notaroomba/keybytes/assets/readme/keyboard.png

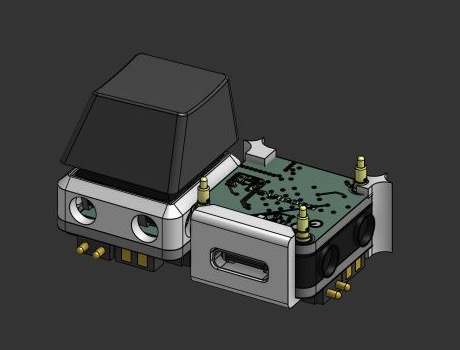
assets/readme/keyboard.png
