notaroomba/keybytes/assets/render.png

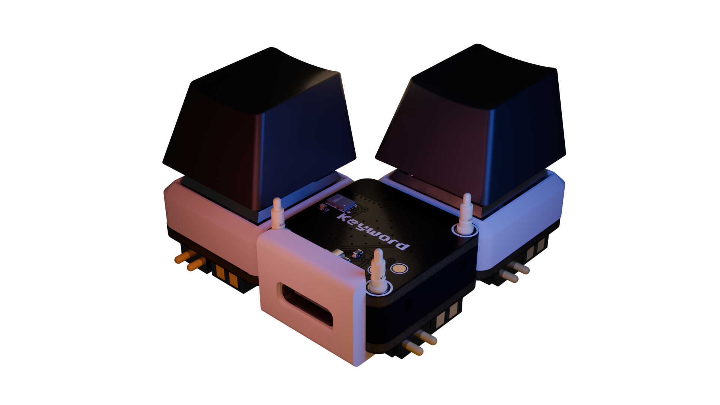
assets/render.png
