notaroomba/keybytes/hardware/panels/8x3-panel/8x3-panel-bottom.png

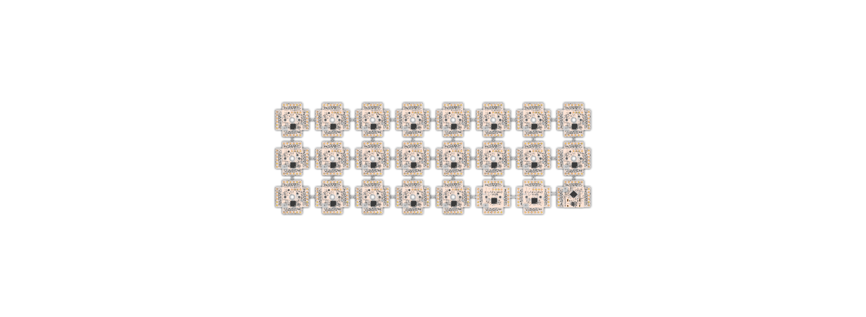
hardware/panels/8x3-panel/8x3-panel-bottom.png
