notaroomba/keybytes/hardware/panels/spacer-panel/spacer-panel-bottom.png

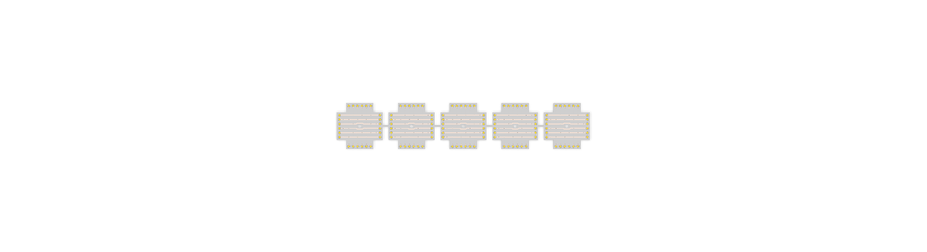
hardware/panels/spacer-panel/spacer-panel-bottom.png
