notaroomba/keybytes/hardware/spacer/spacer-0.5u-bottom.png

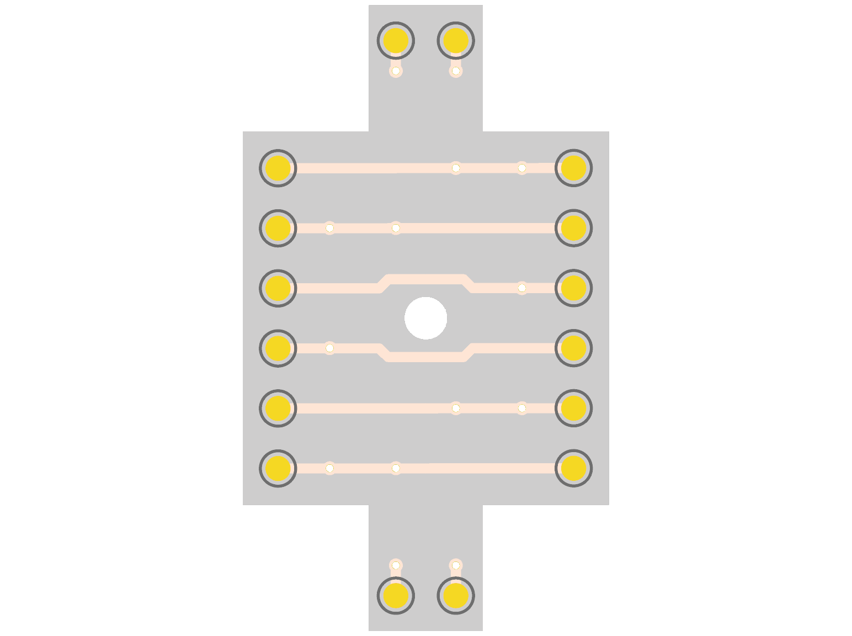
hardware/spacer/spacer-0.5u-bottom.png
