notaroomba/keybytes/hardware/spacer/spacer-0.75u-bottom.png

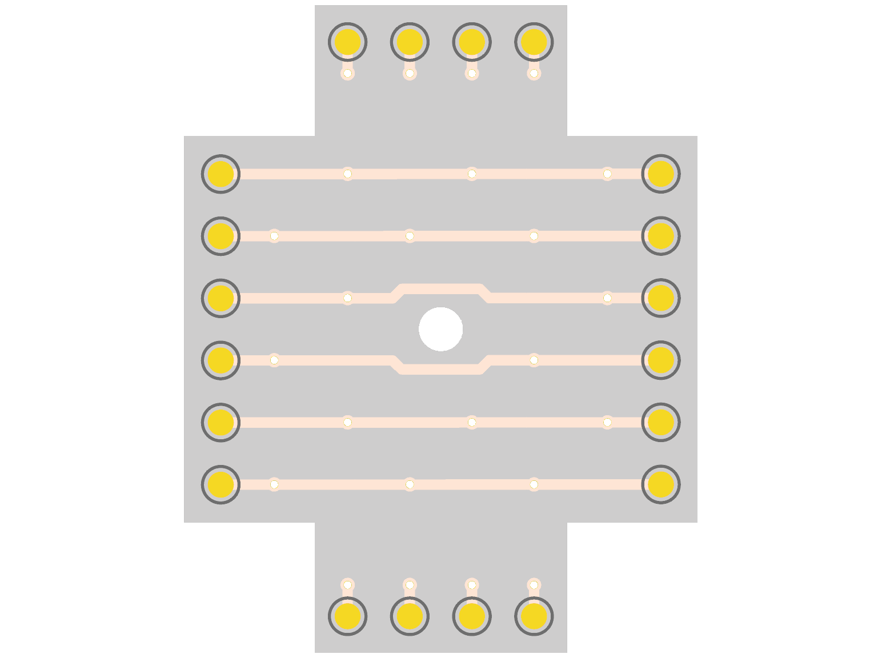
hardware/spacer/spacer-0.75u-bottom.png
