notaroomba/keybytes/hardware/spacer/spacer-0.75u-top.png

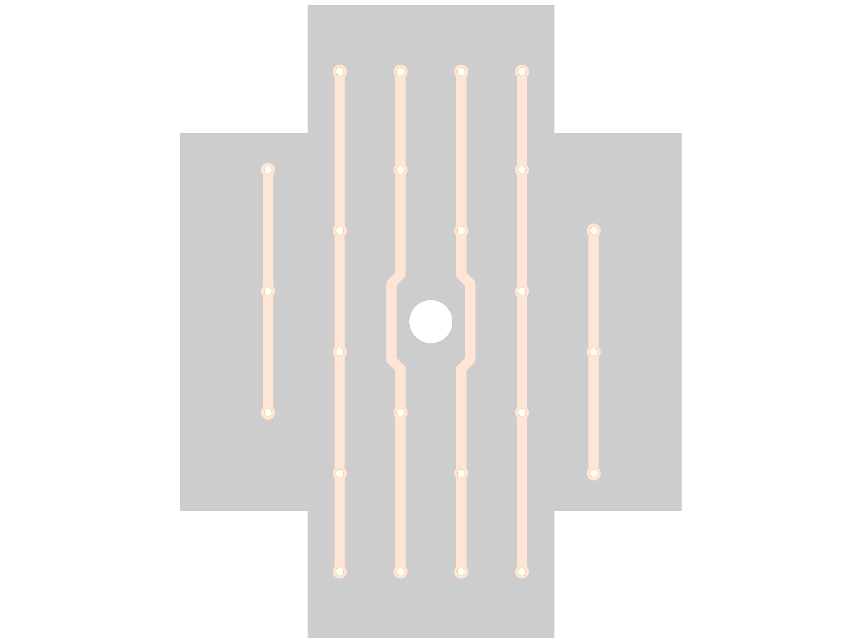
hardware/spacer/spacer-0.75u-top.png
