notaroomba/keybytes/hardware/spacer/spacer-1u-bottom.png

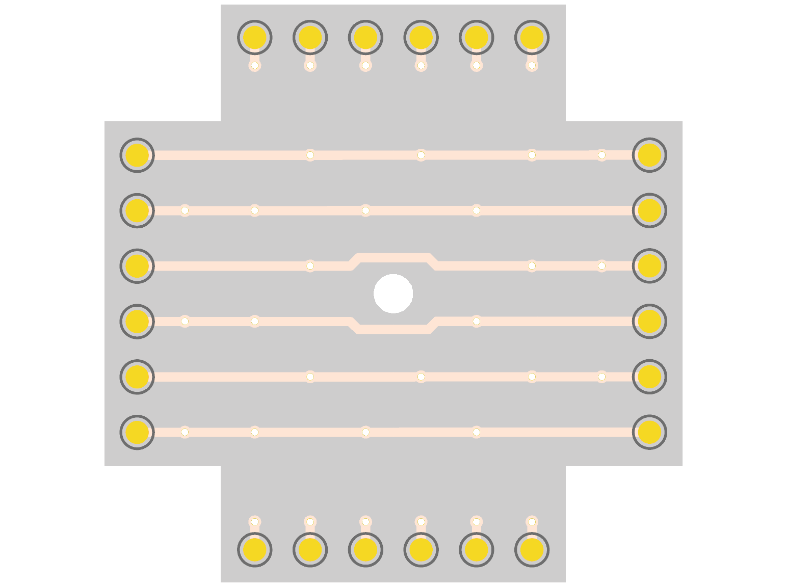
hardware/spacer/spacer-1u-bottom.png
