notaroomba/keybytes/hardware/spacer/spacer-1u-top.png

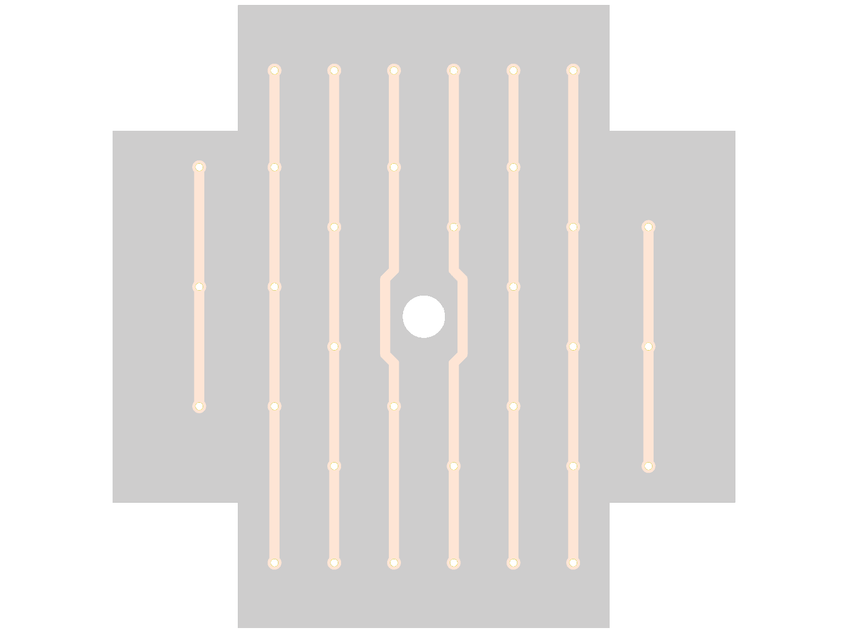
hardware/spacer/spacer-1u-top.png
