notaroomba/keybytes/image.png

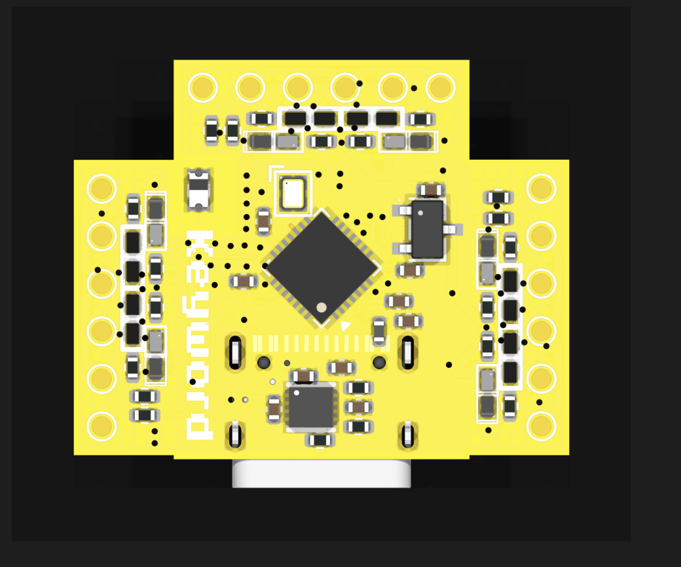
image.png
