notaroomba/keybytes/BOM.csv

Item | Price | Source
Magnets 2x0.5mm (1000pcs) | 8.83 | https://es.aliexpress.com/item/1005009461785489.html
Keybit PCB (5pcs | Black HASL) | 2.00 | https://jlcpcb.com
Keybit PCBA (5pcs | bottom side) | 69.67 | https://jlcpcb.com
Keyword PCB (5pcs | White ENIG) | 30.50 | https://jlcpcb.com
Keyword PCBA (2pcs | both sides) | 203.60 | https://jlcpcb.com
JLCPCB Shipping | 158.17 | https://jlcpcb.com
Total | 472.77
