notaroomba/keybytes/hardware/keybit/production/bom.csv

Designator | Footprint | Quantity | Value | LCSC Part #
ANT1 | ANT-SMD_L1.7-W0.9 | 1 | KH-1608-H08 | C2925416
C10, C11 | 0402 | 2 | 100nF | C1525
C3, C4, C5 | 0402 | 3 | 1uF | C52923
C8 | 0402 | 1 | 470nF | C47339
C9 | 0402 | 1 | 4.7uF | C23733
D2 | LED_WS2812B-2020_PLCC4_2.0x2.0mm | 1 | WS2812B-2020 | C52917434
L1 | 0402 | 1 | 10uH | C48946156
Q10, Q11, Q15, Q16, Q21, Q22, Q27, Q7 | DFN1006-3L_L1.0-W0.6-LS1.0-BR | 8 | CJBA3139K | C504099
Q12, Q13, Q14, Q17, Q18, Q19, Q20, Q23, Q24, Q25, Q26, Q4, Q5, Q6, Q8, Q9 | SOT-883-3_L1.0-W0.6-BR | 16 | PNM3FD20V1E | C2875806
R10, R14, R19, R20, R25, R26, R31, R9 | 0402 | 8 | 1M | C26083
R11, R12, R15, R16, R18, R21, R22, R24, R27, R28, R30, R8 | 0402 | 12 | 100K | C25741
R13, R17, R23, R29 | 0402 | 4 | 300K | C25774
U1 | WQFN-28-1EP_4x4mm_P0.4mm_EP2.7x2.7mm | 1 | CH592F | C39831287
U12, U15 | CONN-TH_3305-2-15-15-47-27-10-0 | 2 | 3305-0-15-15-47-27-10-0 | C17317022
U14 | SOT-23-3_L2.9-W1.6-P1.90-LS2.8-BR | 1 | XC6206P332MR | C5446
U2, U3, U4, U5, U6, U7, U8, U9 | X1-DFN1006-2_L1.0-W0.6-RD | 8 | RB520CS30L,315 | C461213
X2 | CRYSTAL-SMD_4P-L1.6-W1.2-BL | 1 | 7E032000I01 | C781732
