notaroomba/keybytes/production/panels/8x3-panel/bom.csv

Comment | Designator | Footprint | LCSC
100K | KB_R8,KB_R11,KB_R12,KB_R15,KB_R16,KB_R18,KB_R21,KB_R22,KB_R24,KB_R27,KB_R28,KB_R30,KW_R8,KW_R11,KW_R12,KW_R21,KW_R22,KW_R24,KW_R27,KW_R28,KW_R30,R8,R11,R12,R15,R16,R18,R21,R22,R24,R27,R28,R30 | Resistor_SMD:R_0402_1005Metric | C25741
PNM3FD20V1E | KB_Q4,KB_Q5,KB_Q6,KB_Q8,KB_Q9,KB_Q12,KB_Q13,KB_Q14,KB_Q17,KB_Q18,KB_Q19,KB_Q20,KB_Q23,KB_Q24,KB_Q25,KB_Q26,KW_Q4,KW_Q6,KW_Q8,KW_Q9,KW_Q17,KW_Q18,KW_Q19,KW_Q20,KW_Q23,KW_Q24,KW_Q25,KW_Q26,Q4,Q5,Q6,Q8,Q9,Q12,Q13,Q14,Q17,Q18,Q19,Q20,Q23,Q24,Q25,Q26 | lcsc:SOT-883-3_L1.0-W0.6-BR | C2875806
TMAG3001A2YBGR | U10 | lcsc:BGA-6_L1.3-W0.8-P0.40-TL_PTMAG3001A2YBGR | C31115089
CH592F | KB_U1,KW_U1,U1 | Package_DFN_QFN:WQFN-28-1EP_4x4mm_P0.4mm_EP2.7x2.7mm | C39831287
100nF | C10,C11,C12,KB_C10,KB_C11,KW_C10,KW_C11 | Capacitor_SMD:C_0402_1005Metric | C1525
1M | KB_R9,KB_R10,KB_R14,KB_R19,KB_R20,KB_R25,KB_R26,KB_R31,KW_R9,KW_R10,KW_R20,KW_R25,KW_R26,KW_R31,R9,R10,R14,R19,R20,R25,R26,R31 | Resistor_SMD:R_0402_1005Metric | C26083
RB520CS30L,315 | KB_U2,KB_U3,KB_U4,KB_U5,KB_U6,KB_U7,KB_U8,KB_U9,KW_U2,KW_U3,KW_U6,KW_U7,KW_U8,KW_U9,U2,U3,U4,U5,U6,U7,U8,U9 | lcsc:X1-DFN1006-2_L1.0-W0.6-RD | C461213
CJBA3139K | KB_Q7,KB_Q10,KB_Q11,KB_Q15,KB_Q16,KB_Q21,KB_Q22,KB_Q27,KW_Q7,KW_Q10,KW_Q16,KW_Q21,KW_Q22,KW_Q27,Q7,Q10,Q11,Q15,Q16,Q21,Q22,Q27 | lcsc:DFN1006-3L_L1.0-W0.6-LS1.0-BR | C504099
470nF | C8,KB_C8,KW_C8 | Capacitor_SMD:C_0402_1005Metric | C47339
1uF | C3,C4,C5,KB_C3,KB_C4,KB_C5,KW_C3,KW_C4,KW_C5,KW_C6,KW_C7 | Capacitor_SMD:C_0402_1005Metric | C52923
300K | KB_R13,KB_R17,KB_R23,KB_R29,KW_R13,KW_R23,KW_R29,R13,R17,R23,R29 | Resistor_SMD:R_0402_1005Metric | C25774
4.7uF | C9,KB_C9,KW_C9 | Capacitor_SMD:C_0402_1005Metric | C23733
WS2812B-2020 | D2,KB_D2,KW_D2 | LED_SMD:LED_WS2812B-2020_PLCC4_2.0x2.0mm | C52917434
KH-1608-H08 | ANT1,KB_ANT1,KW_ANT1 | lcsc:ANT-SMD_L1.7-W0.9 | C2925416
7E032000I01 | KB_X2,KW_X2,X2 | lcsc:CRYSTAL-SMD_4P-L1.6-W1.2-BL | C781732
XC6206P332MR | KB_U14,KW_U14,U14 | lcsc:SOT-23-3_L2.9-W1.6-P1.90-LS2.8-BR | C5446
10uH | KB_L1,KW_L1,L1 | Inductor_SMD:L_0402_1005Metric | C48946156
4.7K | R32,R33 | Resistor_SMD:R_0402_1005Metric | C25900
YZ87312060R-01 | KW_TP1,KW_TP2,KW_TP3,KW_TP4 | lcsc:POGO-SMD_YZ87312060R-01 | C5157406
5.1K | KW_R4,KW_R6 | Resistor_SMD:R_0402_1005Metric | C25905
50pF | KW_C13 | Capacitor_SMD:C_0402_1005Metric | C49210433
BQ25185DLHR | KW_U5 | lcsc:WSON-10_L2.2-W2.0-P0.40-BL-EP_TI_DLH0010A | C19725033
10K | KW_R3 | Resistor_SMD:R_0402_1005Metric | C25744
10uF | KW_C2 | Capacitor_SMD:C_0402_1005Metric | C6119763
15K | KW_R2 | Resistor_SMD:R_0402_1005Metric | C25756
USB_C_Receptacle_USB2.0_16P | KW_J2 | Connector_USB:USB_C_Receptacle_HCTL_HC-TYPE-C-16P-01A | C2894897
4.7uF\n35V | KW_C1 | Capacitor_SMD:C_0603_1608Metric | C307467
USBLC6-2P6 | KW_U4 | Package_TO_SOT_SMD:SOT-666 | C53059594
13K | KW_R1 | Resistor_SMD:R_0402_1005Metric | C49653083
3305-0-15-15-47-27-10-0 | KB_U12,KB_U15 | lcsc:CONN-TH_3305-2-15-15-47-27-10-0 | C17317022
