notaroomba/keybytes/assets/jlcpcb_order.png

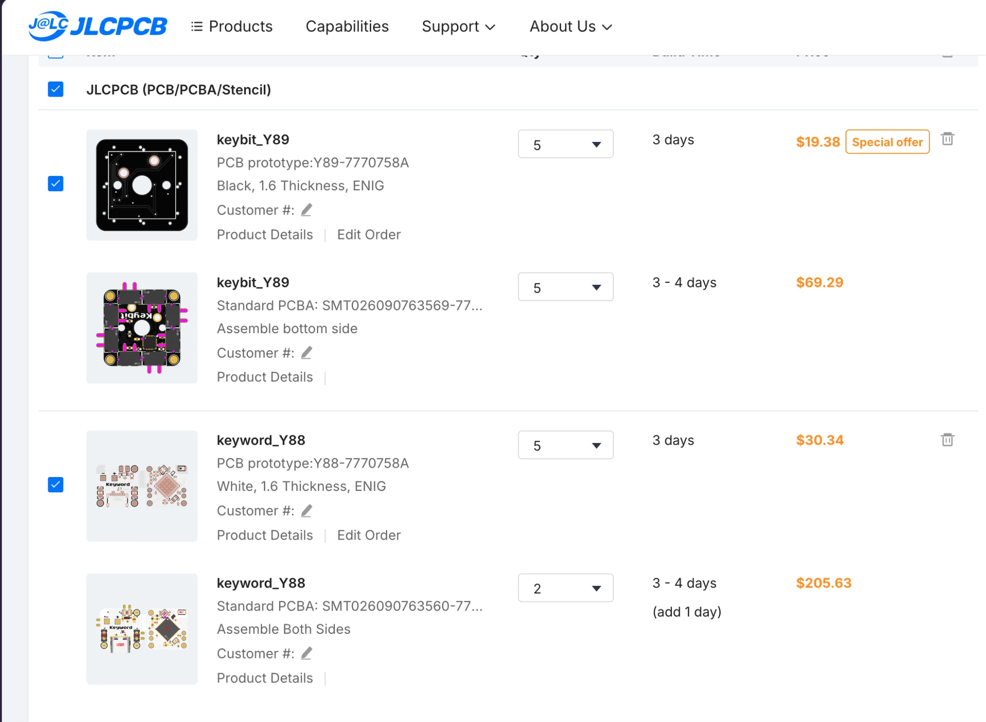
assets/jlcpcb_order.png
