notaroomba/keybytes/cad/keybit/Joystick_Body.step

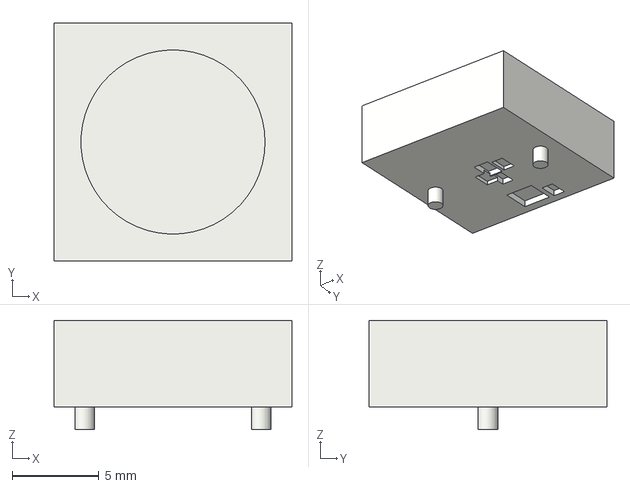
[picture p23: CAD file, 2026-11-13]
cad/keybit/Joystick_Body.step
13.7 x 13.7 x 6.30 mm
