notaroomba/keybytes/cad/keybit/pcb/Keybit_Flex_Folded.step

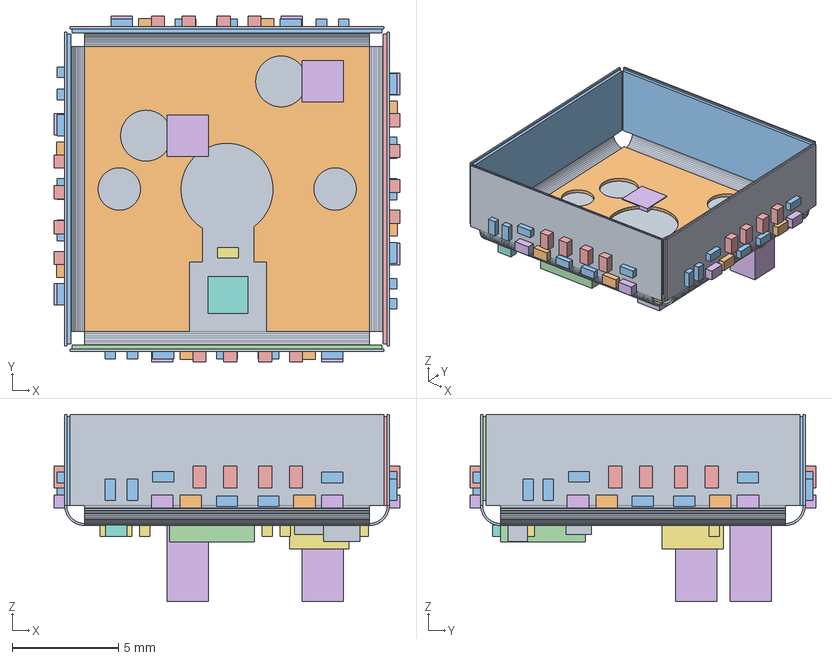
[picture p24: CAD file, 2026-11-13]
cad/keybit/pcb/Keybit_Flex_Folded.step
16.3 x 16.3 x 8.83 mm
Flex
Stiffener
CONN-TH_3305-2-15-15-47-27-10-0 x 2
C_0402_1005Metric x 7
LED_WS2812B_PLCC4_5_0x5_0mm_P3_2mm
CRYSTAL-SMD_4P-L1_6-W1_2-BL
DFN1006-3L_L1_0-W0_6-H0_4-LS1_0-BR x 8
R_0402_1005Metric x 24
QFN-28-1EP_4x4mm_P0_4mm_EP2_4x2_4mm
SOT-883-3_L1_0-W0_6-H0_5-BR x 16
DFN1006_L1_0-W0_6-H0_5 x 8
SOT-23-3L_L2_9-W1_6-H1_1-LS2_8-P0_95
L_0402_1005Metric
ANT-SMD_L1_7-W0_9
