notaroomba/keybytes/cad/Keybit_Case_Big.step

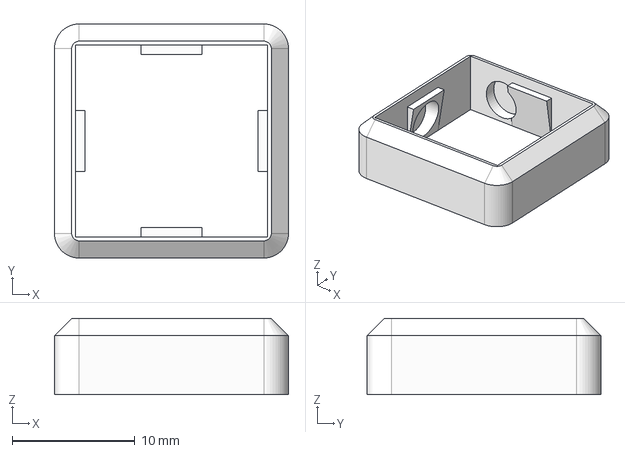
[picture p25: CAD file, 2026-10-25]
cad/Keybit_Case_Big.step
19.1 x 19.1 x 6.20 mm
