notaroomba/keybytes/cad/keyword/Keyword_Base.step

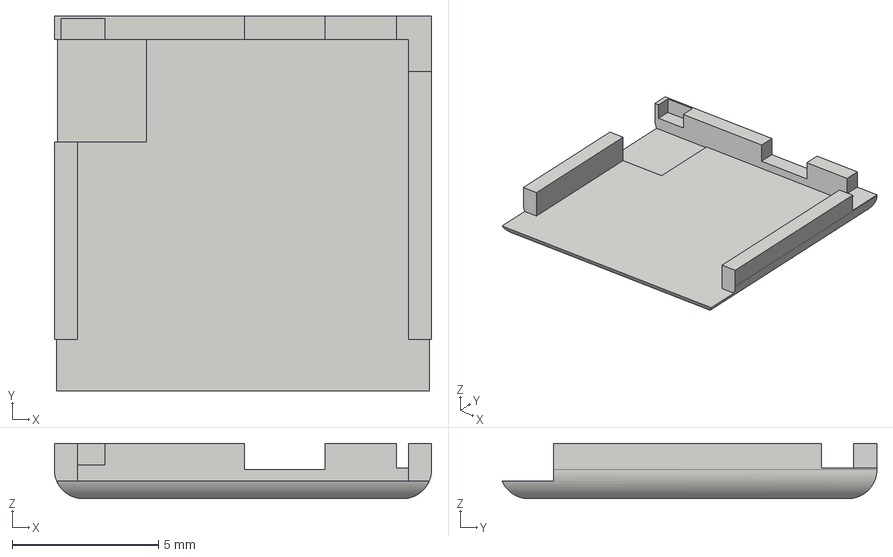
[picture p26: CAD file, 2026-11-13]
cad/keyword/Keyword_Base.step
12.9 x 12.8 x 1.90 mm
