notaroomba/keybytes/cad/keyword/pcb/Keyword_Flex_Folded.step

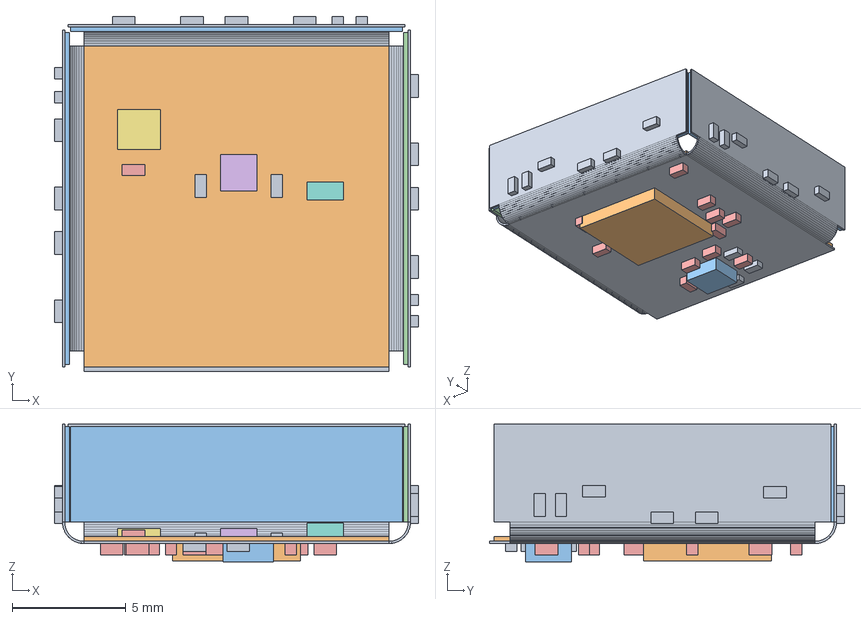
[picture p27: CAD file, 2026-11-13]
cad/keyword/pcb/Keyword_Flex_Folded.step
16.0 x 15.6 x 6.04 mm
Flex
Stiffener
C_0402_1005Metric x 11
SOT-666
LED_WS2812B_PLCC4_5_0x5_0mm_P3_2mm
C_0603_1608Metric
R_0402_1005Metric x 23
QFN-28-1EP_4x4mm_P0_4mm_EP2_4x2_4mm
L_0402_1005Metric
WSON-10_L2_2-W2_0-P0_40-BL-EP_TI_DLH0010
