notaroomba/keybytes/cad/tests/J7.1_keybit_protruding.step

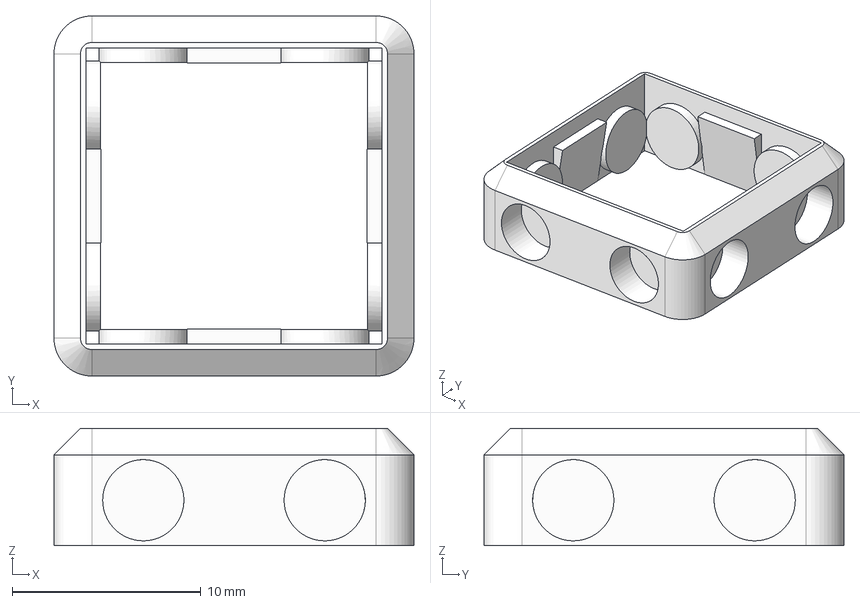
[picture p28: CAD file, 2026-10-25]
cad/tests/J7.1_keybit_protruding.step
19.1 x 19.1 x 6.20 mm
