notaroomba/keybytes/hardware/keybit/keybit.step

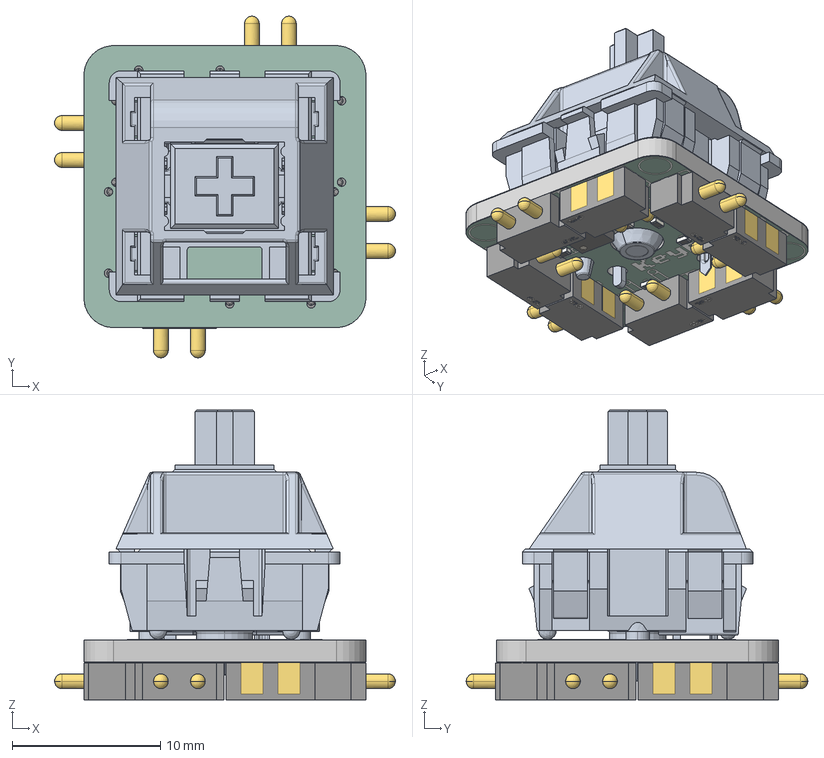
[picture p29: CAD file, 2026-04-08]
hardware/keybit/keybit.step
23.0 x 23.1 x 19.6 mm
MX_DOWN
MX_UP
UP_MX
MX_PIN
MX_SPRING
MX_CLICK
CONN-SMD_YZ13515055F-02025-02 x 8
QFN-16-1EP_3x3mm_P0.5mm_EP1.8x1.8mm
R_0402_1005Metric x 8
C_0402_1005Metric
keybit_copper
keybit_via
keybit_silkscreen x 2
keybit_soldermask x 2
keybit_PCB
