notaroomba/keybytes/production/CAD/Encoder_Body.step

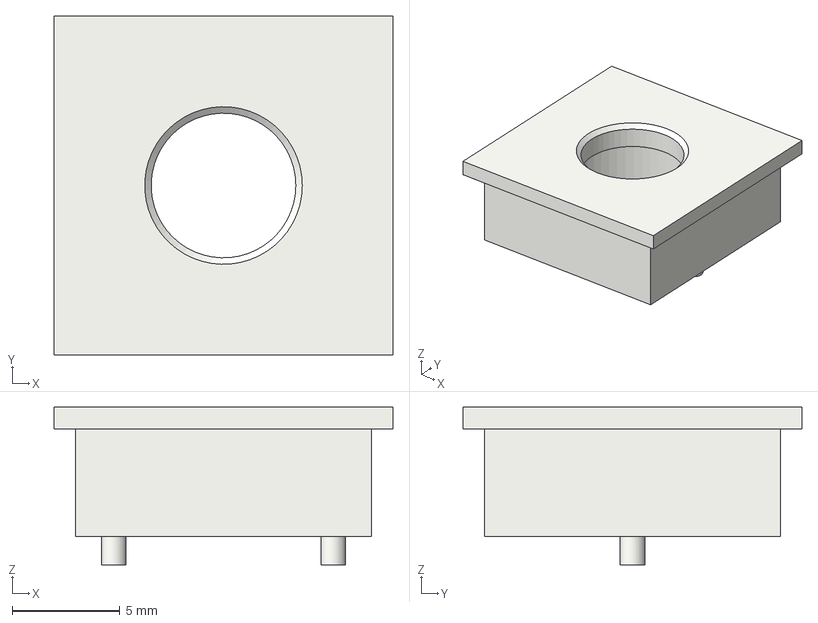
[picture p30: CAD file, 2026-11-13]
production/CAD/Encoder_Body.step
15.7 x 15.7 x 7.30 mm
