notaroomba/keybytes/cad/keybit/Joystick_Deck.step

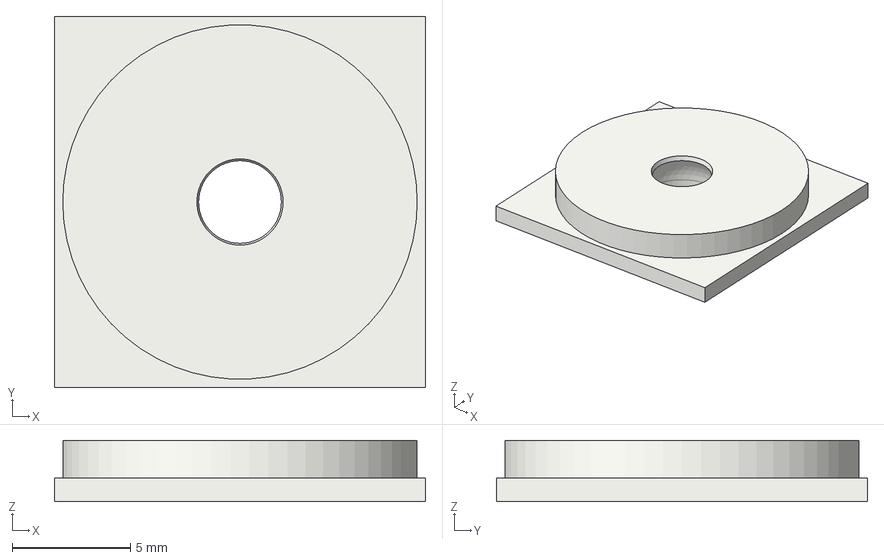
[picture p31: CAD file, 2026-11-13]
cad/keybit/Joystick_Deck.step
15.7 x 15.7 x 2.60 mm
