notaroomba/keybytes/cad/keyword/Keyword_Lid.step

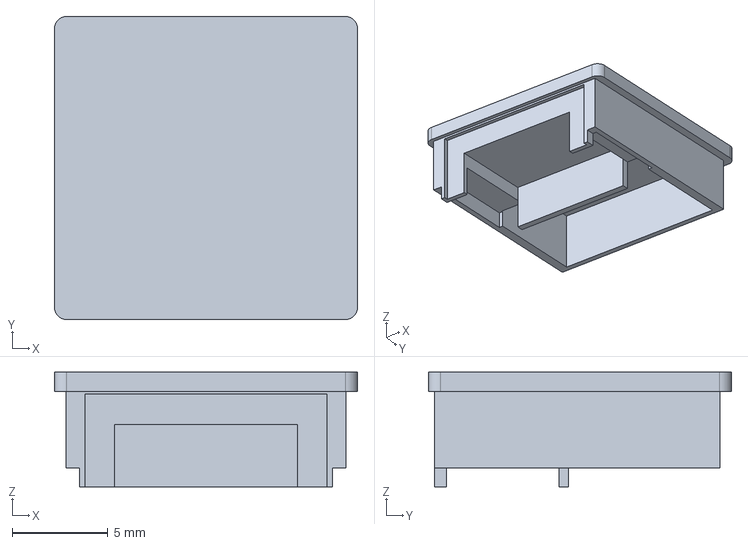
[picture p33: CAD file, 2026-11-13]
cad/keyword/Keyword_Lid.step
15.8 x 15.8 x 5.98 mm
