notaroomba/keybytes/cad/Keyword_Case_Big_Inner.step

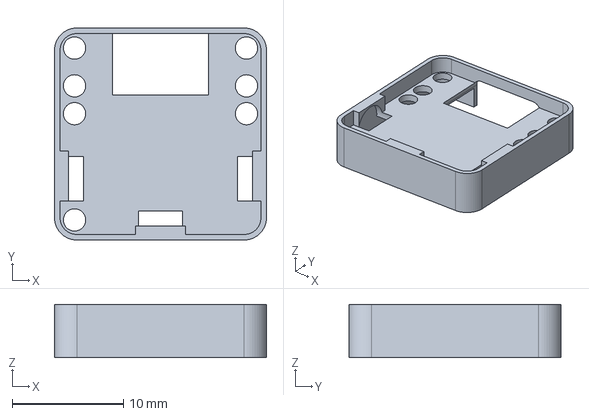
[picture p34: CAD file, 2026-10-25]
cad/Keyword_Case_Big_Inner.step
19.1 x 19.1 x 4.80 mm
