notaroomba/keybytes/cad/tests/J1_magnets_only.step

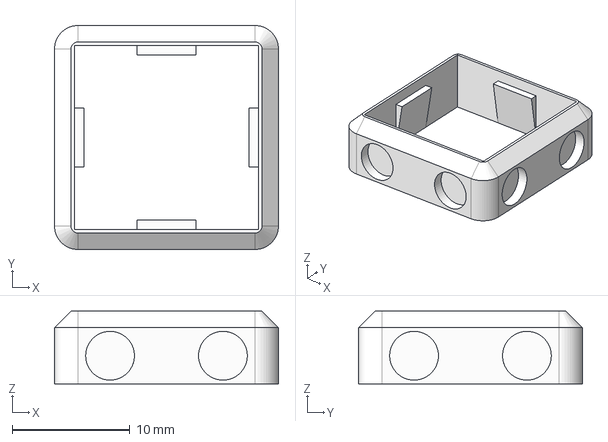
[picture p35: CAD file, 2026-10-25]
cad/tests/J1_magnets_only.step
19.1 x 19.1 x 6.20 mm
