notaroomba/keybytes/production/CAD/Keybit_Shell.step

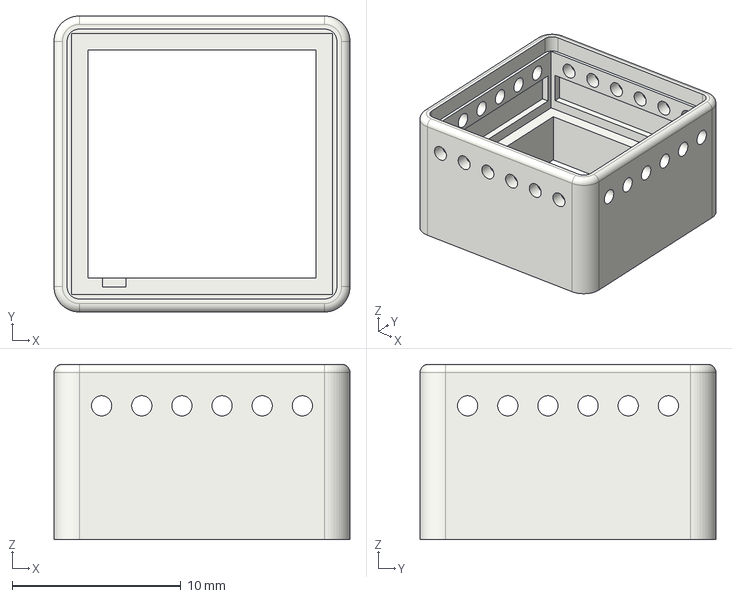
[picture p37: CAD file, 2026-11-13]
production/CAD/Keybit_Shell.step
17.6 x 17.6 x 10.4 mm
