notaroomba/keybytes/cad/keybit/Encoder_Collar.step

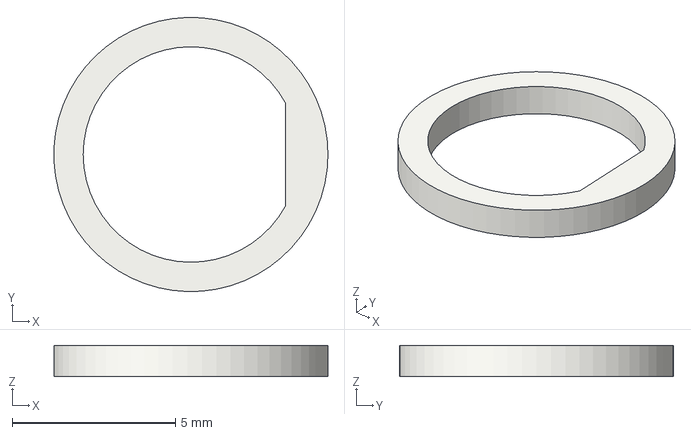
[picture p38: CAD file, 2026-11-13]
cad/keybit/Encoder_Collar.step
8.39 x 8.40 x 0.95 mm
