notaroomba/keybytes/cad/Keyword_Left.step

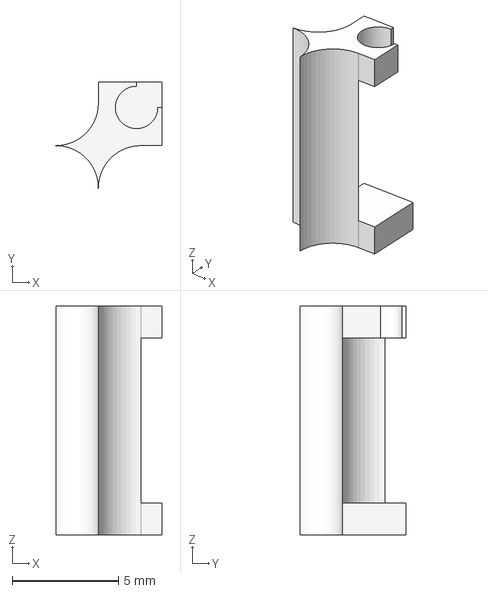
[picture p39: CAD file, 2026-10-21]
cad/Keyword_Left.step
5.00 x 5.00 x 10.8 mm
