notaroomba/keybytes/cad/tests/J5_slip_pegs.step

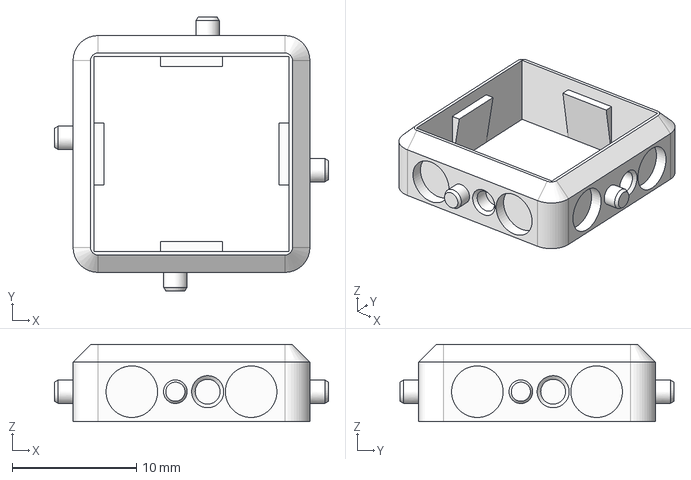
[picture p40: CAD file, 2026-10-25]
cad/tests/J5_slip_pegs.step
22.0 x 22.0 x 6.20 mm
