notaroomba/keybytes/hardware/keybit/keybit_nokey.step

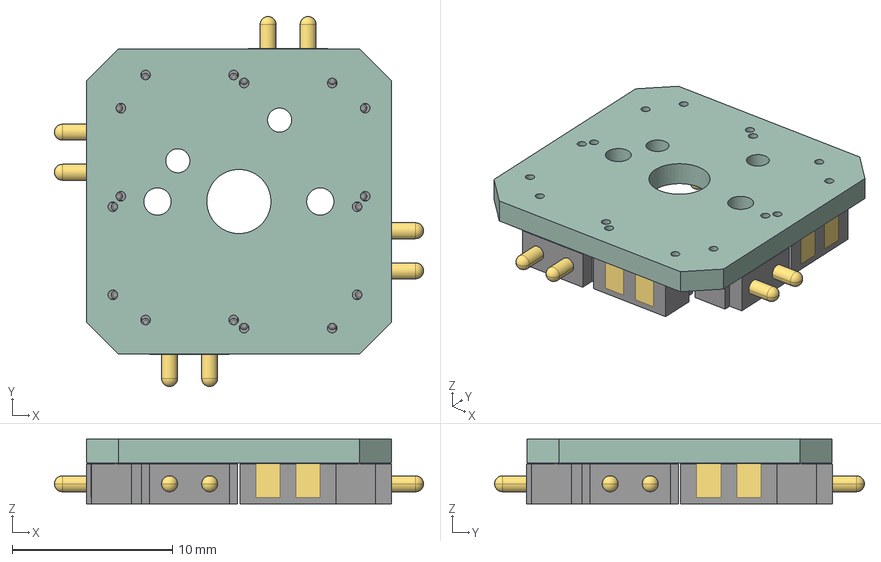
[picture p41: CAD file, 2026-04-06]
hardware/keybit/keybit_nokey.step
23.0 x 23.1 x 4.05 mm
CONN-SMD_YZ13515055F-02025-02 x 8
QFN-16-1EP_3x3mm_P0.5mm_EP1.8x1.8mm
R_0402_1005Metric x 8
C_0402_1005Metric
keybit_PCB
