notaroomba/keybytes/production/CAD/Keyword_Shell.step

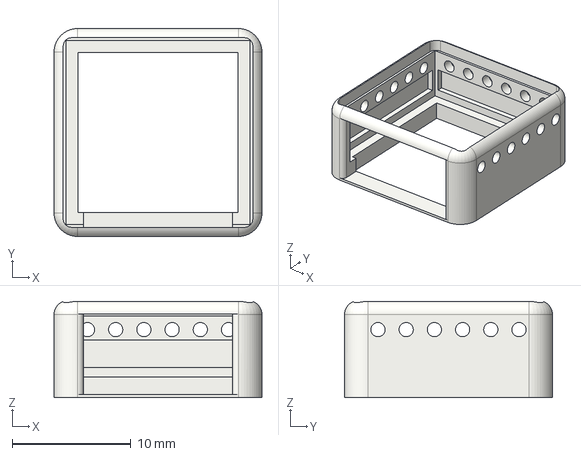
[picture p42: CAD file, 2026-11-13]
production/CAD/Keyword_Shell.step
17.6 x 17.6 x 8.12 mm
