notaroomba/keybytes/cad/keybit/Keybit_Base.step

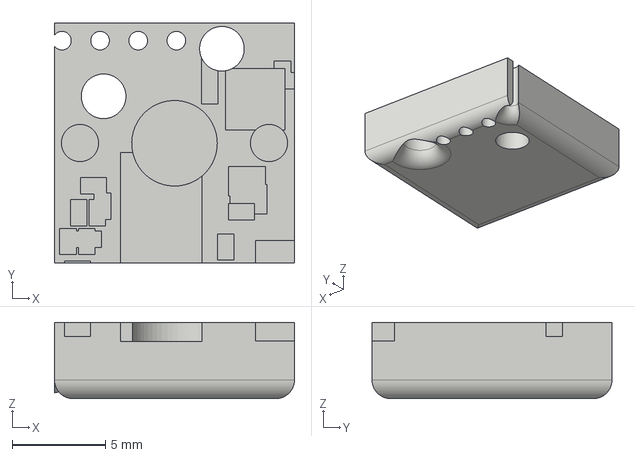
[picture p43: CAD file, 2026-11-13]
cad/keybit/Keybit_Base.step
12.9 x 12.9 x 4.10 mm
