notaroomba/keybytes/cad/Keyword_Case.step

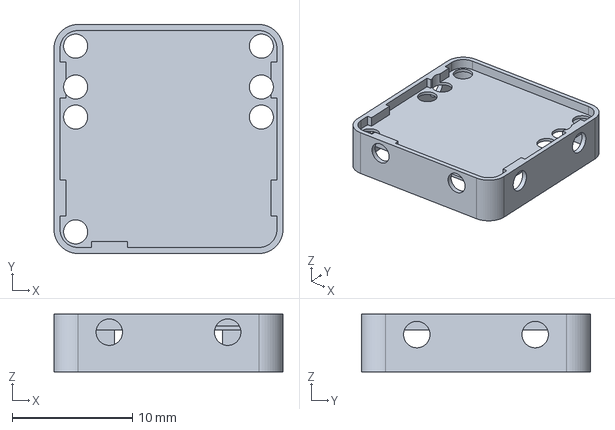
[picture p44: CAD file, 2026-10-20]
cad/Keyword_Case.step
19.1 x 19.1 x 4.80 mm
