notaroomba/keybytes/cad/keybit/Encoder_Knob_CNC.step

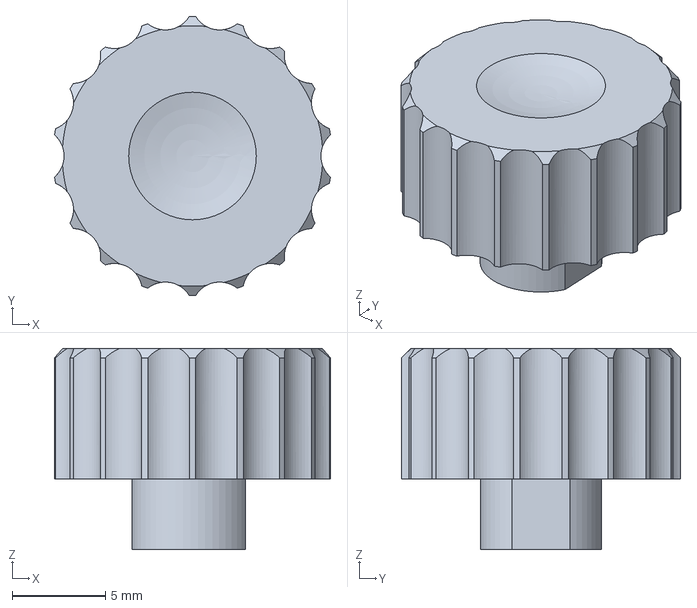
[picture p45: CAD file, 2026-11-13]
cad/keybit/Encoder_Knob_CNC.step
14.8 x 15.0 x 10.8 mm
