notaroomba/keybytes/cad/tests/JIG_keybit_J7_inner.step

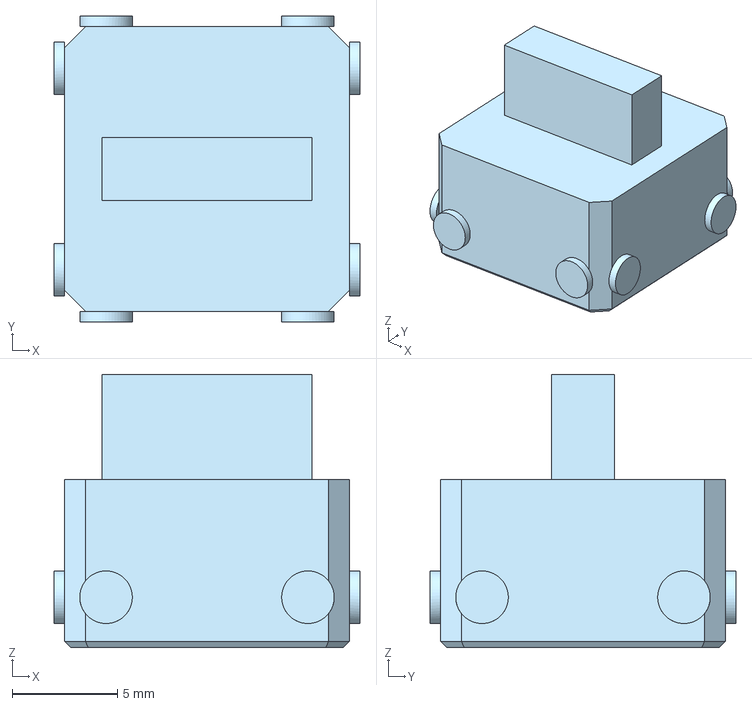
[picture p46: CAD file, 2026-10-25]
cad/tests/JIG_keybit_J7_inner.step
14.6 x 14.6 x 13.0 mm
