notaroomba/keybytes/production/CAD/Joystick_Stick.step

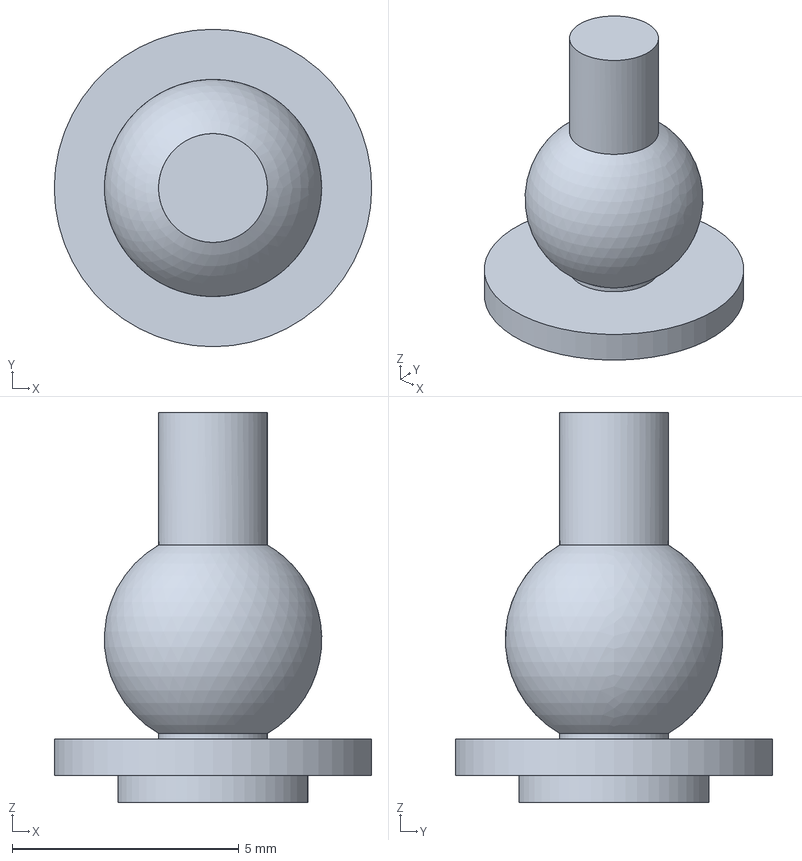
[picture p47: CAD file, 2026-11-13]
production/CAD/Joystick_Stick.step
7.00 x 7.00 x 8.60 mm
