notaroomba/keybytes/cad/tests/J7.1_keyword_protruding.step

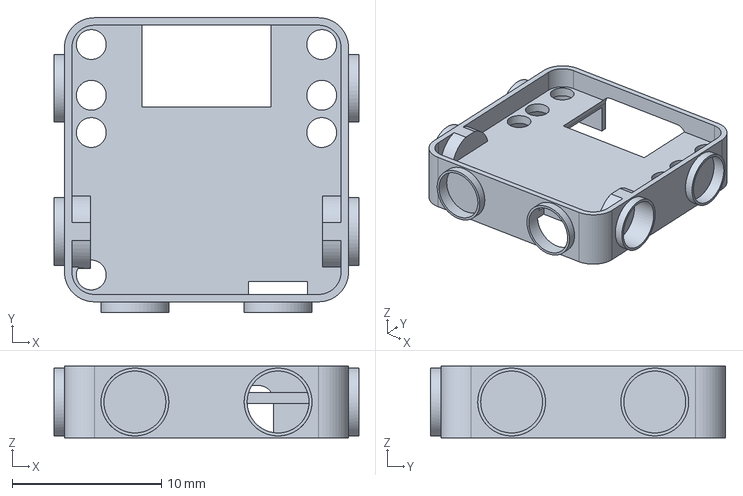
[picture p48: CAD file, 2026-10-25]
cad/tests/J7.1_keyword_protruding.step
20.4 x 19.8 x 4.80 mm
