notaroomba/keybytes/production/CAD/Joystick_Cap.step

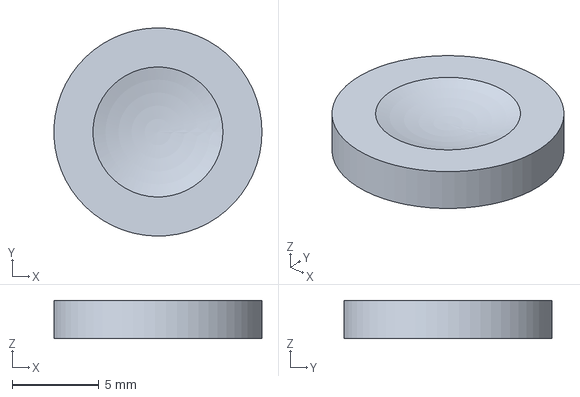
[picture p49: CAD file, 2026-11-13]
production/CAD/Joystick_Cap.step
12.0 x 12.0 x 2.20 mm
