notaroomba/keybytes/cad/tests/J4_sliding_dovetail.step

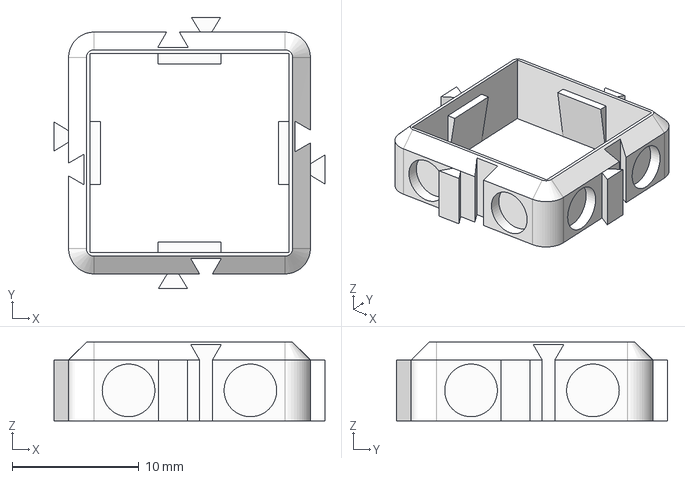
[picture p50: CAD file, 2026-10-25]
cad/tests/J4_sliding_dovetail.step
21.3 x 21.3 x 6.20 mm
