notaroomba/keybytes/production/CAD/Keyword_Case_Big_Inner.step

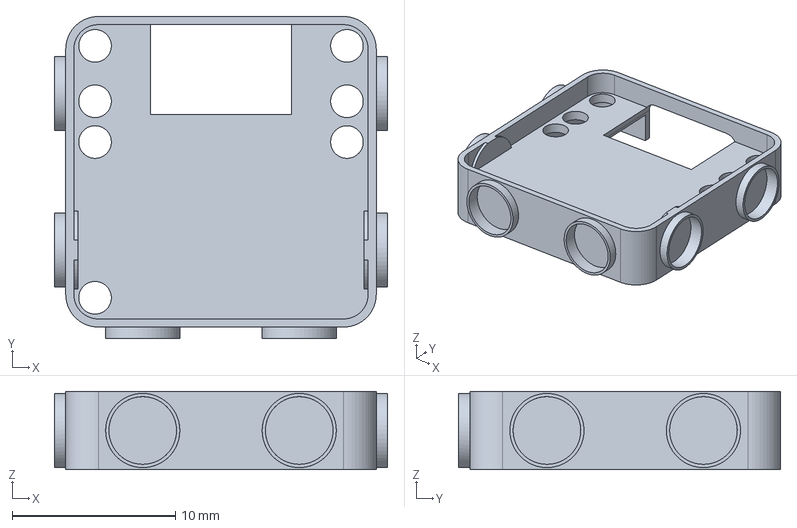
[picture p51: CAD file, 2026-10-25]
production/CAD/Keyword_Case_Big_Inner.step
20.4 x 19.8 x 4.80 mm
