notaroomba/keybytes/production/CAD/Keybit_Case_Big.step

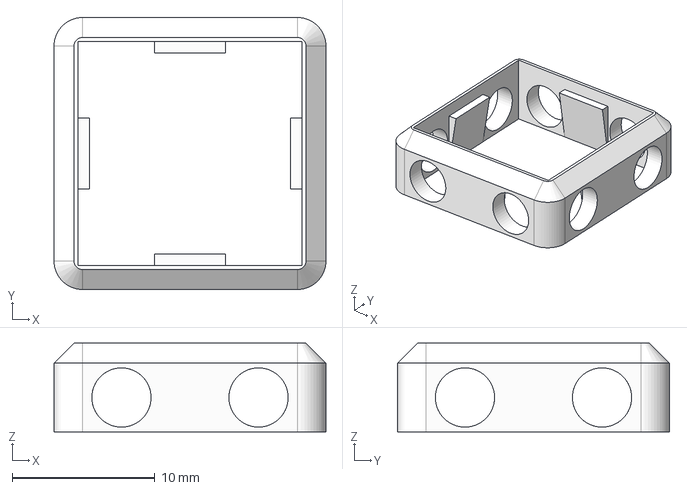
[picture p52: CAD file, 2026-10-25]
production/CAD/Keybit_Case_Big.step
19.1 x 19.1 x 6.20 mm
