notaroomba/keybytes/cad/tests/J2_bowtie_case.step

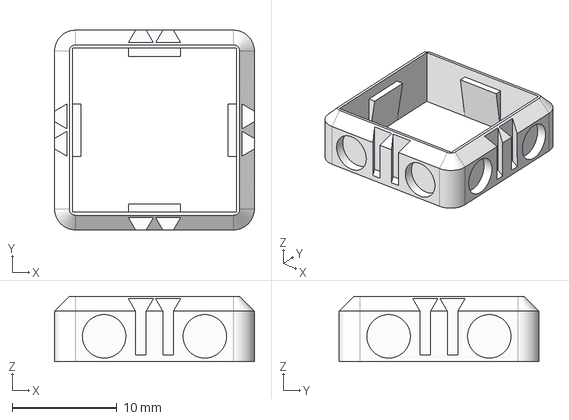
[picture p53: CAD file, 2026-10-25]
cad/tests/J2_bowtie_case.step
19.1 x 19.1 x 6.20 mm
