notaroomba/keybytes/cad/tests/J3_snap_hooks.step

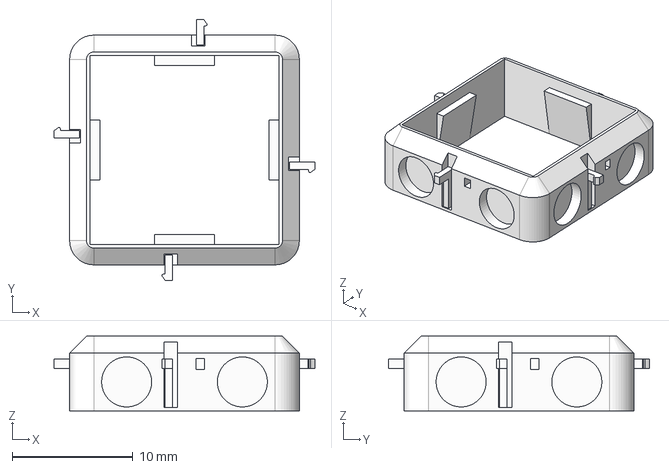
[picture p54: CAD file, 2026-10-25]
cad/tests/J3_snap_hooks.step
21.7 x 21.7 x 6.20 mm
