notaroomba/keybytes/production/CAD/Keycap.step

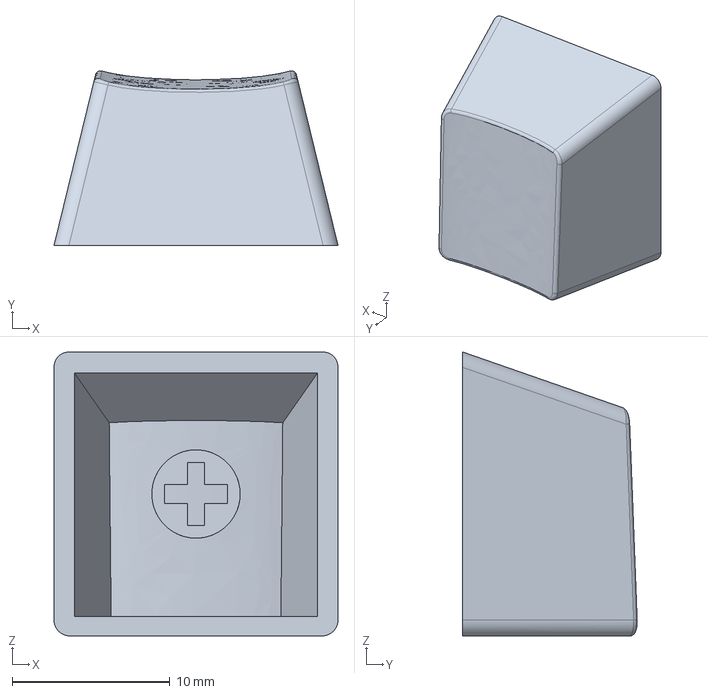
[picture p55: CAD file, 2026-10-02]
production/CAD/Keycap.step
18.0 x 11.1 x 18.0 mm
