notaroomba/keybytes/cad/tests/JIG_keybit_J7_outer_gauge.step

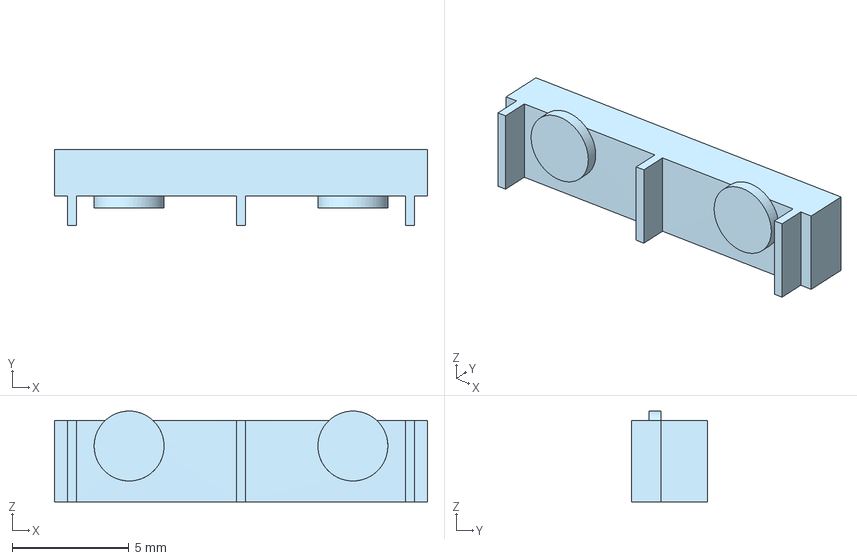
[picture p56: CAD file, 2026-10-25]
cad/tests/JIG_keybit_J7_outer_gauge.step
16.0 x 3.25 x 3.90 mm
