notaroomba/keybytes/cad/tests/MAGNET_pressfit_coupon.step

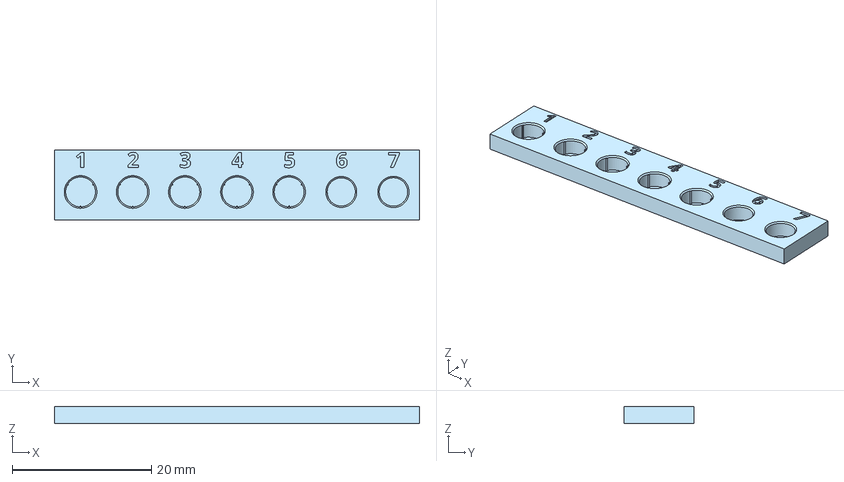
[picture p57: CAD file, 2026-10-25]
cad/tests/MAGNET_pressfit_coupon.step
52.5 x 10.0 x 2.45 mm
