notaroomba/keybytes/cad/tests/J2_bowtie_key.step

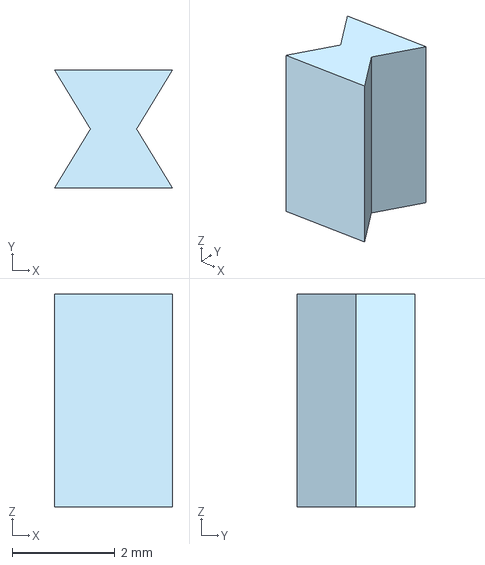
[picture p58: CAD file, 2026-10-25]
cad/tests/J2_bowtie_key.step
2.30 x 2.30 x 4.15 mm
