notaroomba/keybytes/(list of files, cad)

Other CAD files:
cad/tests/J6_crush_rib_pegs.step
production/CAD/Keybit_Hall_Base.step
cad/tests/J7.2_keybit_pressfit.step
production/CAD/Keybit_Hall_Shell.step
cad/tests/J7.1b_keyword_2x4x1.step
production/CAD/Keybit_Case.step
cad/tests/J7_keybit_protruding.step
blender/Keybytes.blend
blender/keybit_snap.blend
blender/keybit_v2.blend
cad/tests/J1_magnets_only.stl
cad/tests/J2_bowtie_case.stl
cad/tests/J2_bowtie_key.stl
cad/tests/J3_snap_hooks.stl
cad/tests/J4_sliding_dovetail.stl
cad/tests/J5_slip_pegs.stl
cad/tests/J6_crush_rib_pegs.stl
cad/tests/J7.1_keybit_protruding.stl
cad/tests/J7.1_keyword_protruding.stl
cad/tests/J7.1b_keyword_2x4x1.stl
cad/tests/J7.2_keybit_pressfit.stl
cad/tests/J7_keybit_protruding.stl
cad/tests/JIG_keybit_J7_inner.stl
cad/tests/JIG_keybit_J7_outer_gauge.stl
cad/tests/MAGNET_pressfit_coupon.stl
cad/tests/superseded/J7.1_keybit_protruding_standoffs.step
cad/tests/superseded/J7.1_keybit_protruding_standoffs.stl
cad/tests/superseded/J7.1_keyword_protruding_standoffs.step
cad/tests/superseded/J7.1_keyword_protruding_standoffs.stl
cad/tests/superseded/J7.1b_keyword_2x4x1_standoffs.step
cad/tests/superseded/J7.1b_keyword_2x4x1_standoffs.stl
cad/tests/superseded/J7_keyword_protruding.step
cad/tests/superseded/J7_keyword_protruding.stl
cad/tests/superseded/J7b_keyword_protruding_1mm.step
cad/tests/superseded/J7b_keyword_protruding_1mm.stl
cad/tests/superseded/J7c_keyword_protruding_2mm.step
cad/tests/superseded/J7c_keyword_protruding_2mm.stl
cad/tests/superseded/JIG_keybit_J7_inner_v1.step
cad/tests/superseded/JIG_keybit_J7_inner_v1.stl
cad/tests/superseded/JIG_keybit_J7_outer_gauge_v1.step
cad/tests/superseded/JIG_keybit_J7_outer_gauge_v1.stl
hardware/keybit/keybit_nokey.3mf
production/CAD/Keybit_Case_Big.stl
production/CAD/Keyword_Case_Big_Inner.stl
