notaroomba/keybytes/hardware/panels/2x3-test-panel/2x3-test-panel-bottom.png

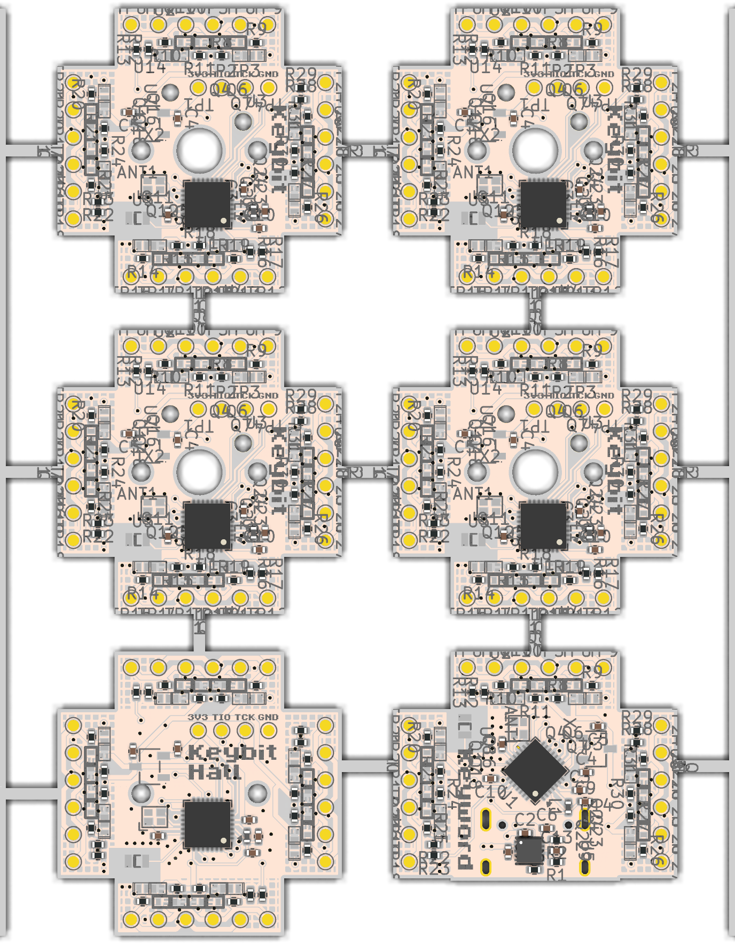
hardware/panels/2x3-test-panel/2x3-test-panel-bottom.png
