notaroomba/keybytes/hardware/panels/2x3-test-panel/2x3-test-panel-top.png

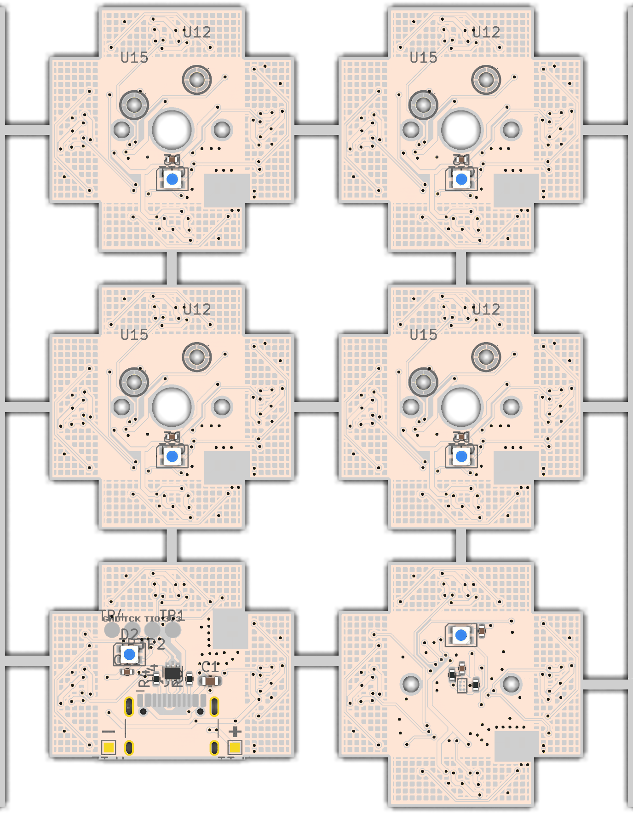
hardware/panels/2x3-test-panel/2x3-test-panel-top.png
