notaroomba/keybytes/JOURNAL.md

<!--
  This journal is auto generated by Stasis.
-->

# 11/12/2026 - finishing the keyword, cleanup and how much this all costs

ok so most of today was finishing routing the keyword. the usb lines were crossed bc the ch592 has d+ on pin 12 and d- on pin 13 but the usblc6 had them the other way around, so d+ had to loop all the way around the d- via on the back which was ugly. instead i just swapped the 2 channels of the usblc6 in the schematic (it doesnt care which one is which) and then on the connector side i ran the d+ tie under the usblc6 between its pad rows so no extra vias. i was worried it would mess up signal integrity but its only full speed usb (12 Mbit/s) and the whole loop is like under 10mm so it literally doesnt matter lol

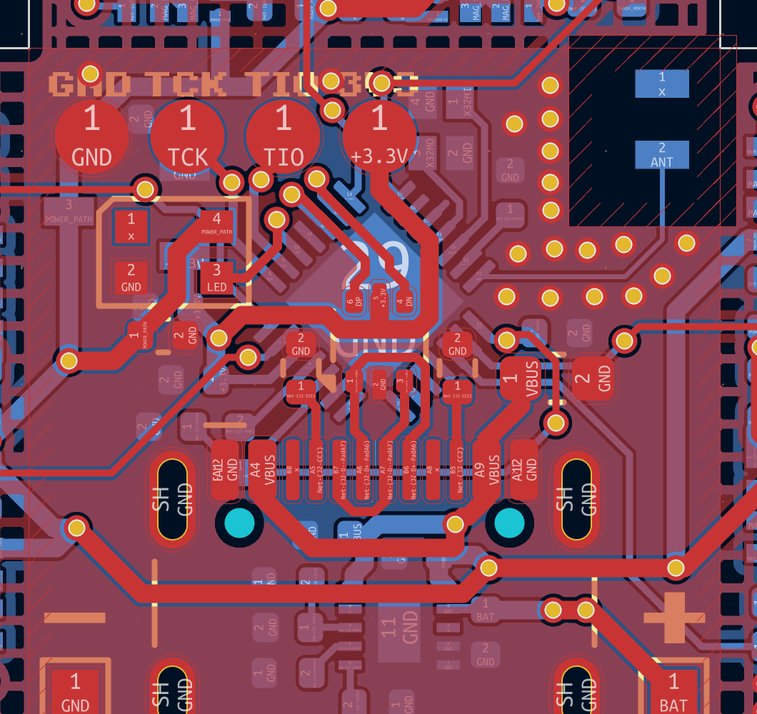
[picture p61: assets/journal/v2/keyword_usb_closeup.png]


i also put the 4 pogo pins on top of the keyword (gnd, tio, tck, 3v3) in the exact same spot as the pads on the bottom of every keybit, so i can flash a bare keybit just by pressing it on and then do everything else over ota. had to move the en_north and dp vias off of them, and the sense_north via is still under tp1 so im fixing that rn. other than that the schematic and board match 100%

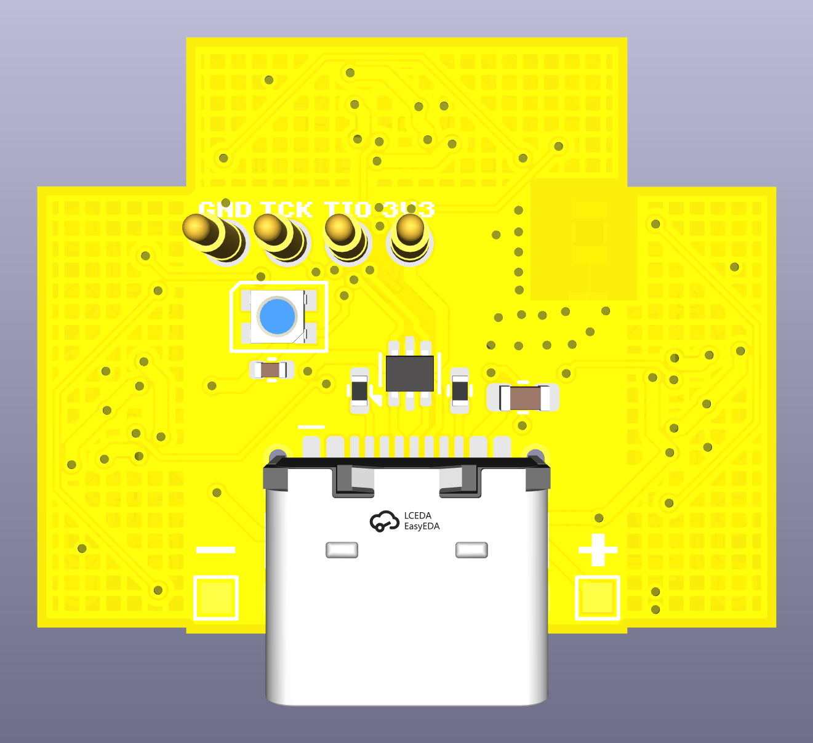
[picture p62: assets/journal/v2/keyword_v2_render_top.png]


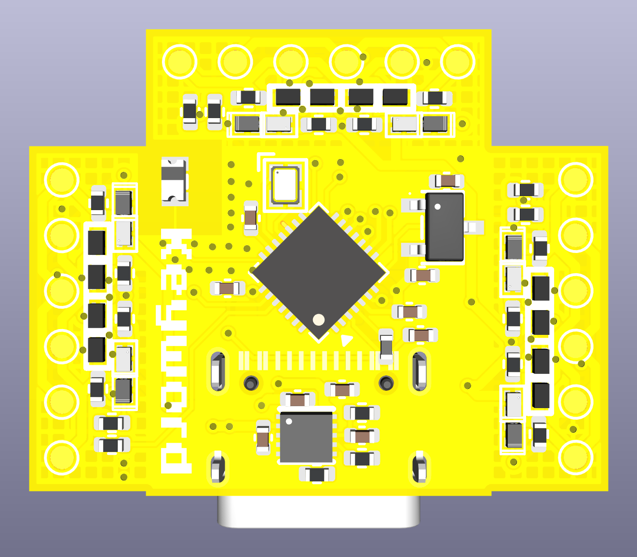
[picture p63: assets/journal/v2/keyword_v2_render_bottom.png]






then i cleaned up the repo. all the v1 stuff (old 4x3 magnet cases, v1 production files, the step to glb script) is in the [`v1`](https://github.com/notaroomba/keybytes/tree/v1) branch now so i deleted it from main and the v2 folders just took the normal names, so its [`cad/keybit`](cad/keybit) and [`cad/keyword`](cad/keyword) now and all the printable parts are in [`production/CAD`](production/CAD). the panels are in [`production/panels`](production/panels) with the bom, positions and gerbers like v1 had for each board.

i also rebuilt the panels from the current boards and only kept the 3 i actually need, the 8x3 panel (the real order), the 2x3 test panel and the spacer panel

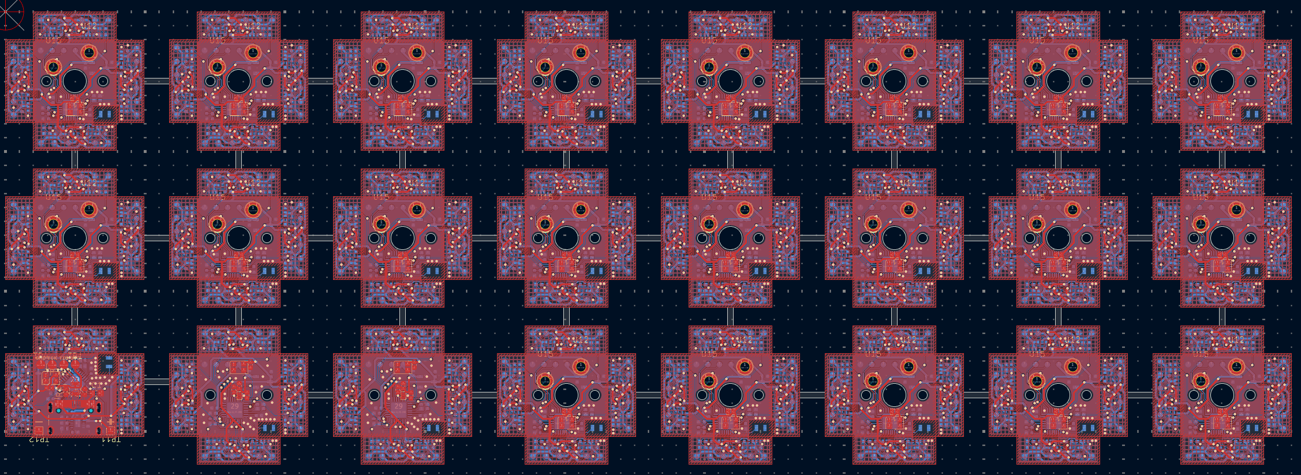
[picture p64: assets/journal/v2/panels/8x3-panel.png]


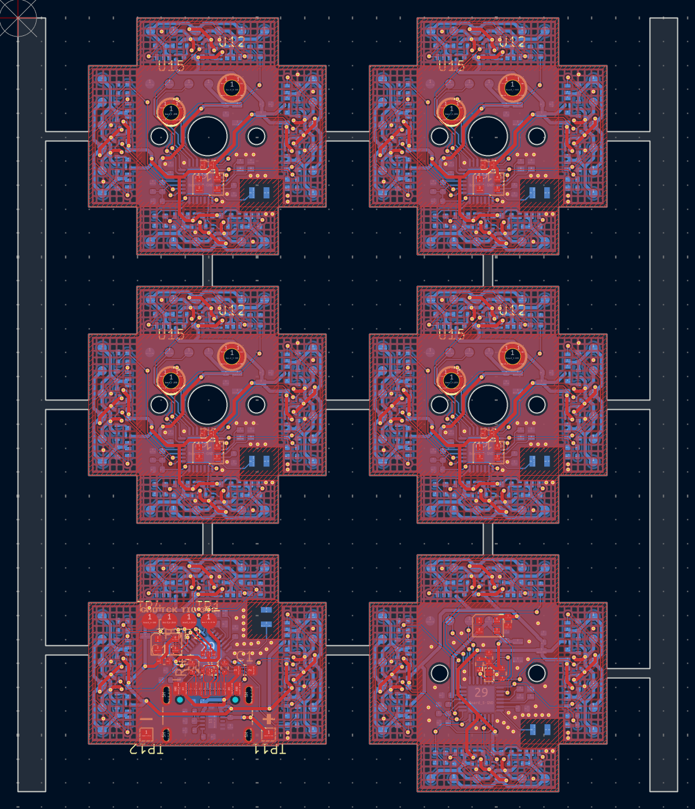
[picture p65: assets/journal/v2/panels/2x3-test-panel.png]


i also rounded all the edges on the cases (1.5mm on the corners and 0.5mm on the top) since they looked way too sharp, and made a new blender render of the keybit in its case with a keycap. i copied the lighting from ledify so its only lights and no hdri, which gives it way more contrast

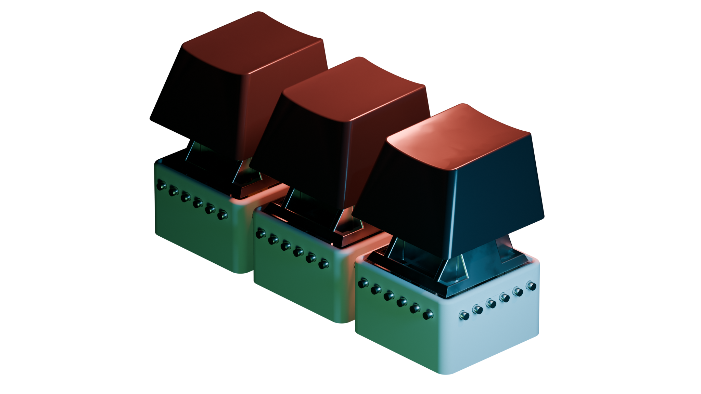
[picture p66: blender/keybit_v2_hero.png]


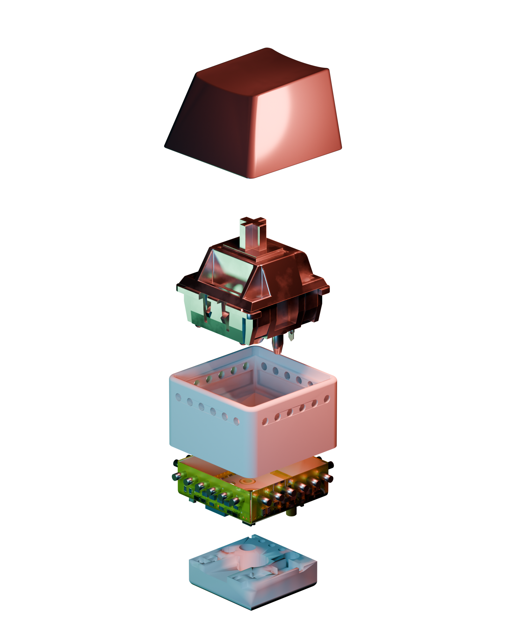
[picture p67: assets/journal/v2/keybit_v2_cutaway.png]


now for the money part. this is everything from v1 to now (jlc standard pcba, prices from my jlc account, no shipping unless it says so)

| | what | price | per key |
|---|---|---|---|
| v1 real order | 5 rigid keybits + 2 keywords | $69.67 + $203.60 + $158.17 shipping | ~$14 per keybit, ~$102 per keyword |
| v1 full keyboard estimate | 110 keybits + 2 keywords | ~$902 + shipping | ~$6 per keybit (the 8 pogo pins were $3.80 of that lol), ~$122 per keyword |
| v2 singles at pcbway | 200 flex keybits, parts + assembly | $1,652.91 (and that didnt even have the pcb) | ~$8.26 |
| v2 singles at jlc | 100 flex keybits | $645 | $6.45 |
| v2 panelized at jlc | 100 flex keybits as 5 panels of 4x5 | $441 | $4.41 |
| ^ with shipping + duties | ups ddp, ~35% duties | $648 | ~$6.48 |
| v2 full order | 5x 8x3 panel (105 plain, 10 hall, 5 keyword) + 25 spacers | $638.84 + $35.44 = $674.28 | |
| v2 test order | 5x 2x3 panel (20 plain, 5 hall, 5 keyword) | $447.44 | |

**v1 -> v2**

v1 was a rigid keybit with a ch32v003 and 8 pogo pins on the sides, and the keyword was 2 stacked boards with an stm32wb55. the pogo pins were the most expensive thing on every key and the stm32wb55 by itself was like $12-13 per keyword. v2 moves BOTH boards to the ch592f (~$1 and it has ble and usb so the keyword is just 1 board now) and the keybit is a cross shaped flex that folds up into the case, and the magnets ARE the contacts so no more pogos between keys. the price per key stayed about the same but now every key has its own ble mcu, hot swap sockets and an rgb led which v1 didnt have so its kinda a win.

i also tried swapping all 24 fets for cheaper ones (PNM3FD20V1E and CJBA3139K) which saves ~$1.45 a key, but the fet footprints went back to sot-883 since the dfn1006 ones werent needed. pcbway was wayyy more than jlc (assembly was $4.79 a board and the flex pcb wasnt even in the quote) so i stayed with jlc.

**v2 -> v2 panelized**

when i quoted 100 single flex keybits at jlc it was $645 and $248 of that was JUST the flex fixture fee bc jlc adds rails to every tiny board and charges a fixture for each one. so i panelized them as 4x5 and it went down to $441 for the exact same boards (32% less!!), the fixture went from $248 to $99.

jlc flex panels have a bunch of annoying rules tho: no v-cuts or mouse bites (only laser cut tabs), one side has to be exactly 79, 119 or 240mm with the rails, and the website only takes it if you dont add rails yourself so they can add their own 5mm ones. i put the tabs on the tips of the flaps and never on a fold so nothing cracks.

then i tried a bunch of mixed panels so the hall keybits and the keyword could all come in one order

| panel | 5 panels |
|---|---|
| 4x5 plain keybit | $441.14 |
| hall + keyword + spacers (5 designs) | $777 |
| 3 designs | $664 |
| hall + keyword only | $605 |
| mixed 8x3 with a spacer on every panel | $685.34 |
| **8x3 no spacers + separate spacer panel** | **$674.28** |
| 1x3 test | $413.45 |
| **2x3 test** | **$447.44** |

every extra design on a panel is +$51.50 on assembly and +$4.96 on the pcb, and the bare spacers count as a design too, so its cheaper to order them as their own bare flex panel. also like $312 of every quote is fixed (setup, stencil, fixture, feeders) which is why the 2x3 is only $34 more than the 1x3 for twice the boards.

here are all the other panels i made before i got to the final ones

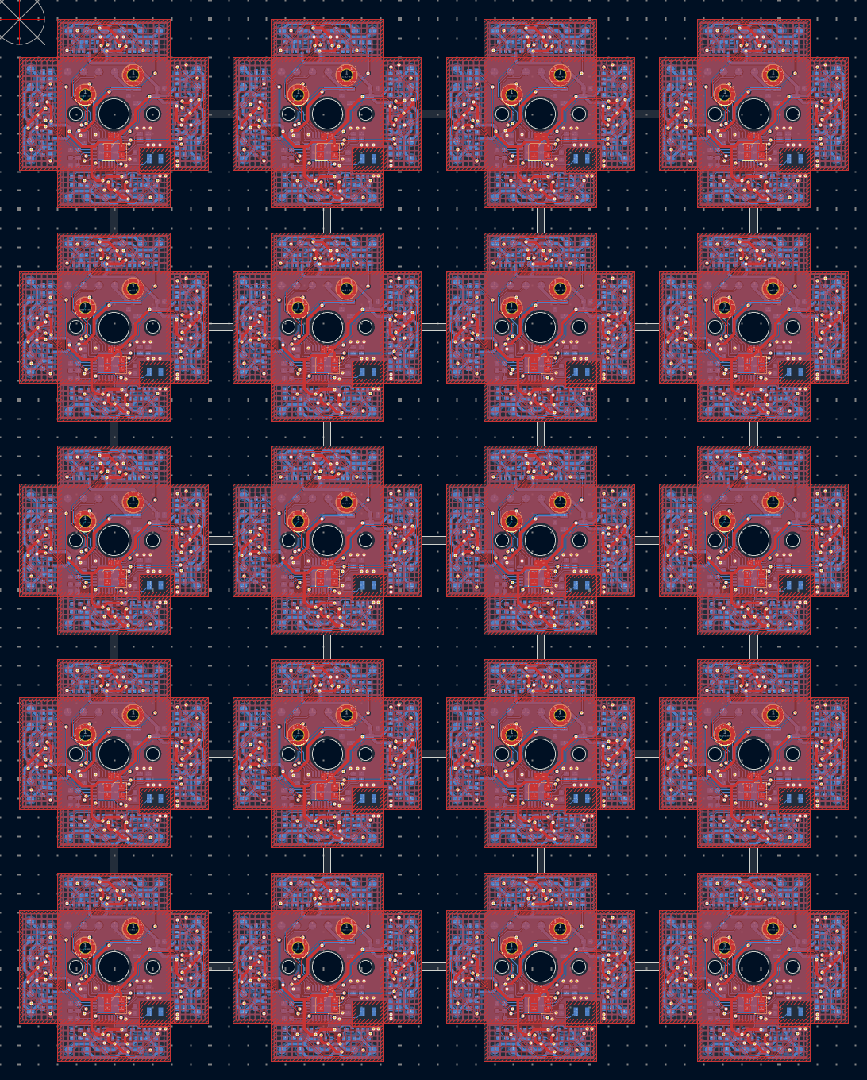
[picture p68: assets/journal/v2/panels/keybit-panel.png]


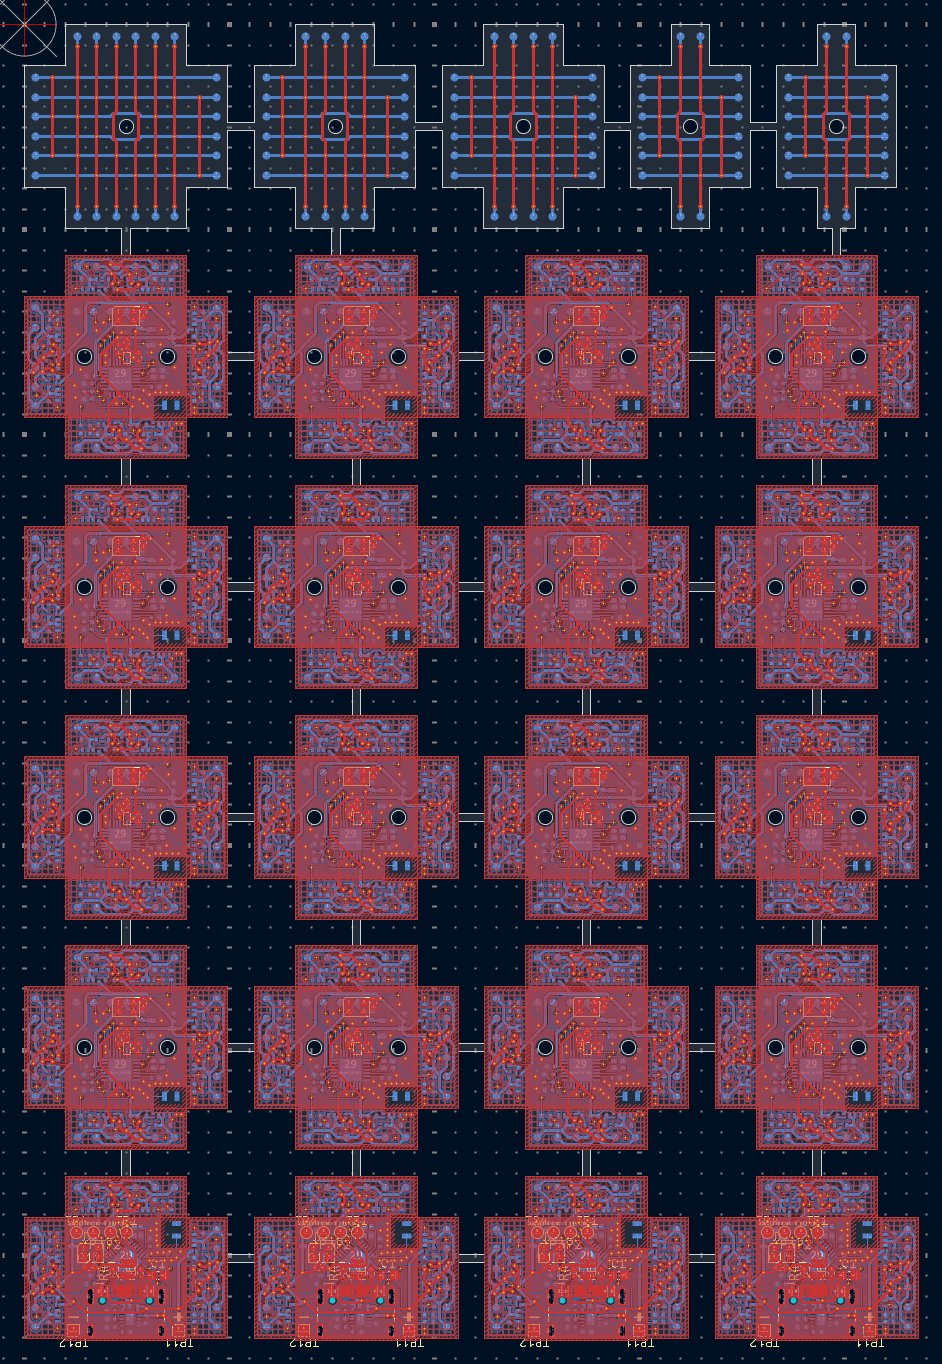
[picture p69: assets/journal/v2/panels/hall-keyword-panel.png]


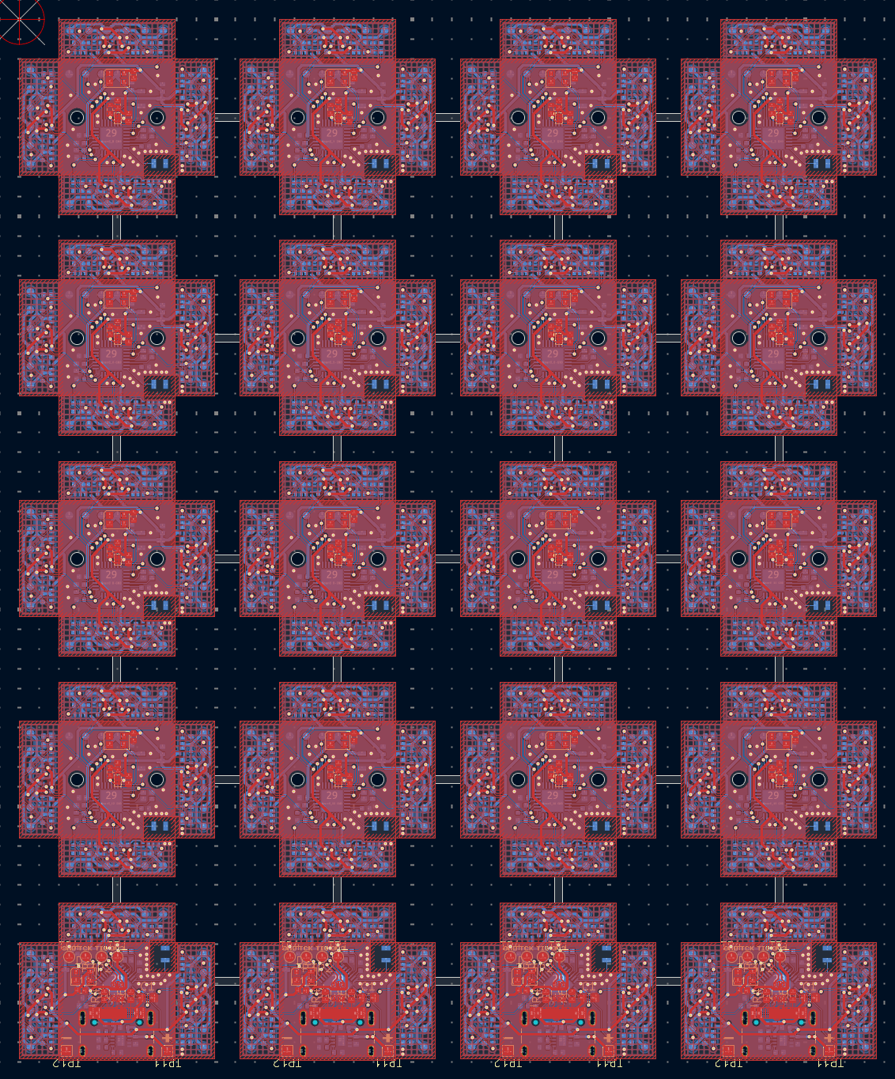
[picture p70: assets/journal/v2/panels/hall-keyword-nospacer-panel.png]


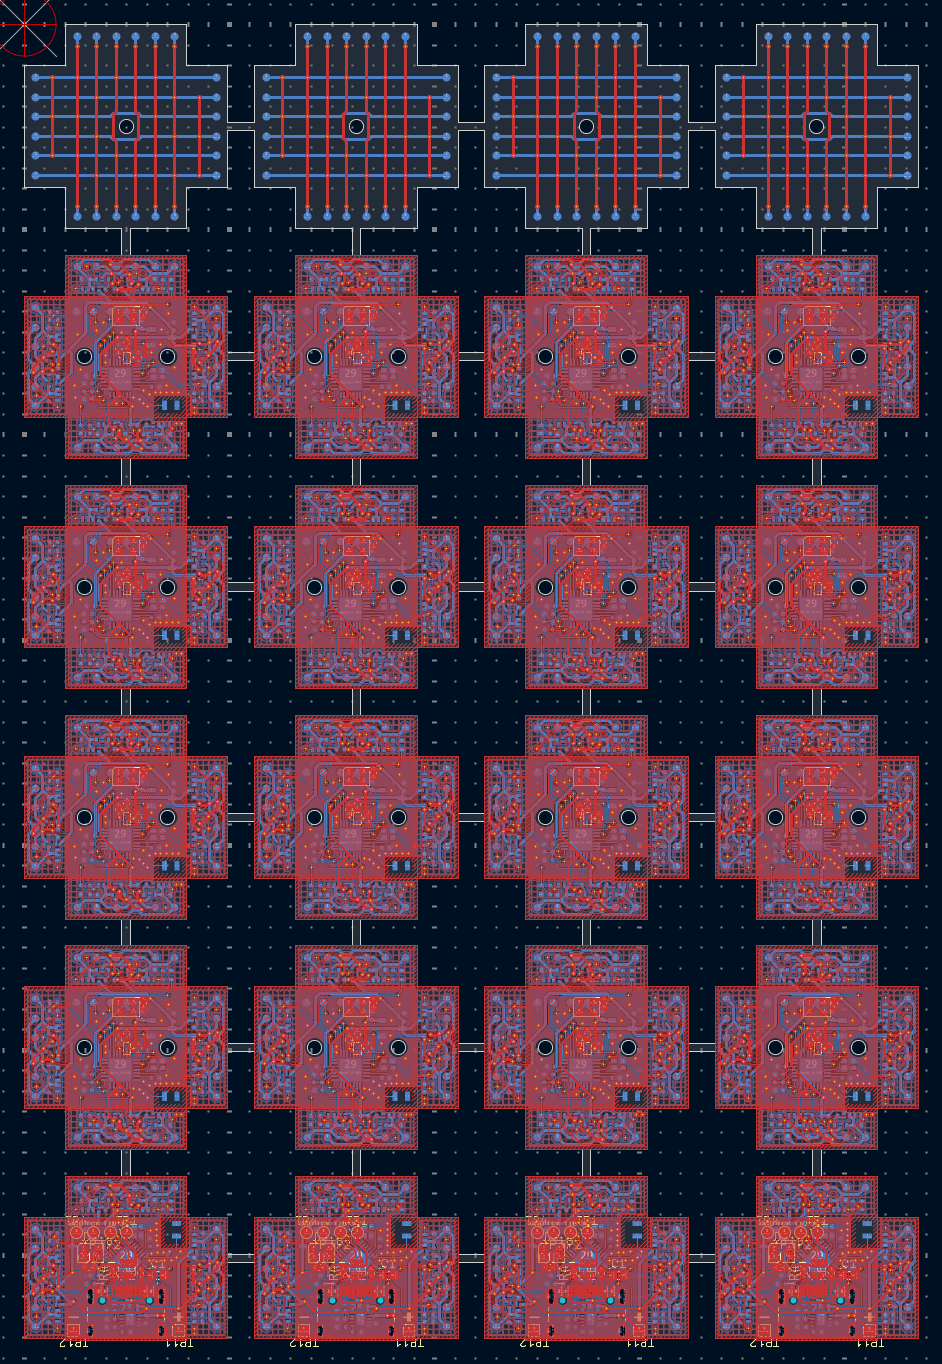
[picture p71: assets/journal/v2/panels/hall-keyword-1u-panel.png]


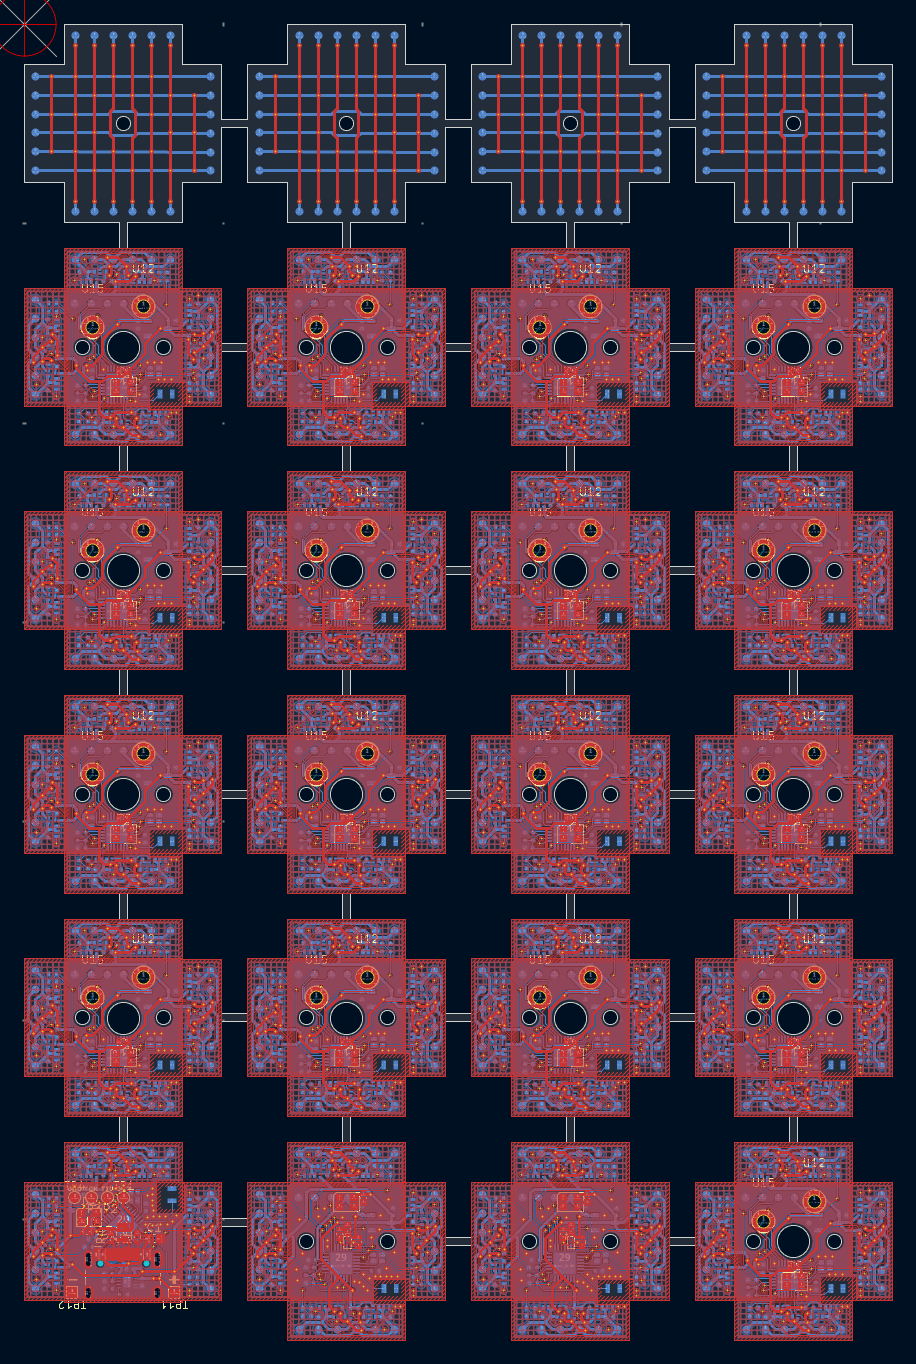
[picture p72: assets/journal/v2/panels/mixed-panel.png]


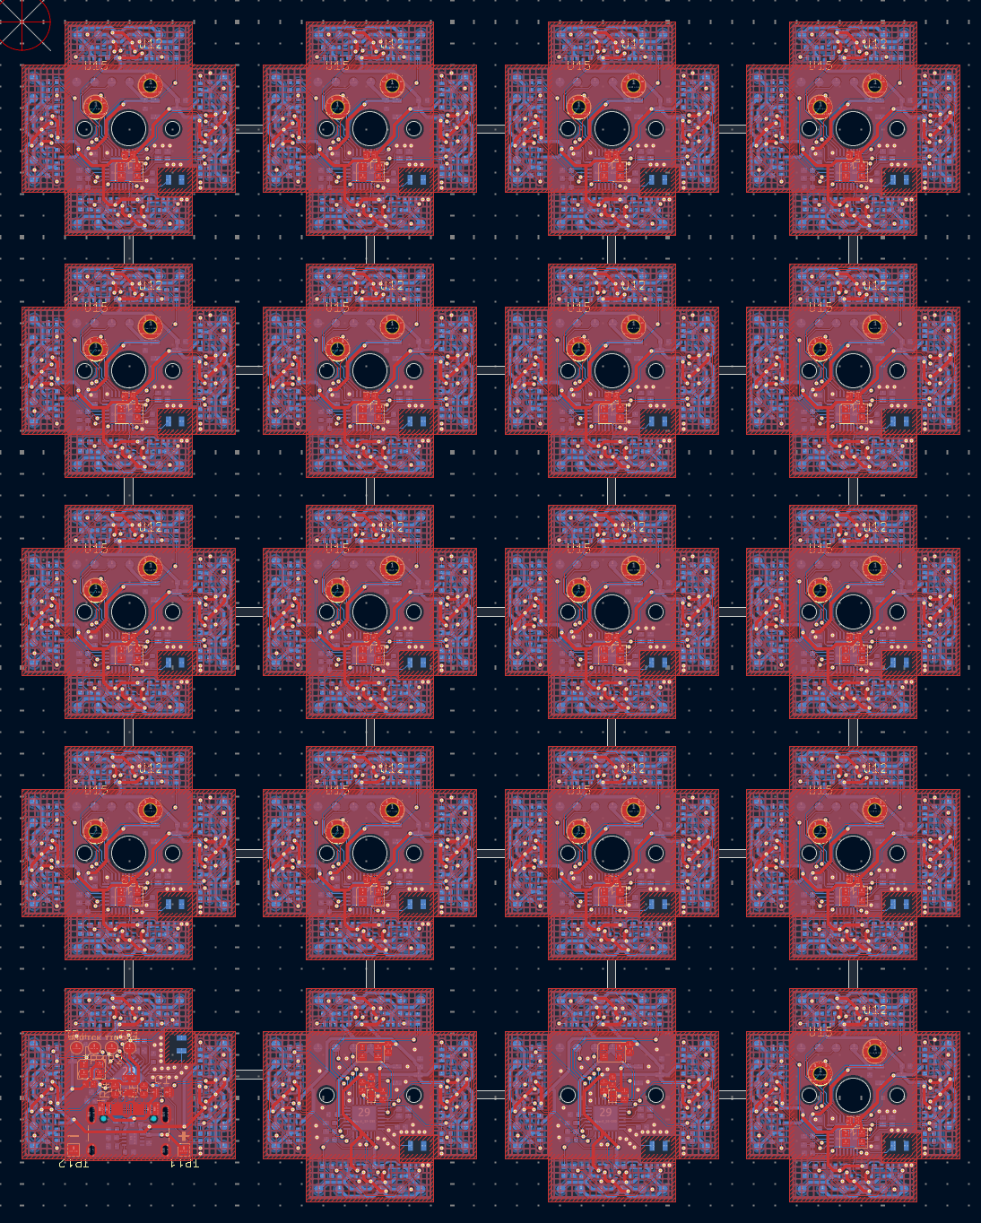
[picture p73: assets/journal/v2/panels/mixed-nospacer-panel.png]


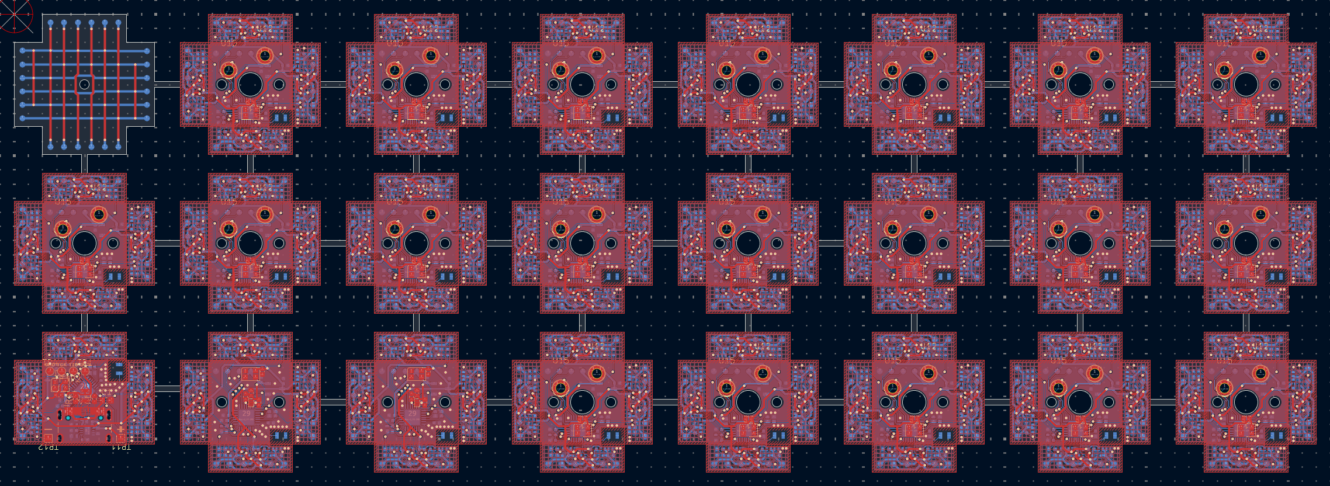
[picture p74: assets/journal/v2/panels/mixed-8x3-panel.png]


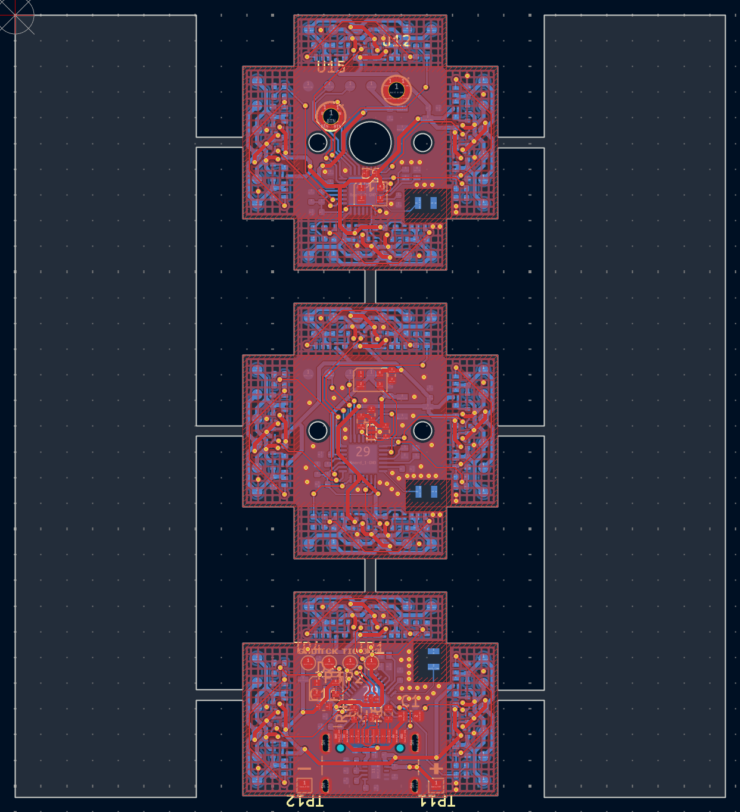
[picture p75: assets/journal/v2/panels/test-1x3-panel.png]


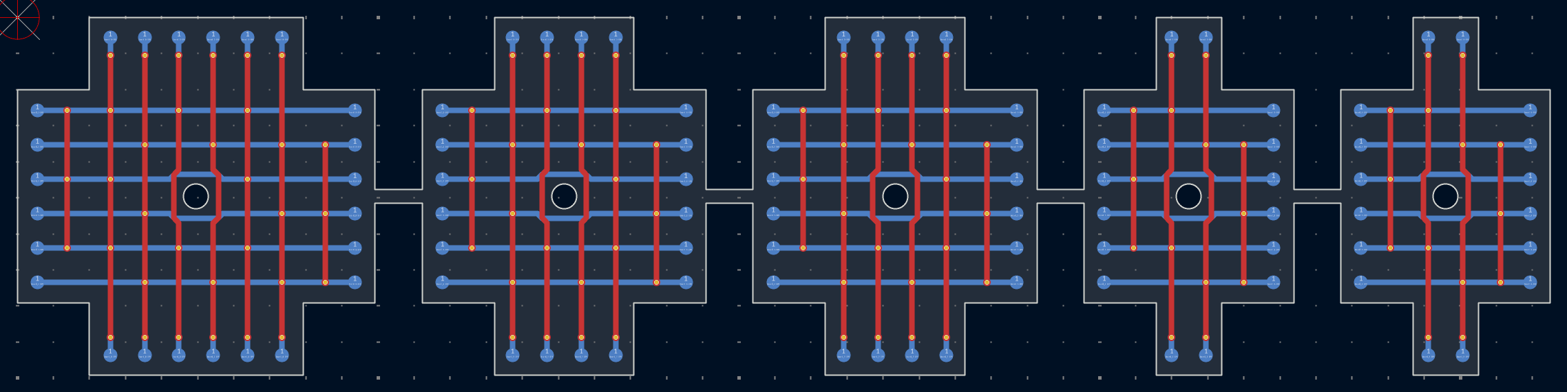
[picture p76: assets/journal/v2/panels/spacers-panel.png]


jlc doesnt stock the mill-max sockets or the bq25185 so im soldering those myself. jlc wanted $0.875 per socket so im just getting 220 from digikey at $0.443 ($97.46). with the sockets, magnets and a printed case a plain keybit is ~$6.25 at 100 (~$7.80 with shipping and duties) and ~$3.65 if i ever made 1000.

i also quoted a rigid fr4 keybit with plated slots on the edges for the magnets to see if going back to rigid would be cheaper. 100 was $338 vs $430 for flex and 1000 was $1,578 vs $1,719, so like 20% less at 100 and 8% at 1000. not worth redesigning everything for that so flex it is

for the side contacts im using 1x2mm n52 magnets (1mm wide, 2mm long) glued onto the magnet pads with silver epoxy. i simulated how hard each size pulls and a 1x2 pair is only ~62gf touching, which is fine for conducting but way too weak to actually hold the keys together. 1.5x2 is about double that and 2x2 is ~219gf, but the pads are 1mm on a 2.38mm grid (19.05mm key pitch) so only the 1mm ones fit rn.

i also had both flex boards checked for what would break first. wiring is fine on both but:

1. voltage drop down a chain, each key to key hop is ~2 ohms (mostly the 4 fets) so a 15 key row loses ~1.3V and turning the leds on makes it collapse
2. until a key turns on its side the power comes through a diode so it loses ~0.7V per key
3. the magnets are live with no current limit so something metal across them shorts everything
4. a bunch of parts are on or past the edge of the flap stiffeners and will crack when the flaps fold
5. all 8 inside corners of the cross are sharp and thats exactly where flex tears

so next rev needs rounded corners, parts pulled back onto the stiffeners and a current limit on the keyword

# 11/11/2026 - keyword v2, cases and spacers

i restarted the keyword from scratch as a copy of the hall keybit, so its the same cross shaped flex with the ch592f just with usb-c and a battery charger instead of the switch. i also cut off the south flap since there was nothing on it so the usb-c sits on a flat south edge now.

then i placed and routed the whole thing. the charger, ldo and battery pads went on the back next to the usb-c and i routed the flaps the same way as the hall keybit since they are in the exact same spots. i also added the 5.1k pulldowns on cc1 and cc2 (otherwise a usb-c charger wont even give it power) and put the led on the power path so it actually lights up on battery. i also had claude try routing a copy overnight but mine came out better so i deleted that one lol

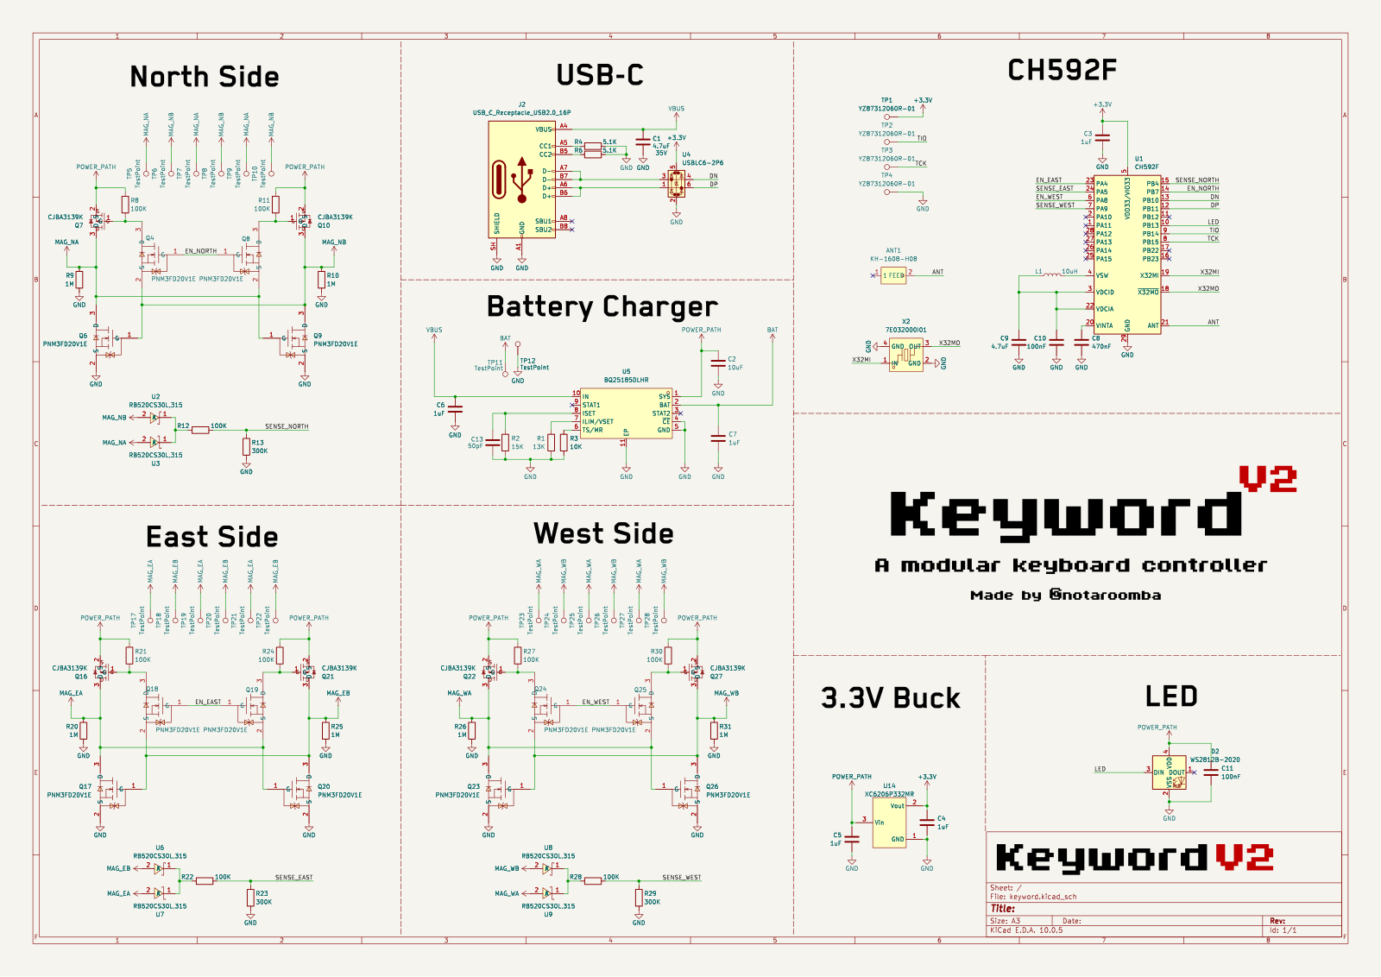
[picture p77: assets/journal/v2/keyword_v2_schematic.png]


for charging i went with the bq25185, its standalone (no i2c setup), can charge as low as 5mA so it works with a tiny cell, and gives 4.5V on sys when usb is plugged in. its set to 4.2V / 1.1A with ilim/vset = 13k, iset 15k with a 50pF cap, ts 10k and ce to gnd. the old bq25895 couldnt go below 64mA which would have cooked a small cell.

for usb esd i went with the usblc6 in sot-666 (1.6x1.6mm) instead of the big sot-23-6 one since theres no room.

the debug pads tp1-tp4 are going to be smd pogo pins (YZ87312060R-01, C5157406) on top of the keyword in the same spot as the pads on the bottom of the keybits so i can flash them by just pressing them on.

i also made spacer flexes (1u, 0.75u and 0.5u) that pass power through between 2 keybits so you can leave a gap in a row

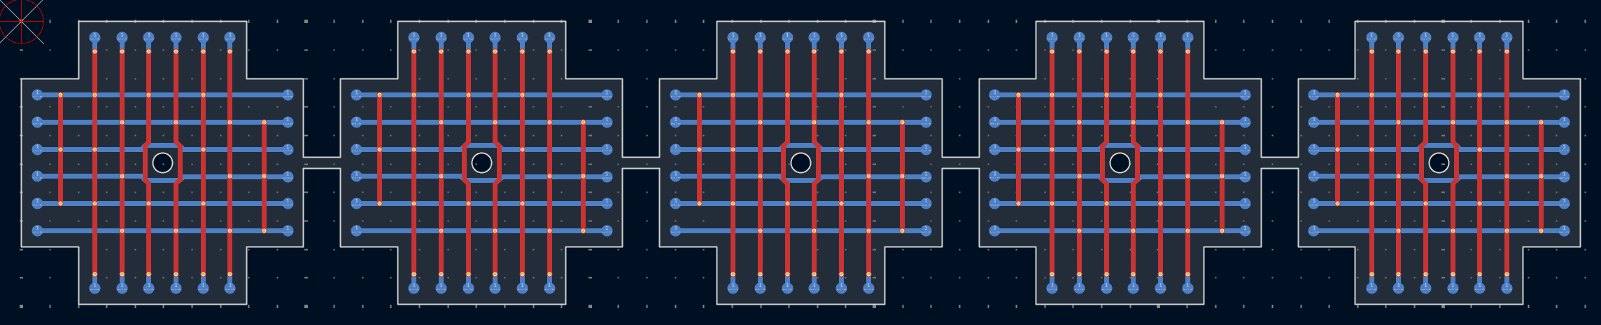
[picture p78: assets/journal/v2/panels/spacer-panel.png]


the new cases dont have the big 4x3 holder magnets anymore since they block staggering, just the small contact magnets in the walls. all the cases (plain keybit, hall, joystick and encoder) are 10.4mm tall now, all 17.55mm wide so theres a 1.5mm gap between keys

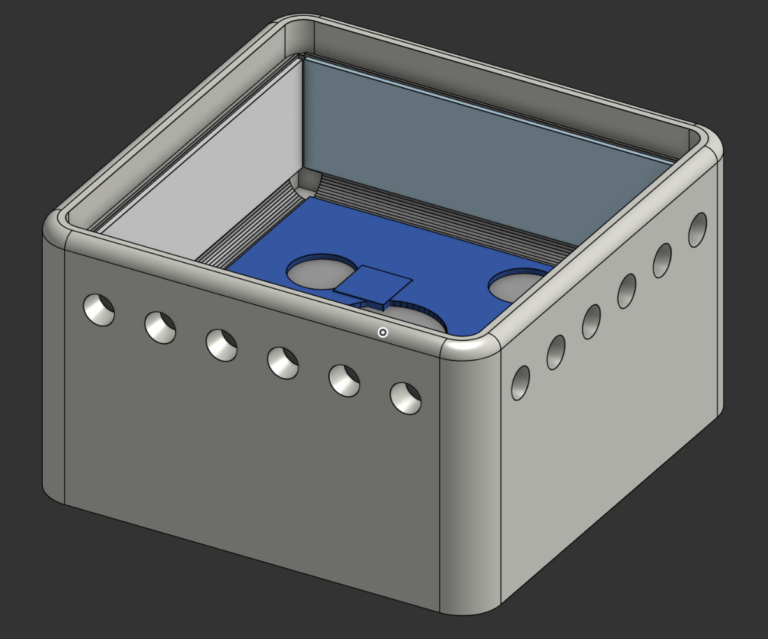
[picture p79: assets/journal/v2/keybit_v2_case_rounded.png]


and the joystick and encoder versions that use the same hall keybit (the encoder knob is cnc'd at jlccnc)

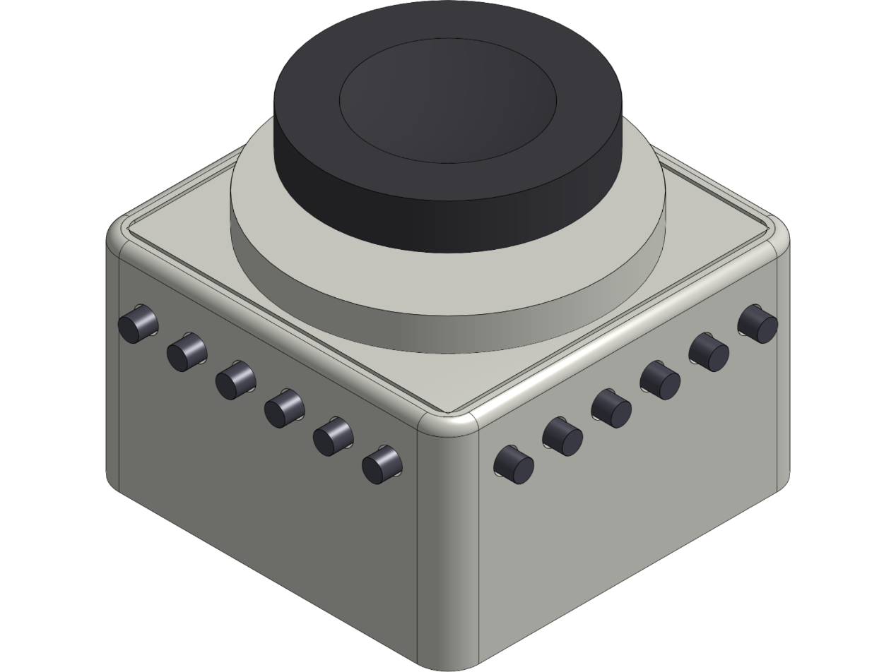
[picture p80: assets/journal/v2/joystick_case.png]


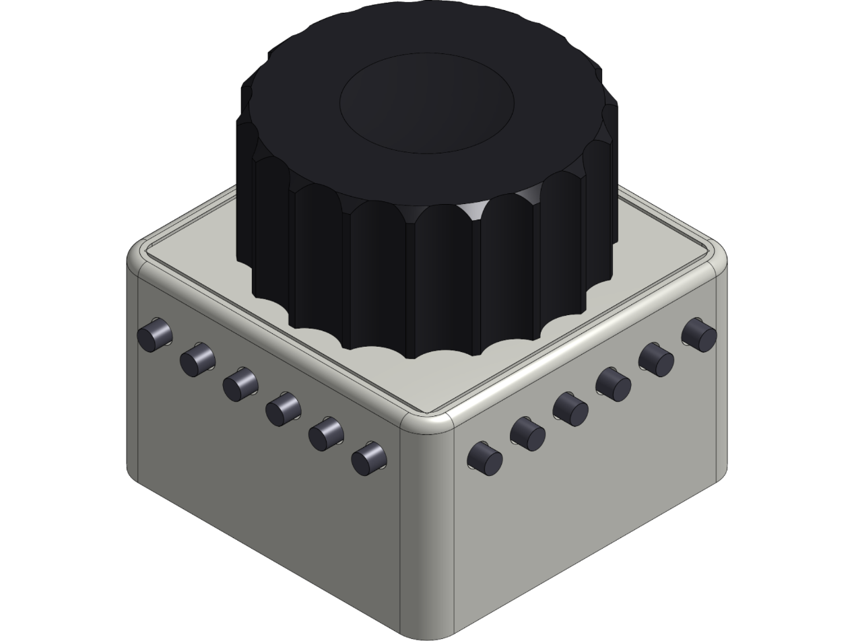
[picture p81: assets/journal/v2/encoder_case.png]


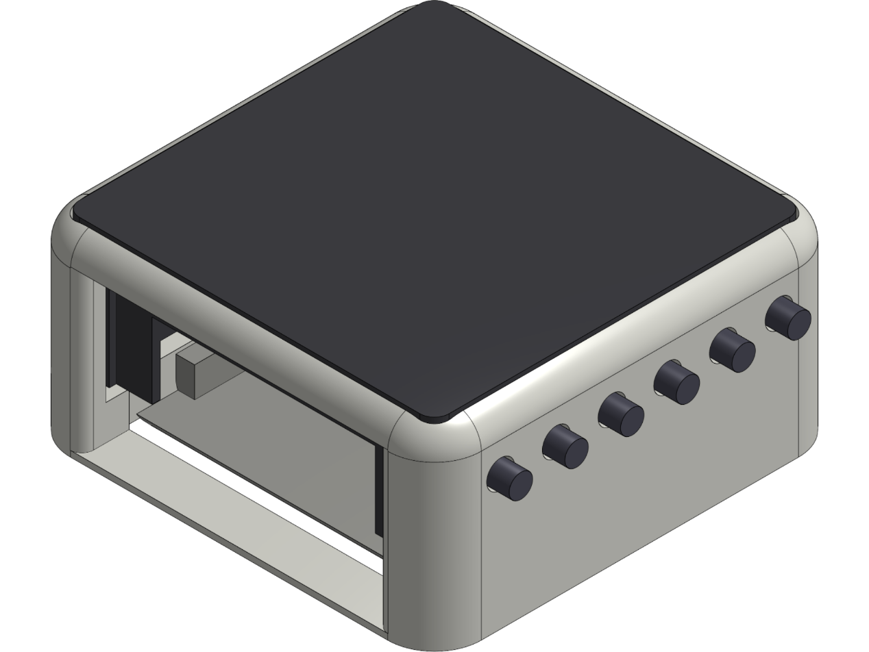
[picture p82: assets/journal/v2/keyword_v2_case.png]


i also messed around with modules that chain together with the hall sensor like a slider that goes across multiple keys, a scroll wheel and a toggle switch

# 11/09/2026 - tmag3001 and pcbway vs jlc

i dropped the rotary encoder keybit bc every small smd encoder still needs locating holes, and moved the hall keybit from the hal9303 to the tmag3001 (C31115089) which is a tiny 3 axis i2c hall sensor. since it reads all 3 axes one hall board can be a key, a knob or a joystick depending on the case which is sick. then i rerouted the middle of the hall keybit around it, its a 0.5mm wcsp so it sits right under the switch with its cap and the 4.7k i2c pull ups next to it.

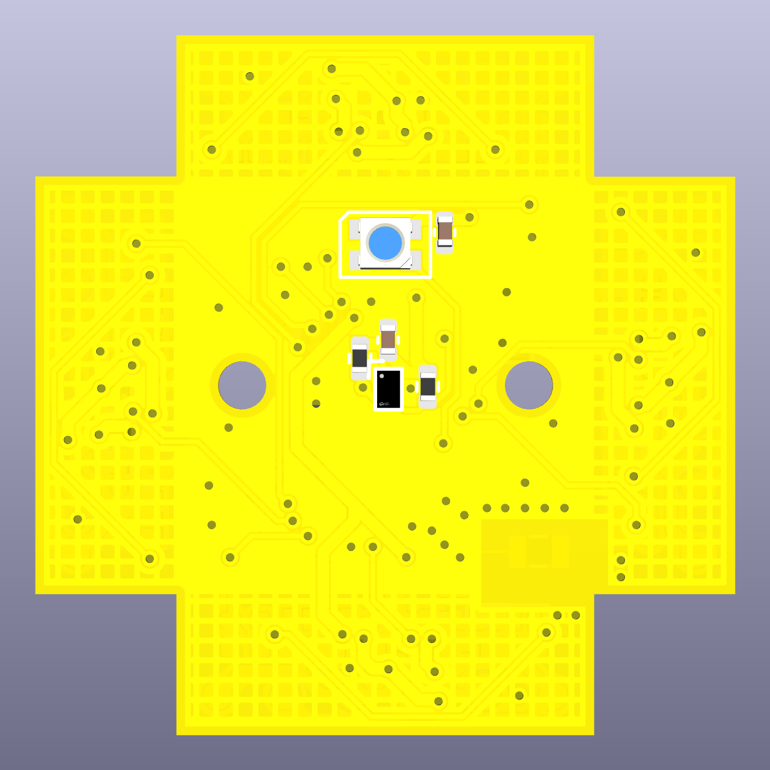
[picture p83: assets/journal/v2/keybit_hall_render_top.png]


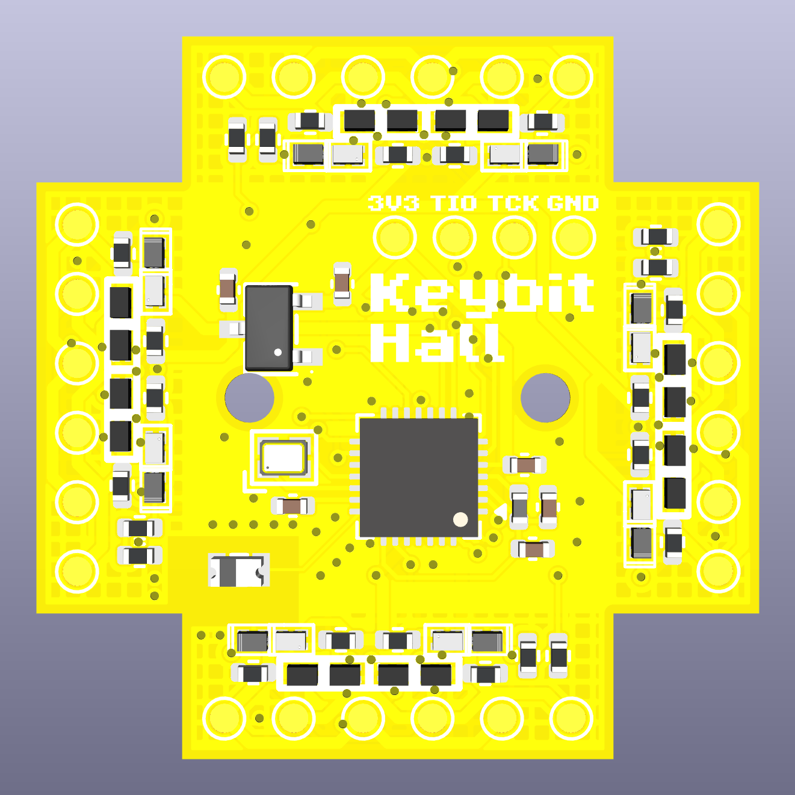
[picture p84: assets/journal/v2/keybit_hall_render_bottom.png]


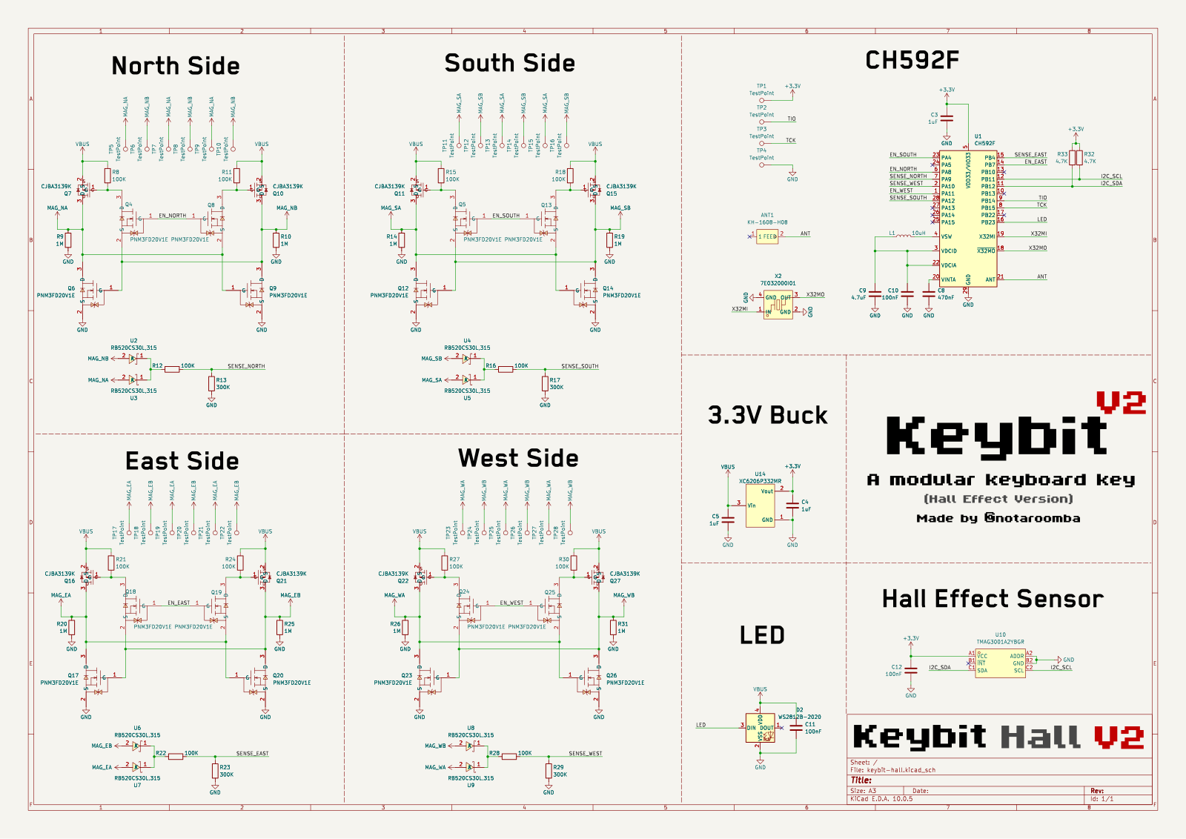
[picture p85: assets/journal/v2/keybit_hall_schematic.png]


then i went through both boards before ordering. both are on the ch592f wqfn-28 now and i2c is bit banged on pb12 (sda) and pb11 (scl). the plain keybit got the same silkscreen and stiffener changes

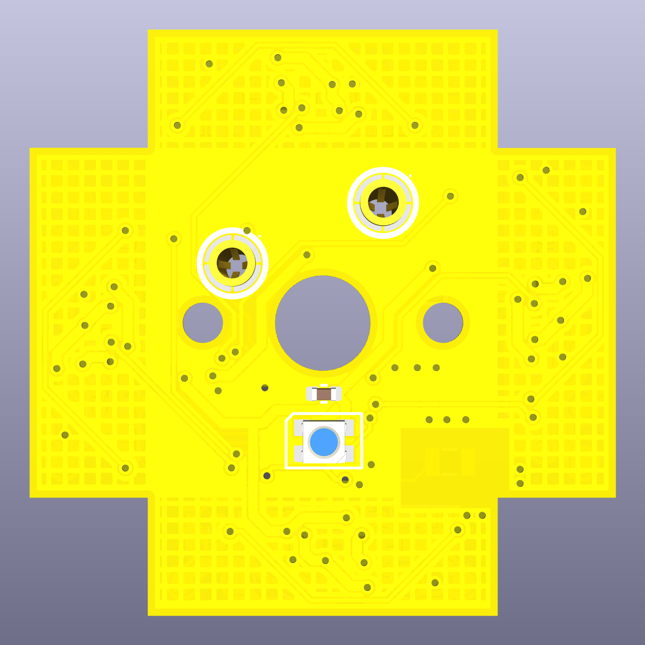
[picture p86: assets/journal/v2/keybit_v2_render_top.png]


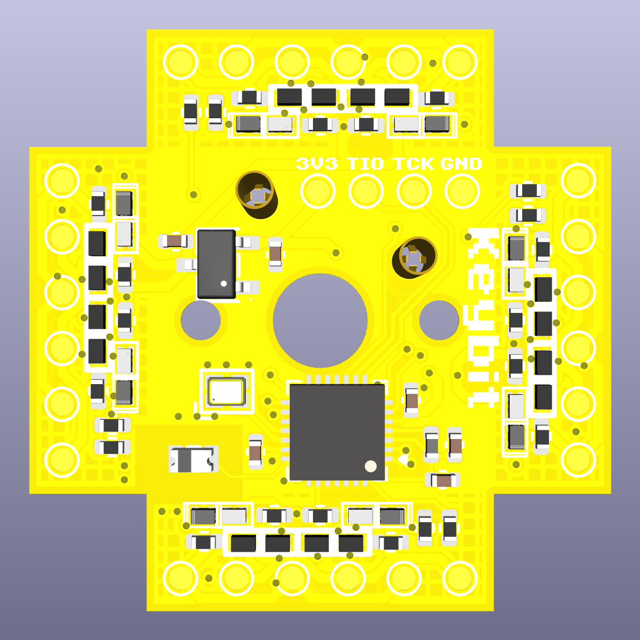
[picture p87: assets/journal/v2/keybit_v2_render_bottom.png]


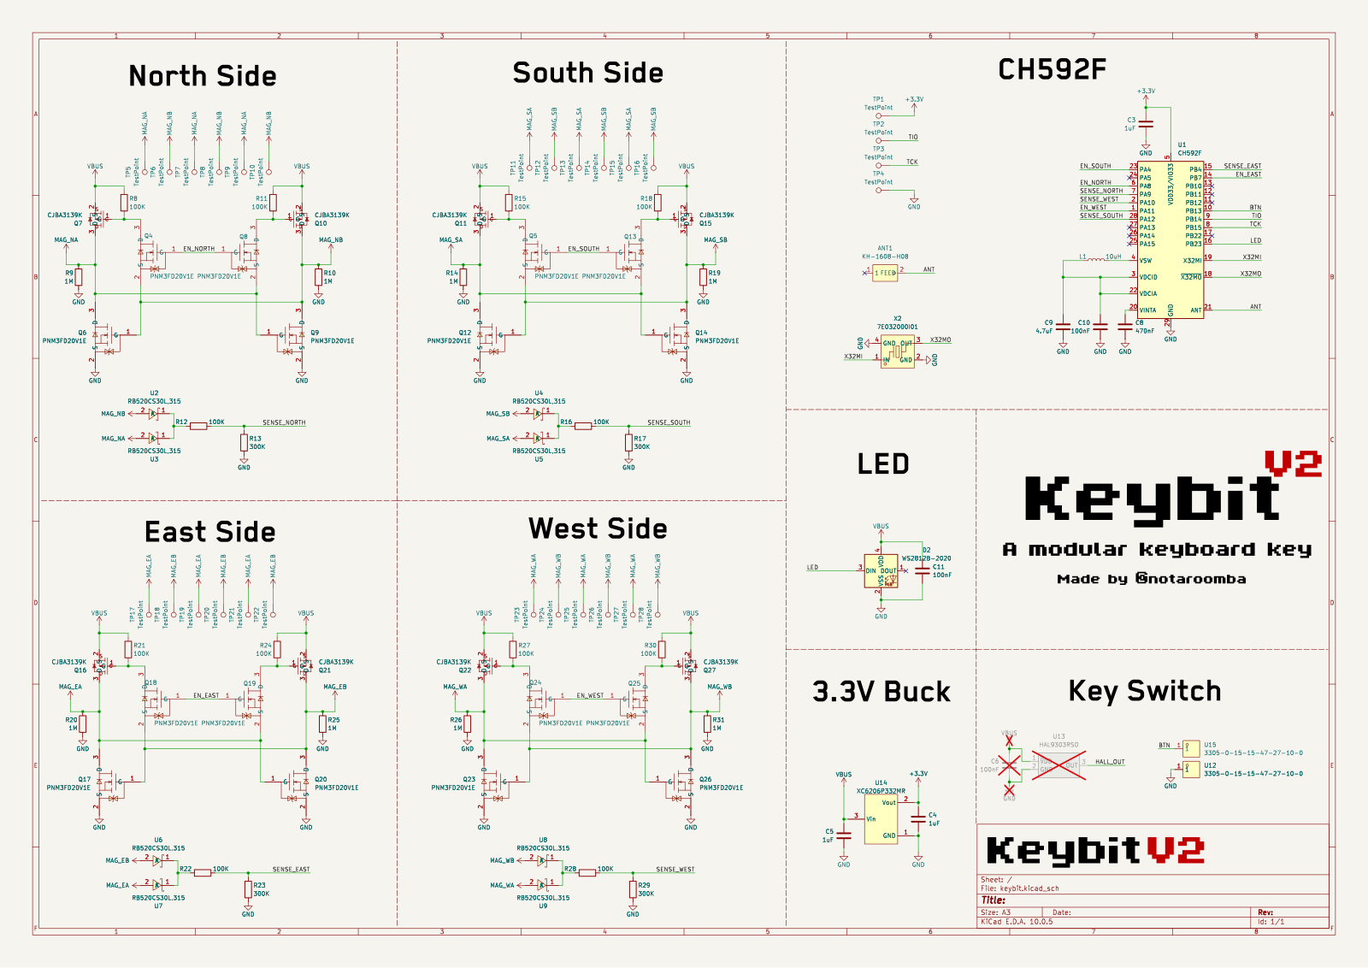
[picture p88: assets/journal/v2/keybit_v2_schematic.png]


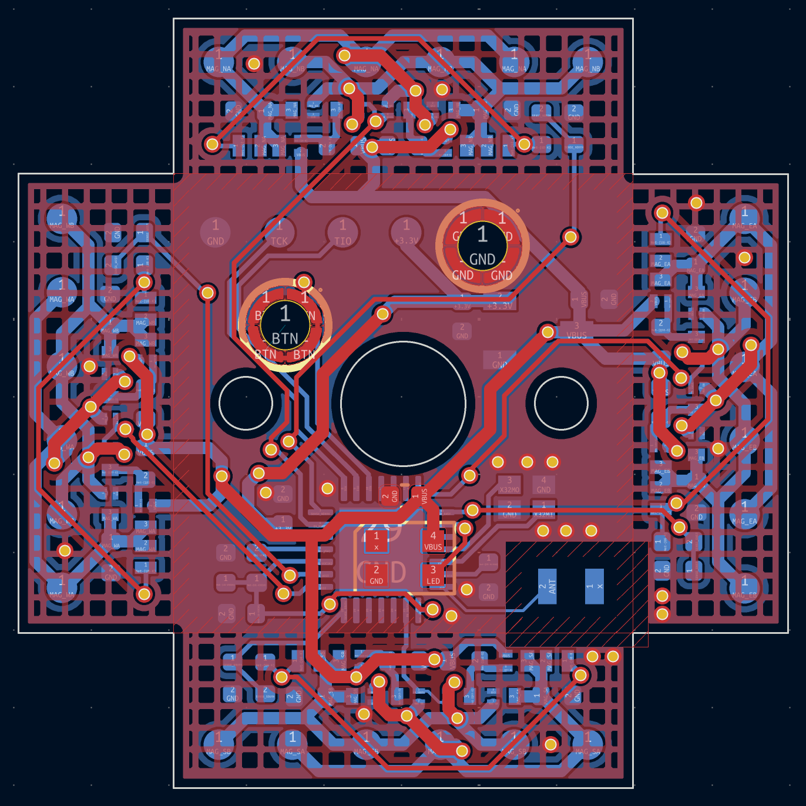
[picture p89: assets/journal/v2/keybit_v2_layout.png]


# 11/05/2026 - keybit v2 flex

ok so first i made the keybit cheaper by swapping the fets, the SSM3K56ACT n-fets for PNM3FD20V1E and the RV2C014BCT2CL p-fets for CJBA3139K, which saves like $1.45 per key bc there are 24 of them on every keybit

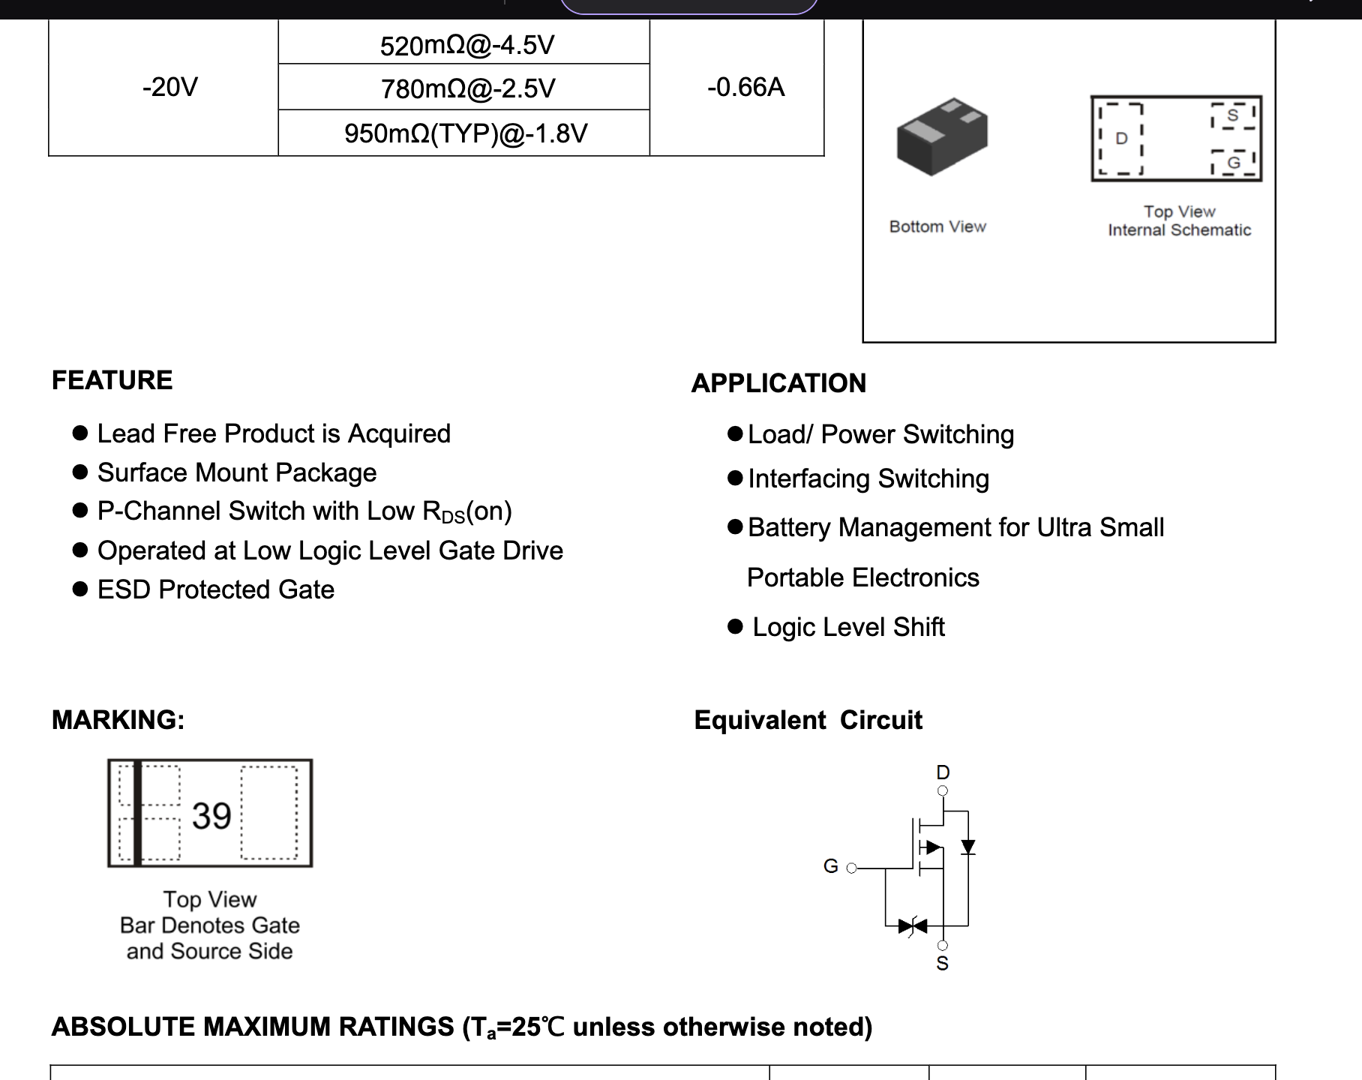
[picture p90: assets/journal/v2/cjba3139k_pfet_datasheet.png]


then i went through the whole board to see if it was ready to order and it wasnt lol. drc found an actual short where the SENSE_NORTH trace went right over a gnd via, and then a bunch of the same mistakes as v1 (the CH592F, the led, the inductor and every resistor and cap had no lcsc number so jlc wouldnt have placed them, the test pads were still in the bom, and the 3d models were pointing at absolute paths on my mac AGAIN). so i fixed the short, went through the bom picking the cheapest basic parts (like C25741 for the 100K and C26083 for the 1M), excluded TP1-28 from the bom and positions and made all the model paths relative.

the hot swap sockets also had a problem, the footprint had a plated hole with no copper ring around it (same thing as the ledify mic hole) so it has to be a normal plated pad, and jlc has 0 of the Mill-Max 3305 sockets in stock so i have to preorder them (like 20 days). the only socket thats actually in stock is the normal kailh style one but its like 16mm wide so it doesnt fit in the middle of the keybit.

i also added the stiffeners on the User.Drawings layer, fr4 on the top side for the middle and each flap, kept 0.7mm away from every fold so the flex still has room to bend, with cutouts for the sockets, the switch holes, the led and C11. before this that layer wasnt even in the gerbers so jlc would have never seen it lol so i set the fabrication toolkit to export it.

the keyword is gonna put both 5V from usb and 4.2V from the battery on VBUS, so i kept the 300K sense resistors bc 200K would read low on a kinda dead battery, and i left the led on VBUS instead of 3.3V since i want it bright.

i also checked the 3.3V and gnd return paths since i think thats part of what cooked v1 of cyberboard, but here theres no 3.3V pour at all and all the grounds are connected so its fine. the bigger thing is if something metal touches both magnet nets on a side thats turned on it shorts VBUS straight through the fets, so the keyword is gonna need a current limit on its output.

for the antenna i read the KH-1608-H08 datasheet and its a monopole, so one end is the feed and the other end is just left floating, which is what i had. i moved it in from the folds and moved the gnd vias out of the keepout. there wasnt any room for matching pads so its connected straight to the CH592 like its datasheet says, and the antenna sits on the stiffener now so the bend doesnt crack it

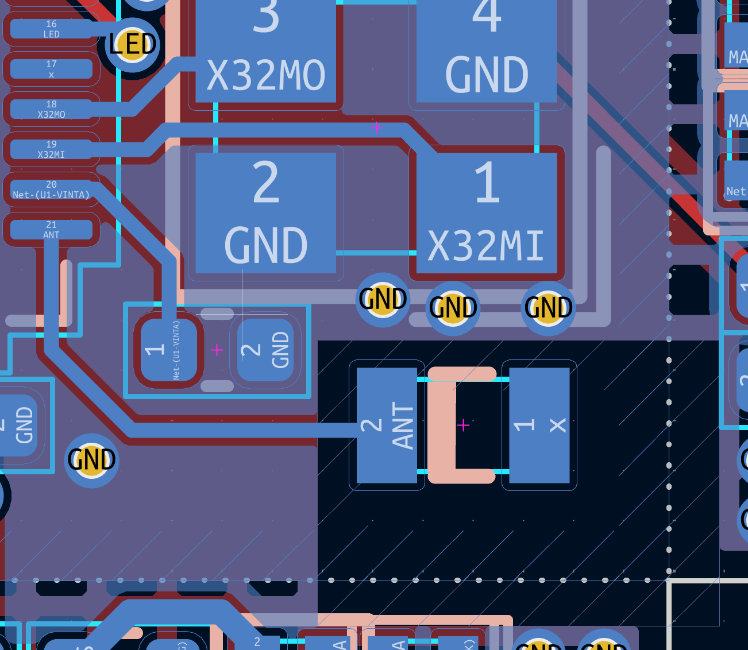
[picture p91: assets/journal/v2/keybit_antenna_moved_in.png]


then i swapped the 3225 32MHz crystal for a 1.6x1.2mm one (C781732) and rerouted around it to save space

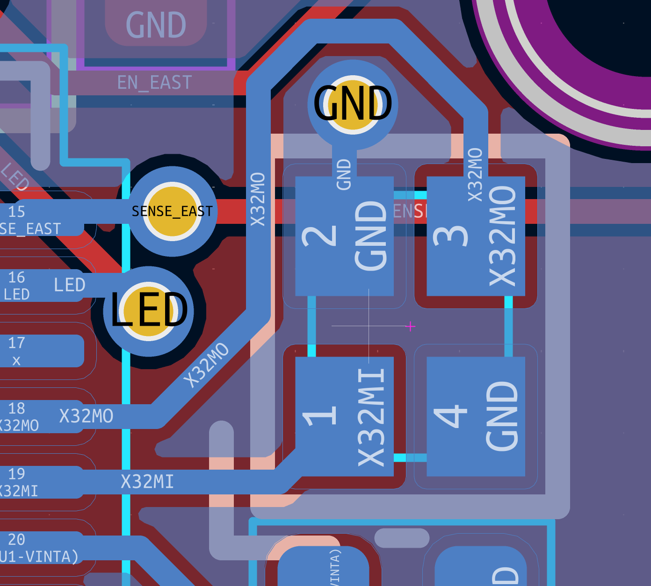
[picture p92: assets/journal/keybit_1612_crystal_routing.png]


which let me redo the antenna along the south edge with a bigger keepout and a fence of gnd vias between it and the crystal

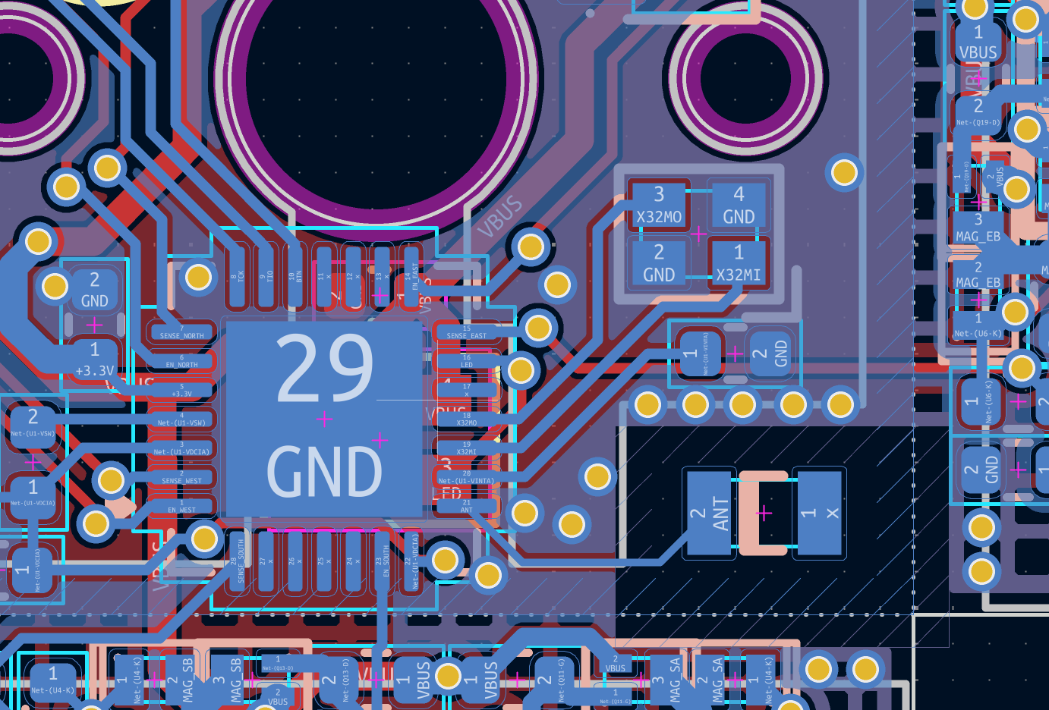
[picture p93: assets/journal/keybit_new_antenna_layout.png]


then i started the hall effect keybit in [`hardware/keybit-hall`](hardware/keybit-hall). it uses a HAL9303R linear hall sensor (C42387471) right under the switch, and since its analog it needs an adc pin, so i put it on PA8 (adc channel 12) and moved EN_NORTH to PB13 and EN_SOUTH to PA13 to free up the pins

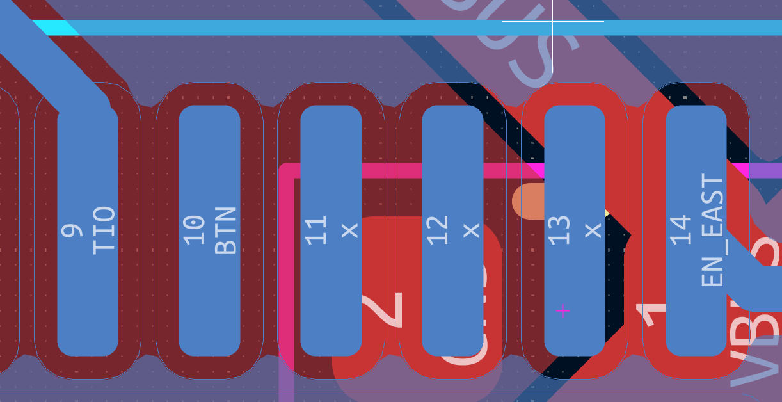
[picture p94: assets/journal/ch592_pins_9-14.png]


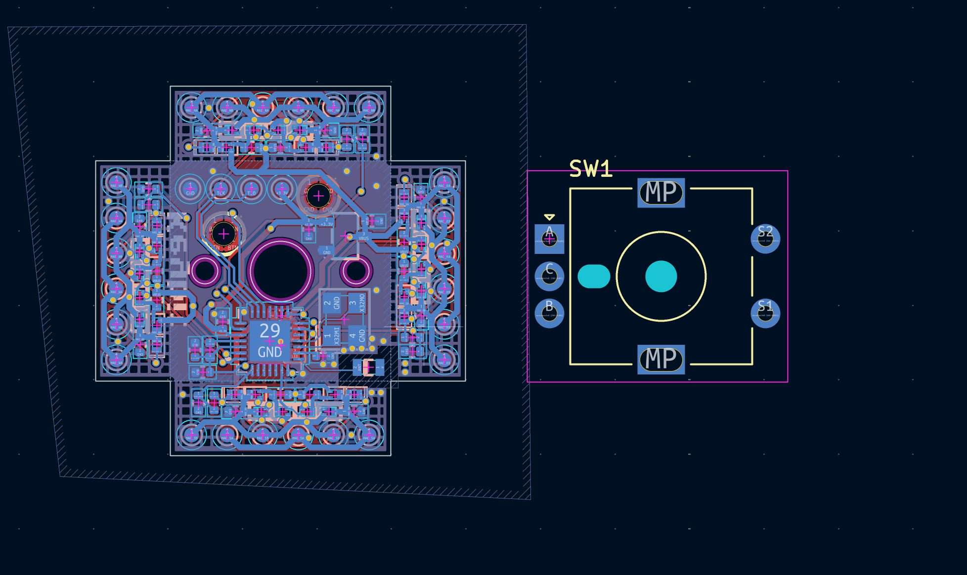
[picture p95: assets/journal/v2/keybit_hall_board.png]


at first i was stupid and laid it out forgetting that the flaps fold down and not up lol, so i had to reroute it so it uses the space better. it also has the new crystal and i redrew its middle stiffener with cutouts for the sensor, its cap, the led and C11, and drc is clean now

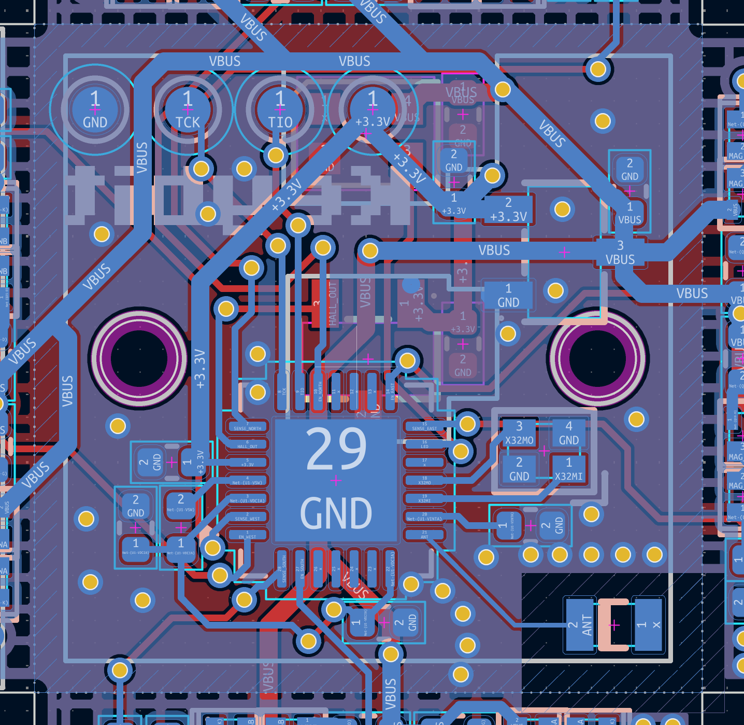
[picture p96: assets/journal/v2/keybit_hall_reroute.png]


i also tried making encoder, oled and fingerprint keybits but i deleted them for now and im just doing the hall one. also 8k polling isnt possible on this bc the STM32WB55 and the CH592 only have full speed usb which tops out at 1kHz, but thats still wayyy more than bluetooth can do.

# 11/04/2026 - routing the keybit flex

ok so today i finished routing the whole new keybit. its a cross shaped flex with the CH592F in the middle and a flap on each side that folds up into the case, and each flap has 6 magnet pads going N S N S N S plus its own little switch circuit. i routed the north flap first, then copied it to the other 3 sides and relinked the copies to their own parts in the schematic (south, east and west) so every side has its own nets.

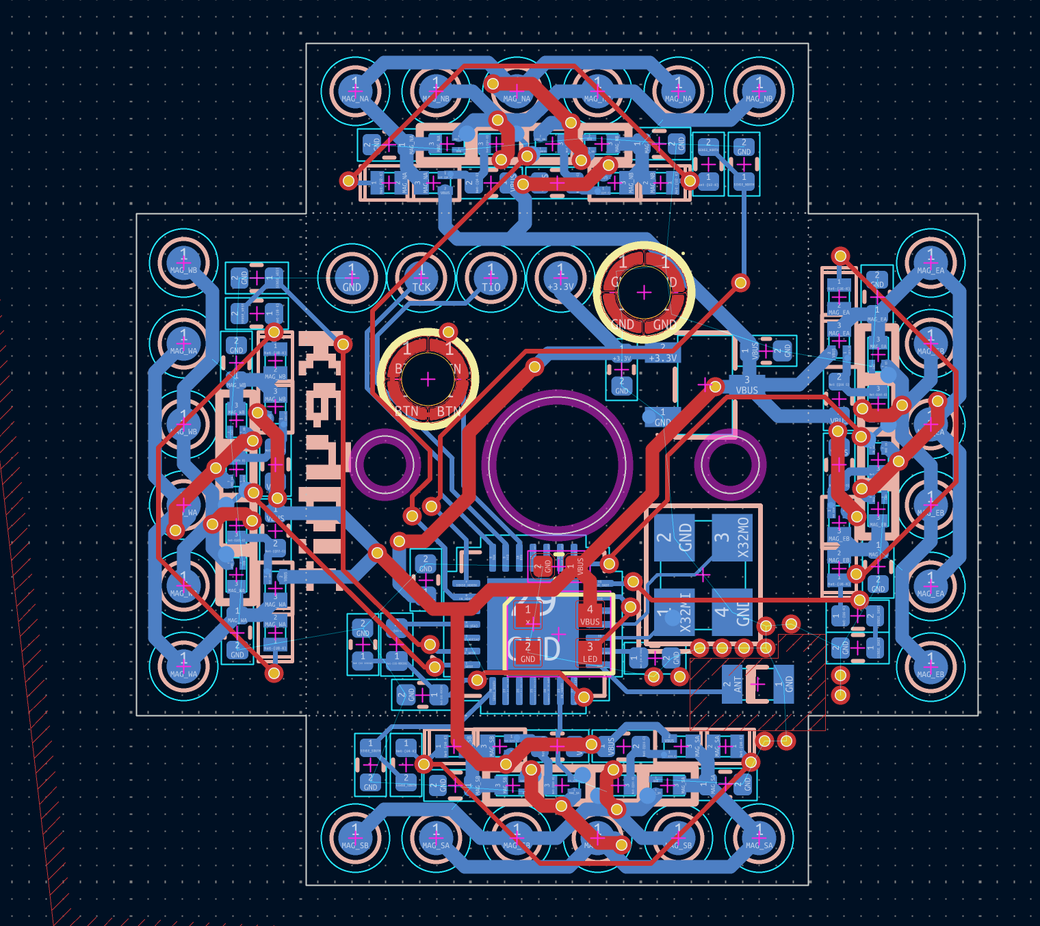
[picture p97: assets/journal/v2/keybit_v2_full_routing.png]


the tricky part is the magnet voltage. since you can put a key next to another one in any rotation or stagger you dont know which magnet net (A or B) is gonna be + and which is gnd. so each side has 2 p-fets (RV2C014BCT2CL) that connect a net to VBUS and 2 n-fets (SSM3K56ACT) that connect a net to gnd, with the gates crossed. whichever net is higher turns on the p-fet to VBUS on its side and the n-fet to gnd on the other side, so it acts like a bridge rectifier but without losing 0.6V per key like diodes would. then 2 more small n-fets on an EN pin let the CH592 decide if a side is allowed to send power out, while a dead key can still get power in through the body diodes. the 1M resistors keep the magnets at 0V when nothing touches them, and 2 RB520 diodes into a 100k/300k divider let each side sense if its getting power, which is how the keyword can figure out who is next to who.

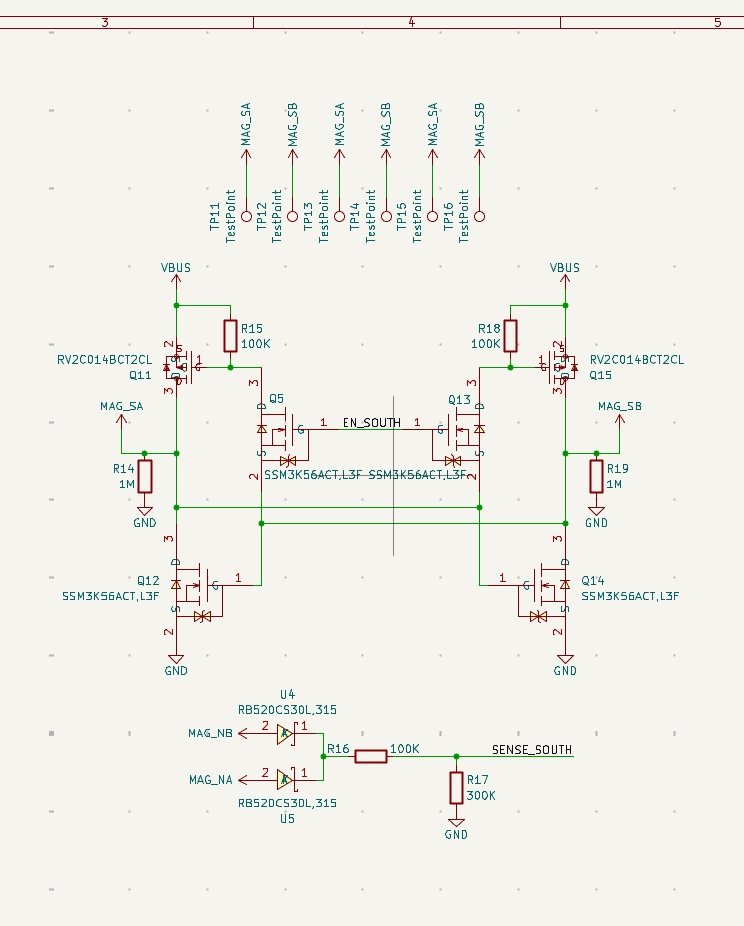
[picture p98: assets/journal/v2/keybit_v2_side_schematic.png]


all the transistors are DFN1006 (1x0.6mm) which is TINY but its the only way all of this fits on a ~5mm flap. heres a closer look at the south flap and the middle with the CH592, the crystal and the antenna in the corner with a keepout around it

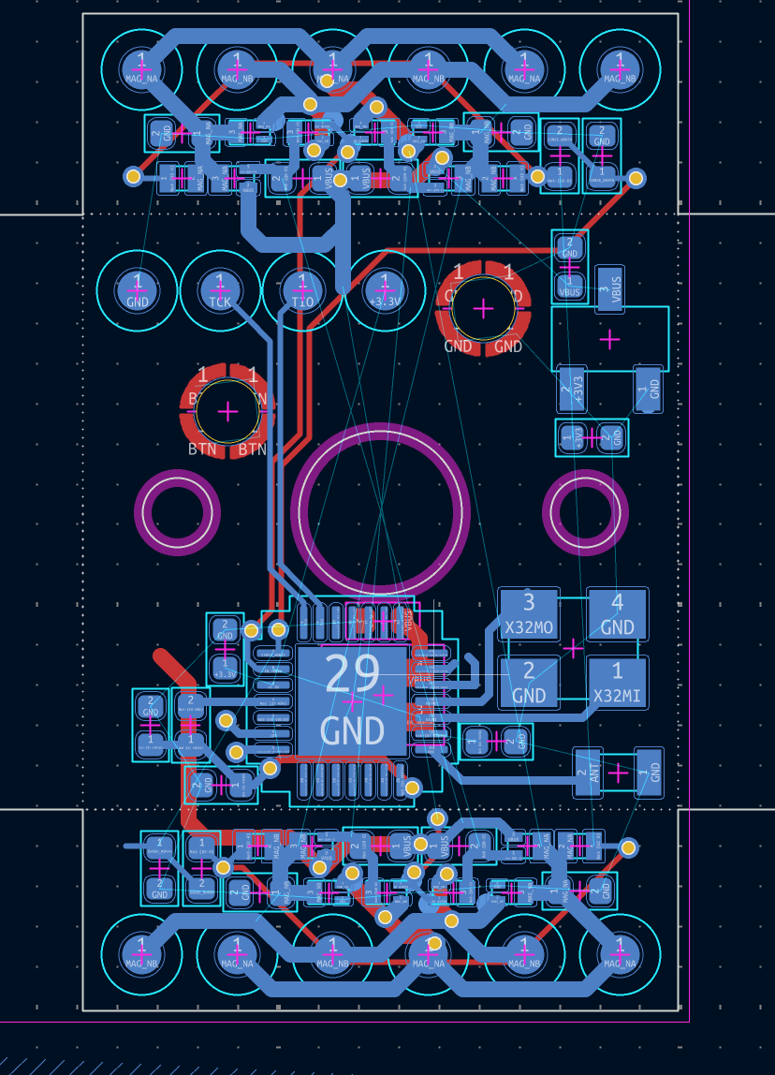
[picture p99: assets/journal/keybit_v2_flap_routing.png]


i also had to move a bunch of traces away from the folds since anything running along a bend will crack, and i switched the board to jlc's flex rules (1/3 oz copper, 0.025mm polyimide) so drc checks against what they can actually make.

# 11/03/2026 12:00 pm - more features to add

KH-1608-H08 chip antenna

https://www.jc-magnetics.com/Magnet-N52-1mmx2mm-discs-cylinders

actually ons econd thought ill just order a ton of these ^^ and conductive epoxy them to the contacts adn yea.

i was also looking at hall effect sensors for keys that support taht and was looking at HAL9303RSO (C42387471) as this is what is used but i was thinking about TMAG3001 but its more expensive.

i am also thinking rgb lighting so i need quite a bit of led's to run this adn especially off of battery so i'm thinking of having modules taht function as batteries adn can be recharged if there is usb there and yea. 

i also want the keys to be hot swappable so i need some connectors taht support this that are on lcsc so i chose Mill-Max Mfg. Corp. 3305-0-15-15-47-27-10-0

C17317022

then i started laying out the new keybit flex. each of the 4 flaps has 6 magnet pads going N S N S N S (MAG_NA / MAG_NB) and a row of tiny DFN1006 mosfets under them that let a neighbour connect either way round, plus the debug pads (GND, TIO, TCK, 3V3) and the hot swap sockets on the middle part. i also switched the board to jlc's flex rules (2 layer, 1/3 oz copper, 0.025mm polyimide) so drc actually checks against what they can make.

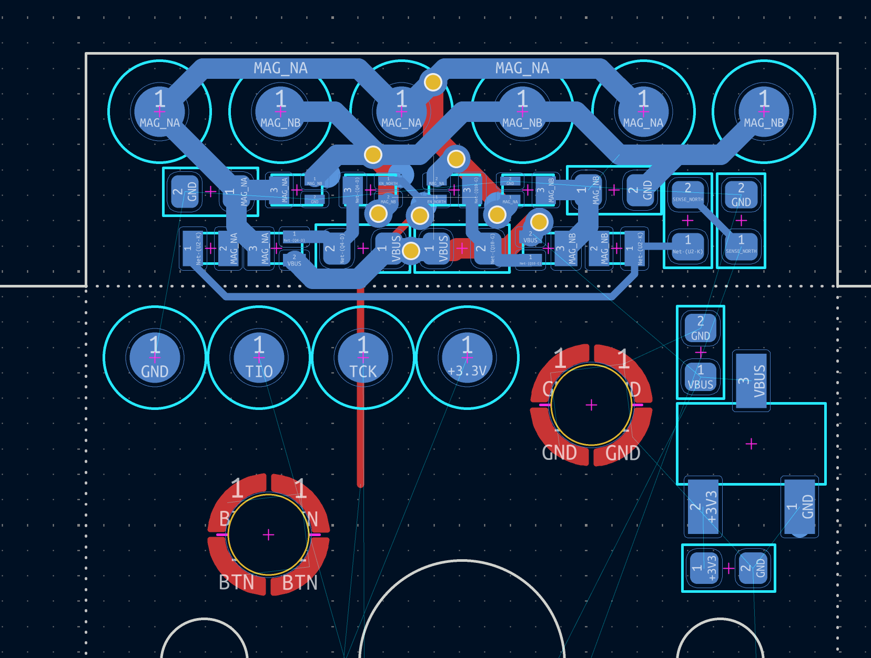
[picture p100: assets/journal/keybit_flap_layout.png]


heres how each side works. every side has 2 nets, A (the 3 N magnets) and B (the 3 S magnets), and since a neighbour can touch you either way round (rotated or staggered) either one could end up being + or gnd. so each side has 2 p-fets (P1/P2, RV2C014BCT2CL) that connect a net to VBUS and 2 n-fets (N1/N2, SSM3K56ACT) that connect a net to gnd, with their gates crossed over. if A is higher, N2 sees A on its gate and pulls B to gnd, and P1's gate gets pulled down to B so A connects to VBUS. if B is higher its the mirror image, so it basically acts like a bridge rectifier but without losing 0.6V per key like diodes would.

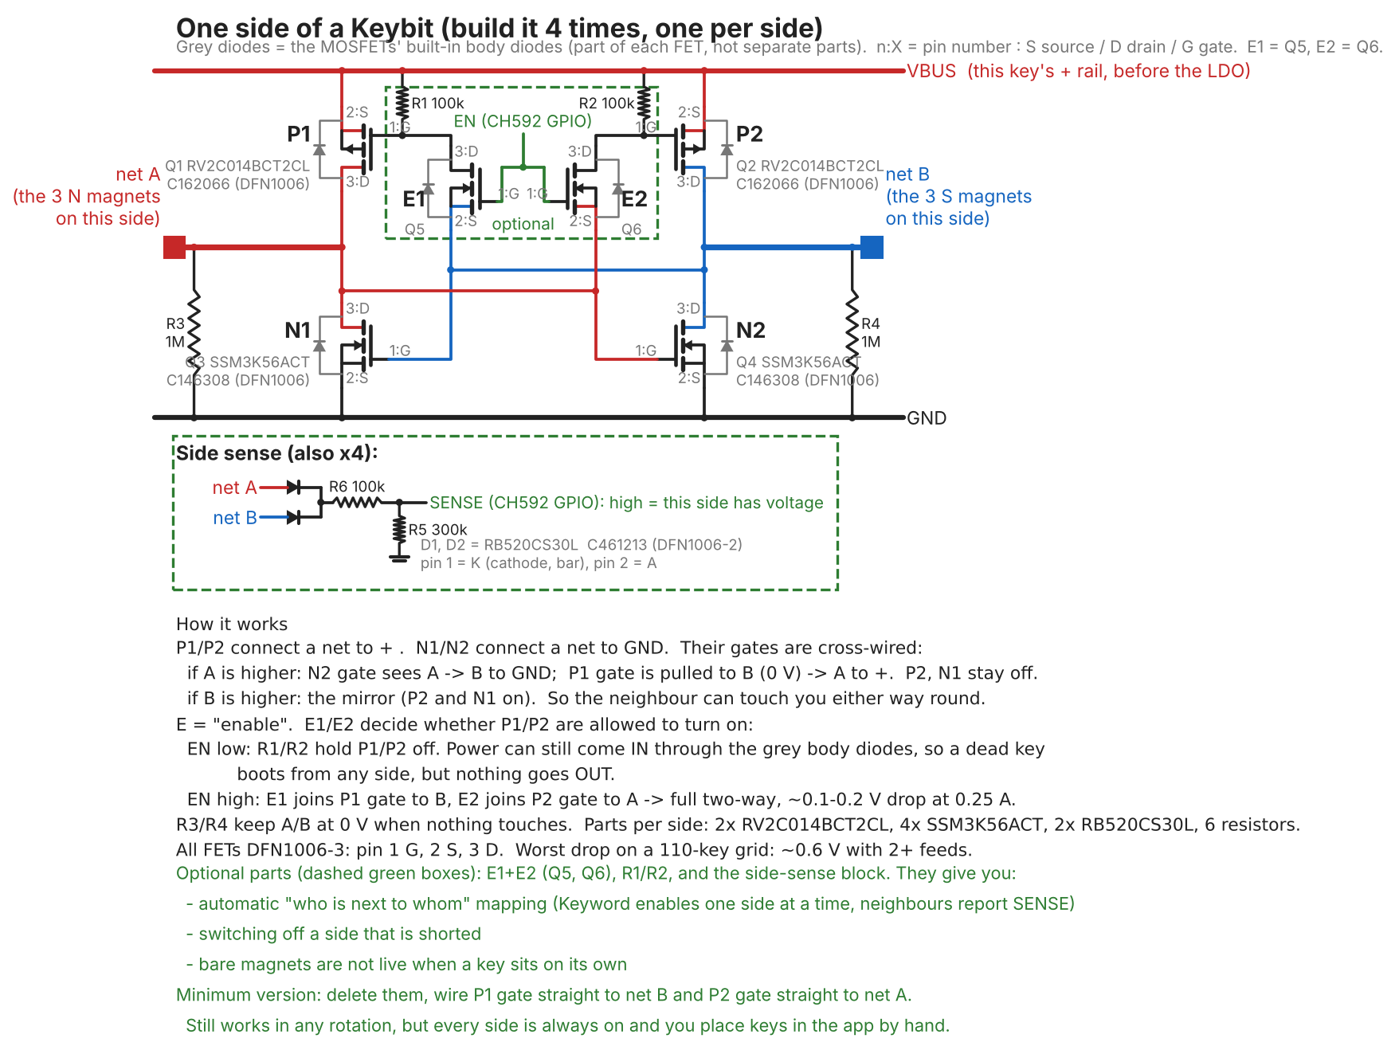
[picture p101: assets/journal/side_switch_schematic.png]


on top of that theres E1/E2, 2 more small n-fets on an EN pin from the CH592. when EN is low the 100k pull ups keep P1/P2 off, so power can still come in through the body diodes (a dead key can still boot from any side) but nothing goes out. when EN is high the side fully turns on both ways. the 1M resistors keep A and B at 0V when nothing is touching. then theres a sense part per side, 2 RB520CS30L diodes from A and B into a 100k/300k divider going to a gpio, so the key can tell which of its sides have power and the keyword can figure out which keys are next to each other by turning one side on at a time. everything is DFN1006 (1x0.6mm) so it fits on the flaps, and i simulated it and the worst key on a 110 key board only drops like 0.6V as long as theres 2+ battery boards or usb feeding it.

still need to move the parts and the trace along the fold away from the bend and round off the corners where the flap meets the middle so it doesnt tear.

# 11/01/2026 11:00 pm - thoughts on the first revision and prep for v2

_Time spent: 1h_

okay so this is fine and all but taking a look at the state of the project, i think that i shouldn't waste too much time fleshing out this first version anymore as i know how to improve it and have tested everything there is to test (well maybe except battery charging but i'll do that rn). i want to make this significantly cheaper so that others can actually use this, one of those ways would be to use CH592D and make a 1u controller board instead of a 2 stacked 1u boards as that caused a lot of inneficiencies with the case and also the corners are kind of cooked (this also means i can have a bigger battery on the top) and following the designs for the ones on the bottom, this should all fit inside a caserather nicely. i also plan on making versions that have rotary encoders, oleds, and yea. some other stuff that i found would be to make everything from a flex pcb as this would make things significantly easier to put together in a case.. i am also thinking about steering away from pogo pins and just using magnets with conductive epoxy for the connections as this would save a TON of money and yea. i think that this is feasable and i was looking at displays and found this https://www.buydisplay.com/square-white-0-96-inch-96x96-oled-display-screen-ssd1317. i'll start cadding a new version tmrw but oh well this is good for a v1. 

https://www.amazon.com/HARFINGTON-Stainless-Cylindrical-Furniture-Installation/dp/B0F6D1P67B

# 11/1/2026 1 pm - tough 2000 cases (final v1 journal)

_Time spent: 5h_

ok so the cases i printed before were pretty brittle, so i reprinted all of them out of tough 2000 resin on the form 4 and they came out wayyy better. heres the keyword with 5 keybits around it in the new cases

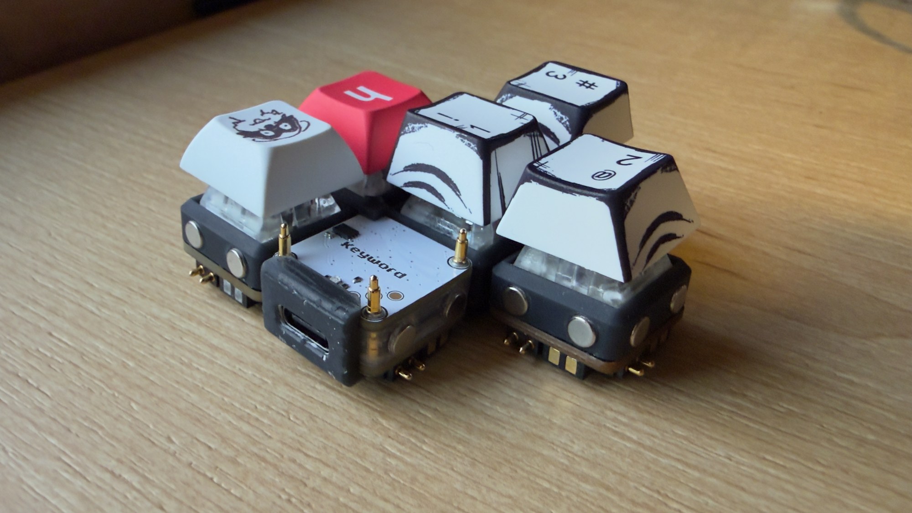
[picture p102: assets/journal/v1/tough2000_cases.jpeg]


the third keybit in a chain also wasnt getting detected, but it was literally just one bad joint where a pogo pin wasnt touching lol. after swapping keybits around i had 4 keybits (3 deep) working for a full minute so the firmware is fine.

i also made macros go up to 64 steps instead of 16 (the keymap only saves as much of each key as it needs now so it still fits in flash) and gave the app a new icon.

then i looked at batteries again. the keyword by itself would be fine on a tiny cell, but each keybit pulls like 3-5mA bc it never sleeps, so after 6-8 keybits it would be too much. so next up is making the keybits sleep until a key gets pressed.

# 10/29/2026 4 pm - usb keyboard and faster side bus

_Time spent: 5h_

ok so the chained keybits were showing up in the app but not in the right spot, so now each keybit says which side of which keybit its on and which way its facing (v11) and the app puts them exactly where they are. i also made a little sim that runs the real keybit and keyword bus code on my mac with a bunch of keybits at once so i could test without plugging stuff in over and over. with that i got the side bus back up to 100kHz with keybit v12 and v13, and each event has a number and a crc now so presses dont get lost or doubled.

then i made the keyword show up as a usb keyboard too, so it types from the saved keymap even without the app open, and fixed saving the keymap while bluetooth is connected. and now it actually types!!

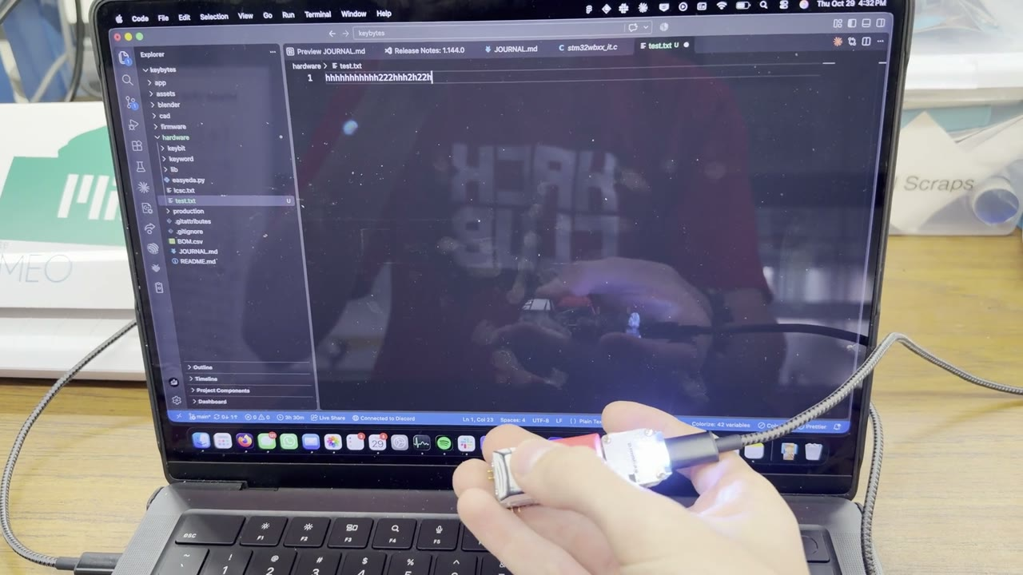
[picture p103: assets/demo2-preview.jpg]
Demo


# 10/28/2026 11 pm - flashing keybits and chaining them

_Time spent: 6h_

so i still couldnt get the keyword to flash the keybits so i got some CH32V003 dev boards off amazon to see if my chips were fried. turns out it was my swio driver lol, the timing was off bc the delays werent getting inlined so a 1 looked almost like a 0. after that the halt was breaking the link and most of the writes were getting dropped, so i gave writes their own timing and made it verify and resume instead of starting over, and then it FINALLY flashed the keybit firmware!! it also works without the 1k pull up now and blinks blue while flashing and green when its done.

a big bag of switches also came in so i can build more keybits

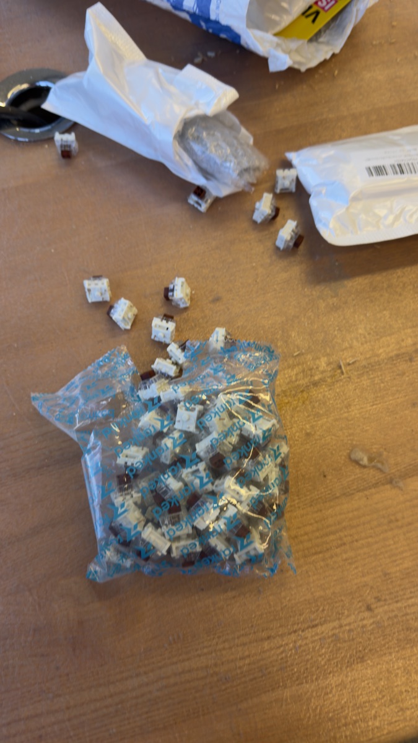
[picture p104: assets/journal/switches_came.jpeg]


then the sides werent detecting anything, the keybits couldnt keep up with 100kHz i2c so i dropped it to 20kHz. after that it was a bunch of bugs with keys connecting and disconnecting over and over (the keybit jamming the bus, timeouts too short, the dock blocking the sides while flashing) and i went through keybit firmware v7 to v10 fixing them

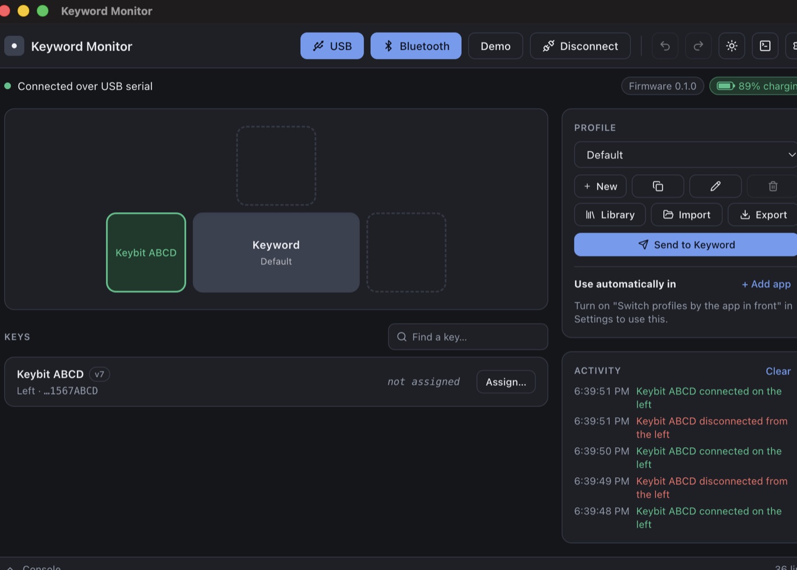
[picture p105: assets/journal/app_side_flapping.jpeg]


also when i put a board on the wrong way the whole keyword turns off, so for the next revision i want to protect the 3.3V on the dock and sides and add some resistors on the data lines. it also detects when a keybit is backwards next to another one now

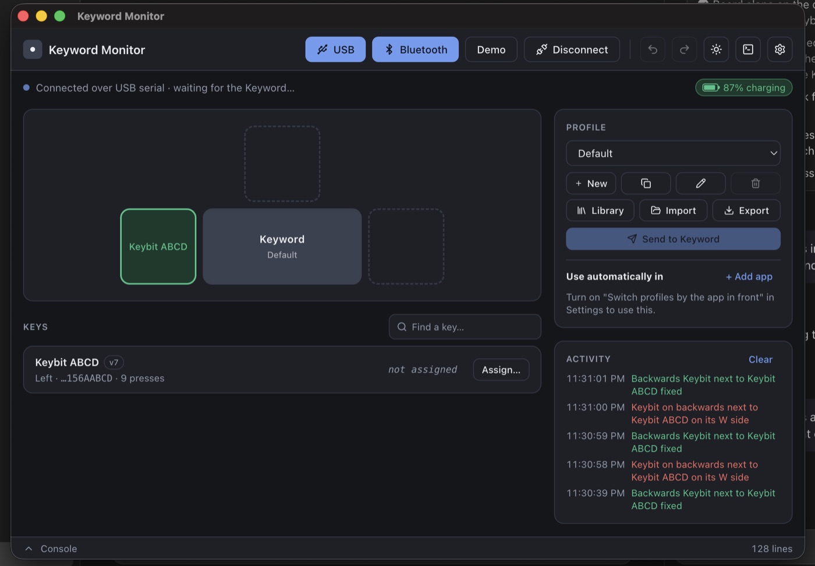
[picture p106: assets/journal/app_backwards.jpeg]


and by the end i had 3 keybits chained off the keyword and all of them showing up in the app!!

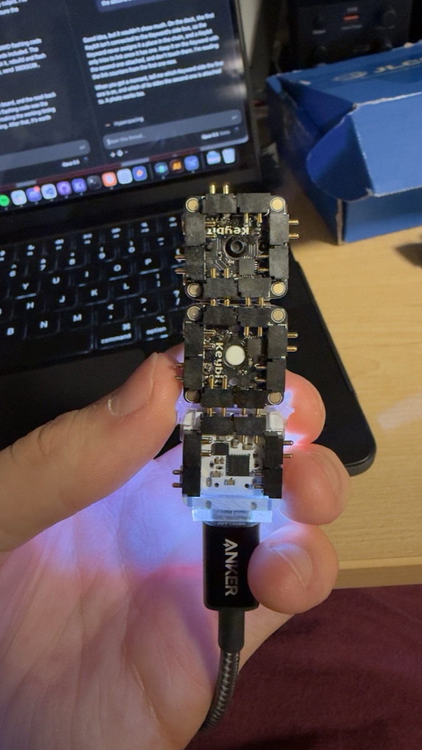
[picture p107: assets/journal/v1/three_keybits_chained.jpeg]


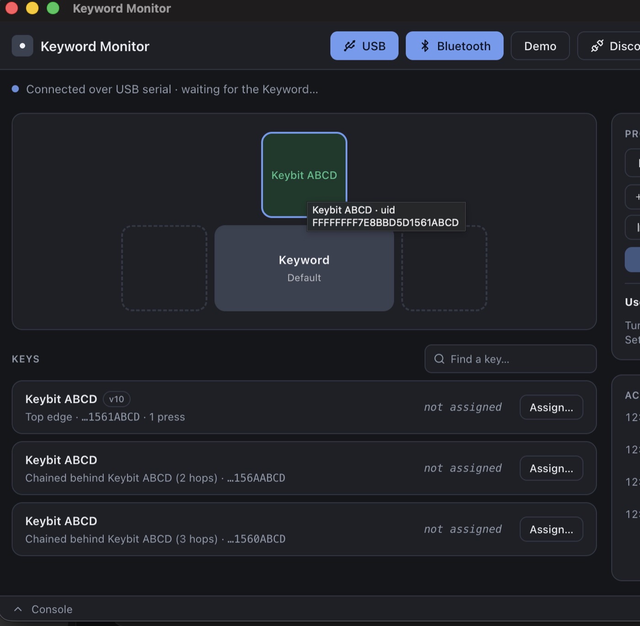
[picture p108: assets/journal/app_three_hops.jpeg]


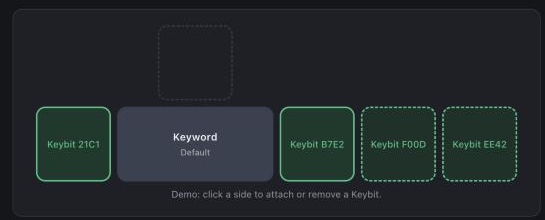
[picture p109: assets/journal/app_board_chained.png]


# 10/27/2026 10 pm - ideas for the next keybit

_Time spent: 4h_

ok so the current keybit only works in a straight grid and the pogo headers are like half the cost, so i spent today thinking about how to make the next one better. first idea was sending power and data over just 2 wires, kinda like the ac coupling from my 6.2020 lab where the data goes through a cap onto the dc line

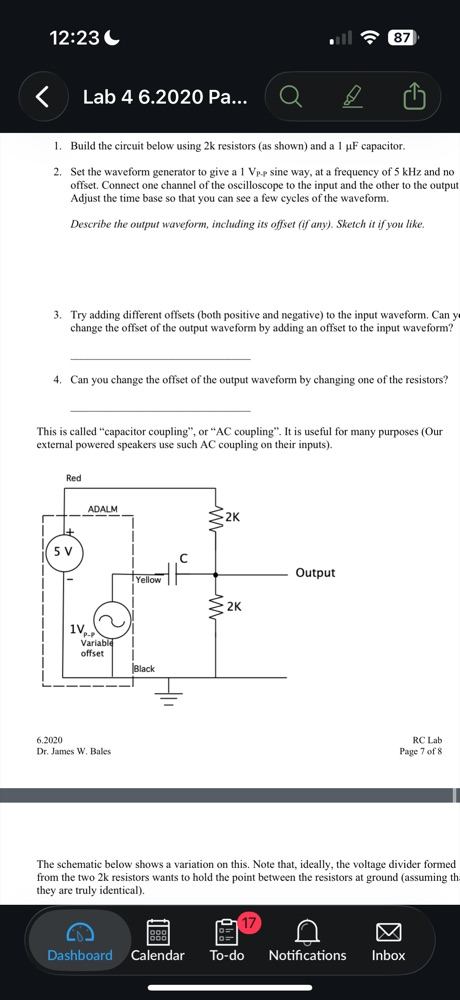
[picture p110: assets/journal/v1/rc_coupling_lab.jpeg]


then for staggered keys, if the contacts are spaced 2.38mm apart (19.05 / 8) a key can slide along another one and snap every 25%, and if every contact is a magnet on a pogo pin going N S N S around the sides it also works when you rotate it. here are my sketches of it

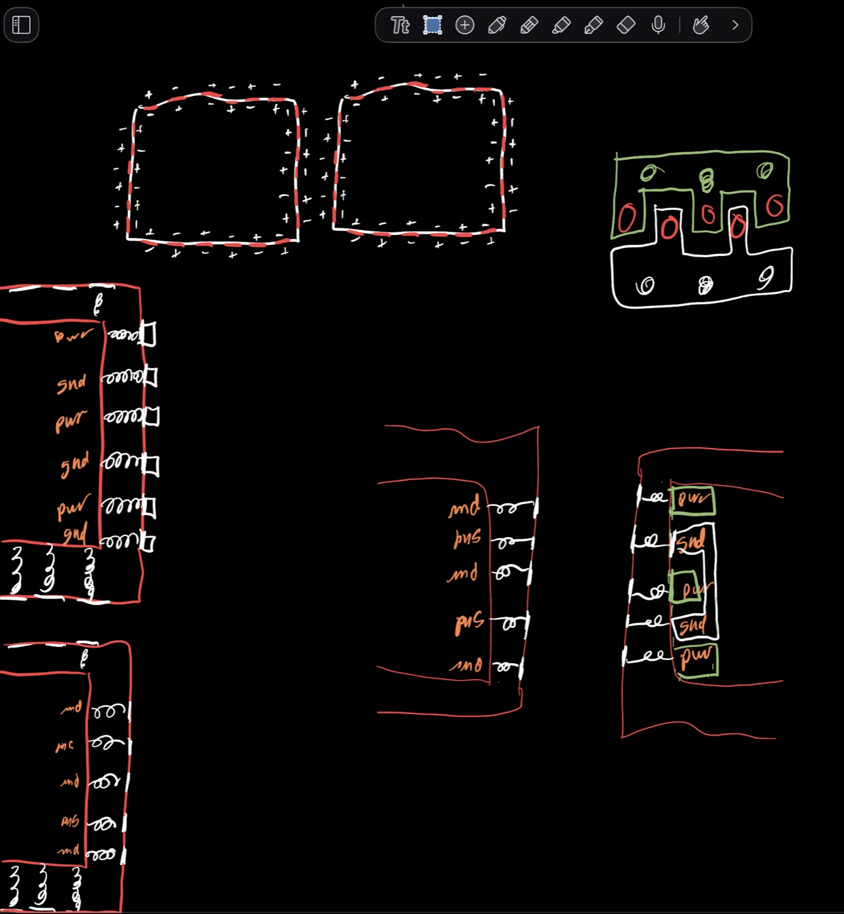
[picture p111: assets/journal/magnet_pogo_sketch.jpeg]


i was looking at these 1mm x 2mm magnets for it, but theyre a lot weaker than the J7 ones so i would probably need a second row just for holding

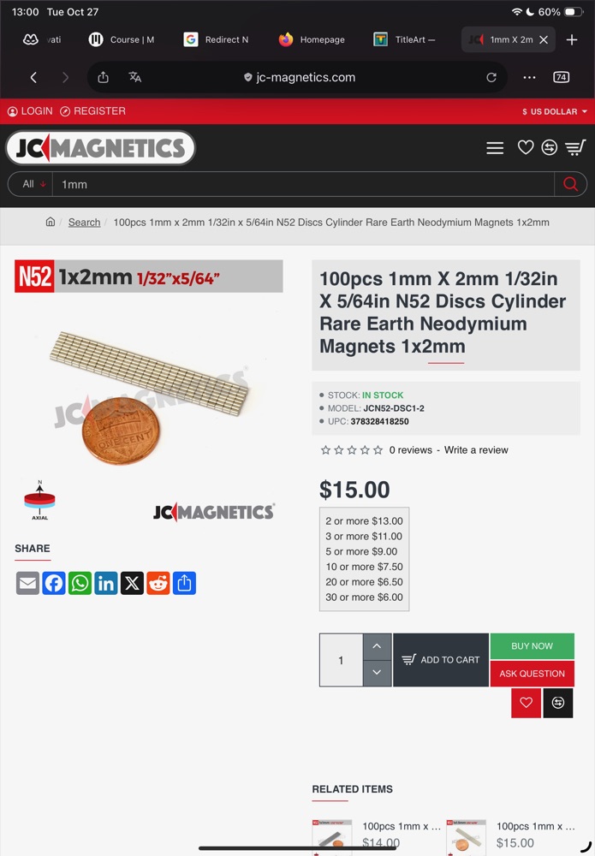
[picture p112: assets/journal/v1/jc_magnetics_1x2.jpeg]


the other idea is making the keybit a flex pcb with 4 flaps for the pogo pins that fold up into a box inside the case, which gets rid of the expensive right angle headers. i priced it out on jlc and its like $1.49 a board.

i also rewrote the desktop app in typescript with react and tailwind and cleaned up the firmware folder

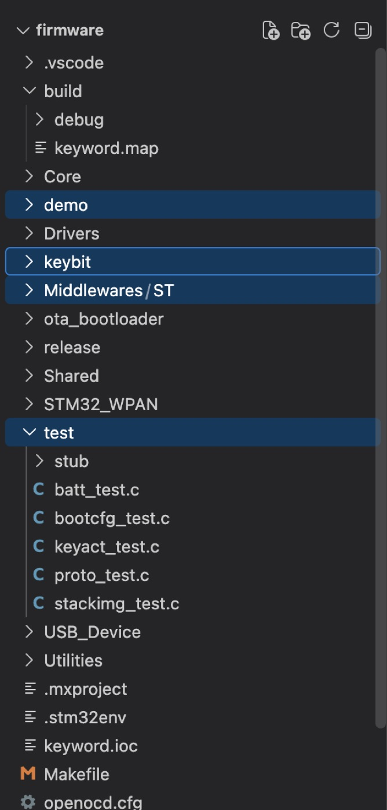
[picture p113: assets/journal/v1/app_keybit_pcb.jpeg]


# 10/26/2026 6 pm - keyword flashed and bluetooth

_Time spent: 5h_

so it turns out my STLINK V3 was the problem the whole time (it didnt work on ember either), i used an old STLINK V2 and it connected right away lol

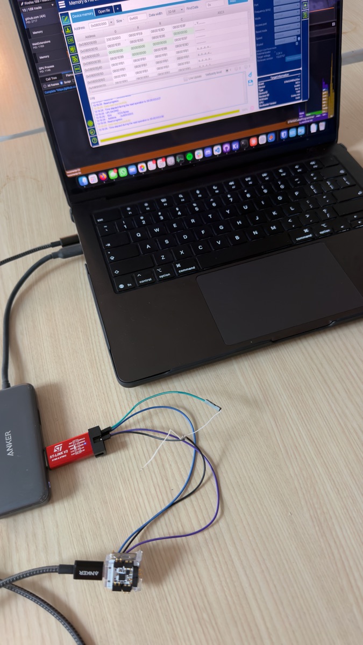
[picture p114: assets/journal/v1/stlink_v2_flashing.jpeg]


i installed the bluetooth stack and the bootloader and it showed up as "Keyword" in bluetooth with the green led!! then i got updating it over bluetooth from the app working and flashed the second keyword too. the battery also says 87% with no battery plugged in lol



the keyword still couldnt see a keybit on the dock tho, and i also added some protection in the firmware for when a keybit is put on rotated since that can jam the bus and stress the chips.

# 10/25/2026 11 pm - swio, bluetooth and not being able to flash

_Time spent: 6h_

now that it worked i wanted the keyword to be able to flash the keybits by itself. the 3 studs on top of the keyword line up with the pads on the bottom of a keybit, so i wrote a driver that bit bangs the CH32's one wire debug protocol (swio) and the keyword can flash any keybit put on top. i also wrote the keybit firmware, made the keyword hand out addresses using each chip's unique id, and added bluetooth and a desktop app to remap keys.

then i spent most of the night trying to flash the keyword and it would NOT connect. i tried the wrong header on the STLINK, soldering wires on, swapping the data wires, soldering reset, an Atmel-ICE, and i even messed up the boot settings over usb dfu aaaa

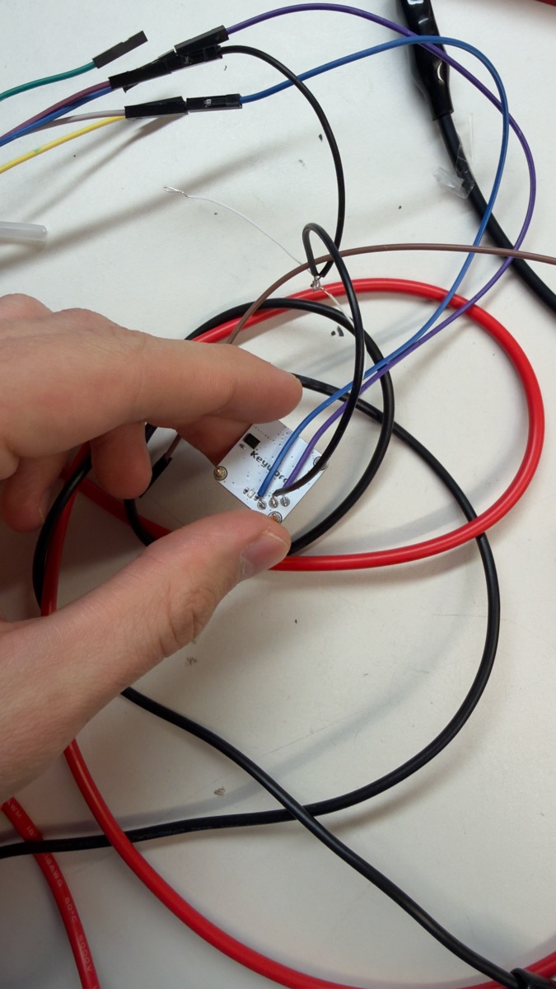
[picture p115: assets/journal/v1/keyword_swd_wires.jpeg]


# 10/24/2026 9 pm - it finally works!!

_Time spent: 4h_

ok so the press fit coupon came out and none of the 7 pockets were actually press fit, the magnets just dropped into all of them so the form 4 prints them a bit oversize and im sticking with glue. in the end i went with the normal J7 for the keybit (8 4mm x 3mm magnets sticking out 0.75mm) and the J7.1b for the keyword which uses 2 of the 4mm x 1mm magnets on collars on every side, since that one actually worked.

then i cleaned up onshape, moved everything back into the original keybit, keyword and keybytes docs, trashed the old 4x2 magnet docs and updated the main assembly with the 1.5mm gap between cases. all the joint tests are in [`cad/tests`](cad/tests) and the final cases are in [`production/CAD`](production/CAD), all as step files now.

i also changed the keyword to white solder mask with black silkscreen on both sides in kicad.

and then i put it all together and it FINALLY works!!! here is a picture of it



and here is the demo

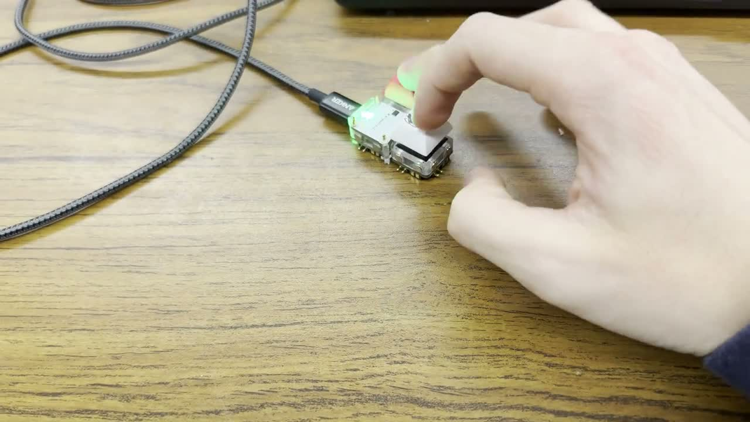
[picture p116: assets/demo-preview.jpg]
Demo


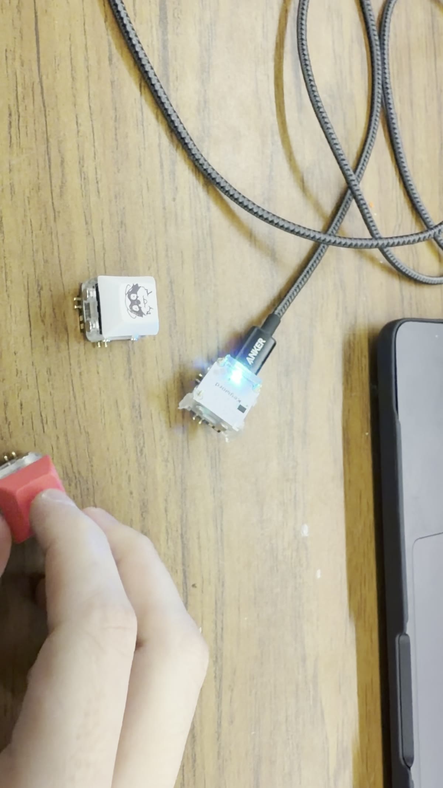
[picture p117: assets/journal/keybit_keyword_table.jpeg]


later that night i also posted it on r/MechanicalKeyboards

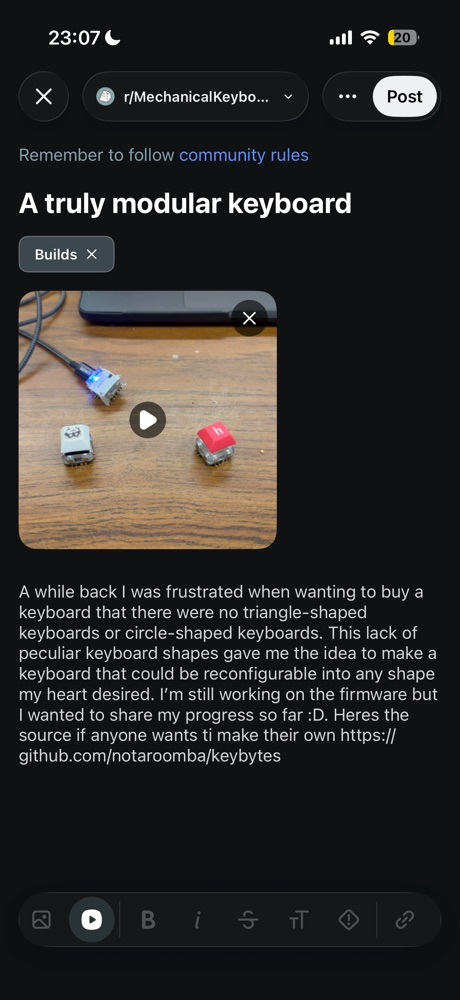
[picture p118: assets/journal/v1/reddit_post.jpeg]


# 10/23/2026 10 pm - gluing magnets and picking a joint

_Time spent: 5h_

so i started gluing the magnets in with gorilla super glue gel (from the inside so it doesnt get on the faces) and when i put 2 J7 keybits together they tilted up a little. i thought i had to sand it but it turned out glue had gotten onto the outside face of some magnets so they werent flat, after scraping it off with a razor the tilt went away. btw acetone doesnt hurt the magnets but it does wreck the resin so dont get it on the case lol

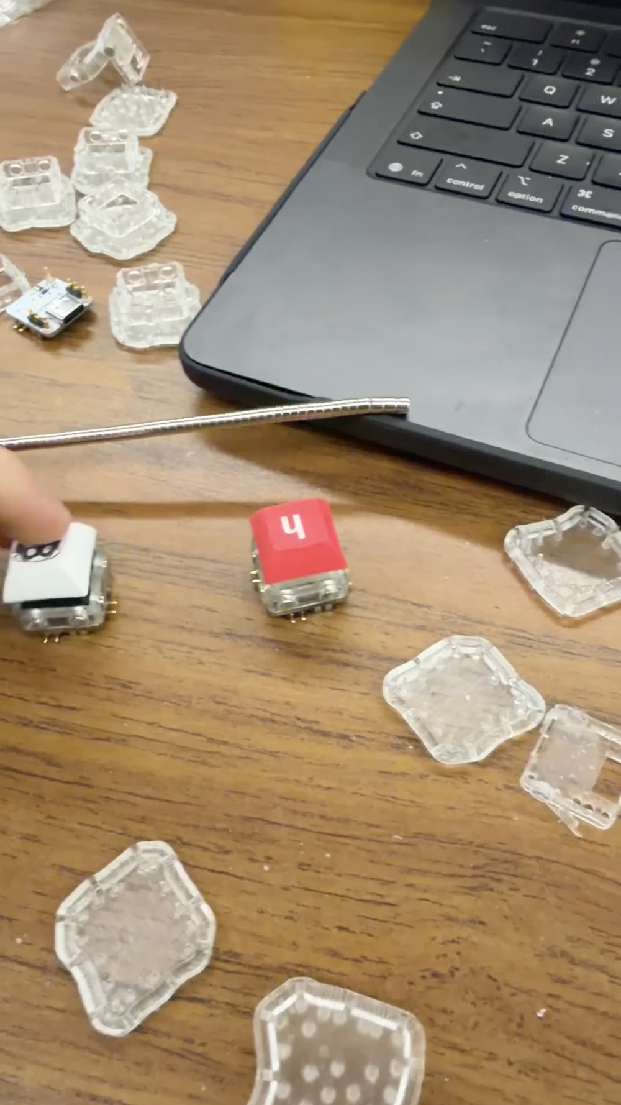
[picture p119: assets/journal/v1/j7_cases_magnets.jpeg]


J7 was the one i liked the most so i made it the main keybit case.

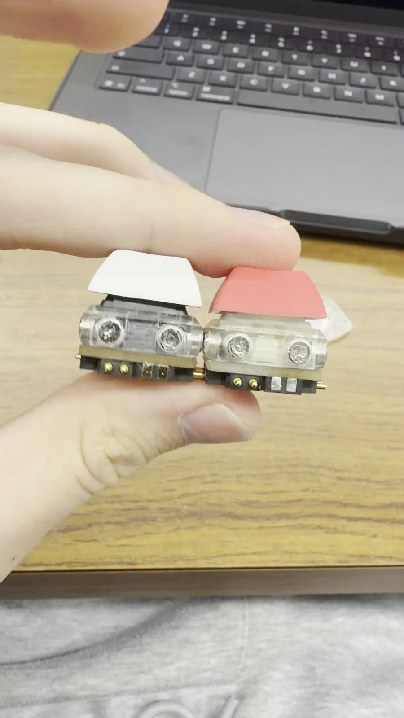
[picture p120: assets/journal/v1/j7_keybits_joined.jpeg]


the magnets kept deflecting when i pushed them in against the keyswitch so i also designed a jig that drops in where the switch goes so they all stop at exactly 0.75mm.

for the keyword the plain pocket J7 tray was too tight for the 4x2 magnets (probably resin curing tolerance) but the collar one worked. i also realized i need at least 2 magnets per side on the keyword like on the keybit, and since the collars stick out a 4x1 magnet never reaches into the tray so it doesnt hit the side contacts or the inductors anymore. that made the J7.1 and J7.1b keyword trays and also a press fit coupon to see if i could skip the glue completely.

i also priced out a full sized keyboard (2 keywords and like 110 keybits) and its like $900 assembled, almost half of that being the pogo pins lol, so if i ever make a full one ill buy them seperately and solder them myself.

# 10/21/2026 10 pm - pogo pin force

_Time spent: 3h_

so after the first magnet cases i noticed the magnets werent strong enough to hold the modules together against the pogo pins. i also tried putting the magnets into the pockets and sometimes they just wouldnt stick and would fall out.

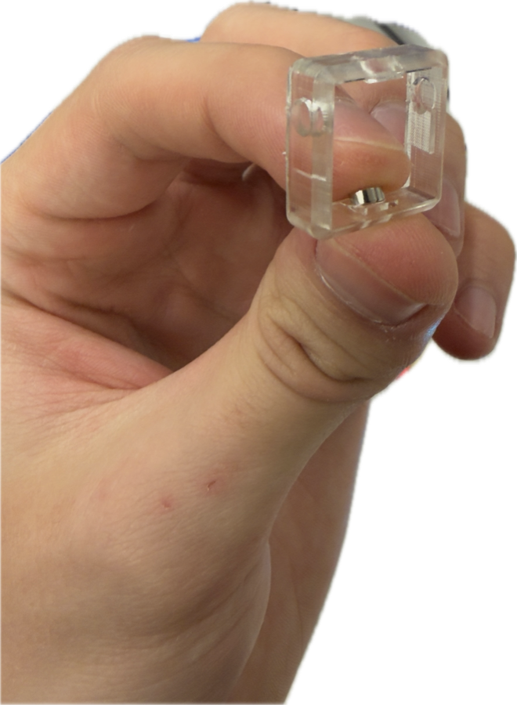
[picture p121: assets/journal/magnet_falling_out.png]


i spent some time looking on digikey for single right angle pogo pins with a low enough spring force that a 4mm x 1mm N52 magnet could hold it. the closest thing was the Mill-Max 0967 horizontal smt pins with the low force springs, but they need a different footprint so i would have to redo the boards, so i decided to just make the magnets stronger instead.

# 10/20/2026 9 pm - tinkering with designs and led blink

_Time spent: 8h_

so i have been tinkering with the designs and stuff the past 2 days, mostly the keyword case in onshape. i made a bigger version of the case with holes for the magnets and split it up into an inner part and left and right 
side pieces. 

**this was the result of many iterations that i had to spend resin printing, curing, sanding / polishing, and then tinkering with the design and making tons of modifications** 

this is v12 of the case and its the most overengineered thing ive done, i also got n55 magnets from some sketchy seller so hopefully they hold

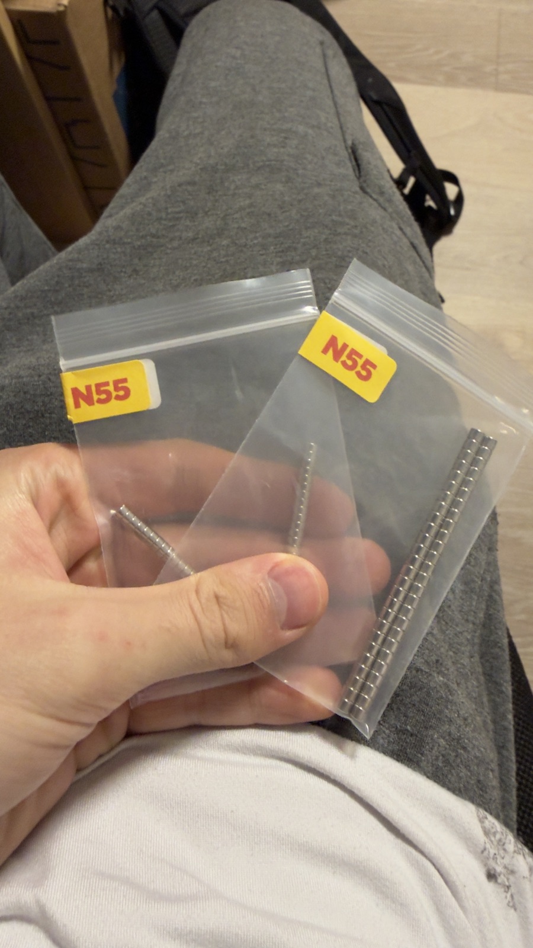
[picture p122: assets/journal/n55_magnets.jpeg]


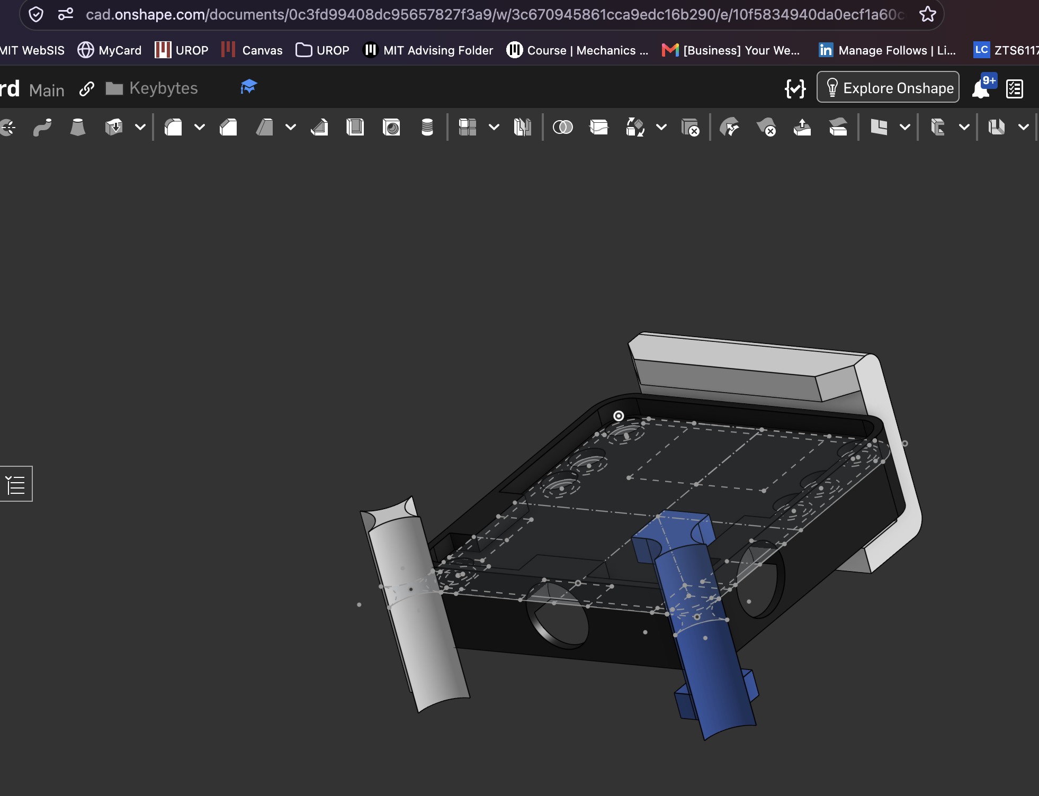
[picture p123: assets/journal/keyword_case_sketch.png]


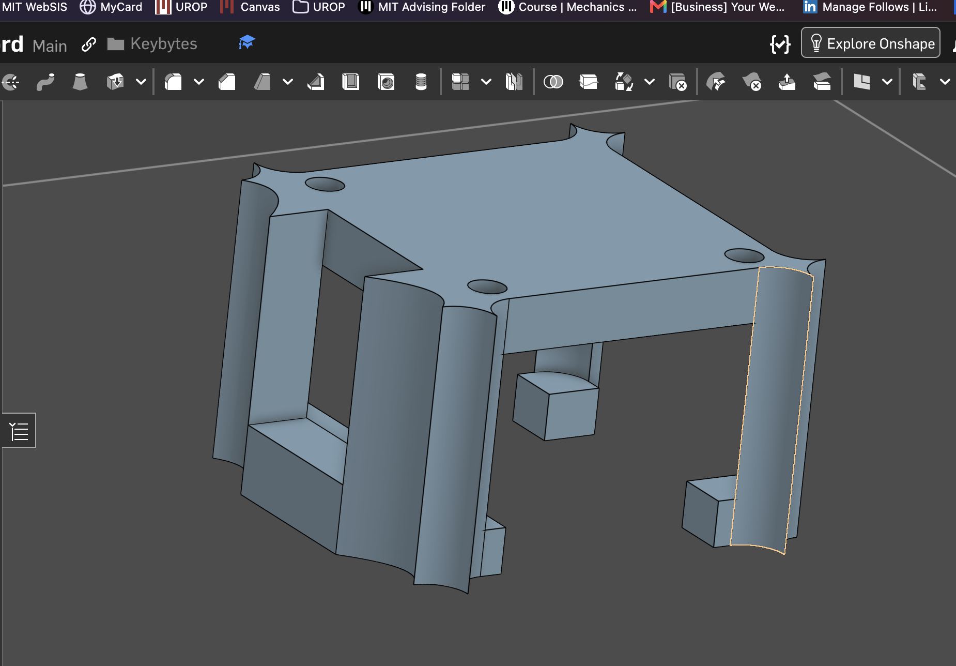
[picture p124: assets/journal/v1/keyword_case_inner.png]




then i put the pcb in to check that the pogo pins and usb line up with everything and yea

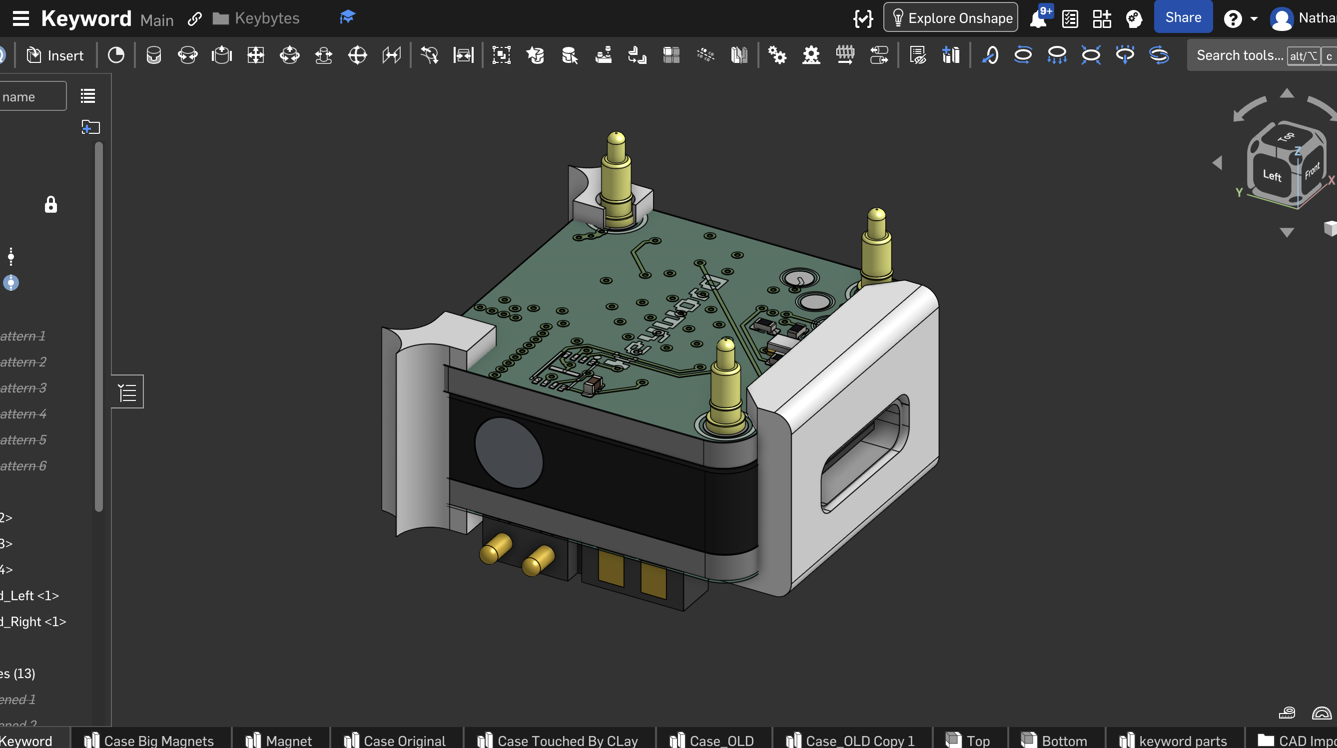
[picture p125: assets/journal/v1/keyword_case_with_pcb.png]


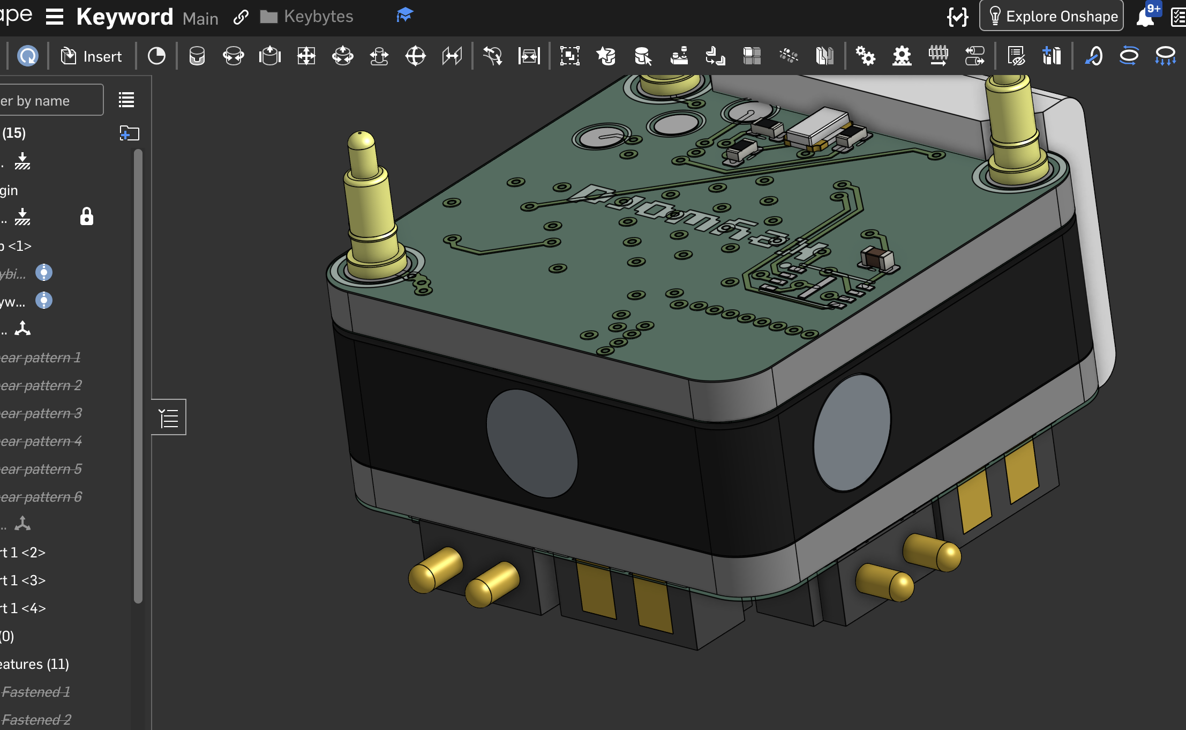
[picture p126: assets/journal/v1/keyword_assembly_pogo.png]


i also did a section view of the whole thing to check nothing was hitting inside, its printing rn so hopefully it works



i also got the first firmware on the keyword, its just a blink that cycles the rgb status led through red, yellow, green, cyan, blue, magenta, white and off every 500ms. the only downside is that i gotta use the swd to flash it bc i changed the boot options aaaaaa

# 10/16-18/2026 5 pm - resin printing and flashing

_Time spent: 14h_

so the boards came! and i learned how to resin print at the makerspace, you print it on the formlabs printer, then wash it in the 2 ipa washes, let it dry and then cure it

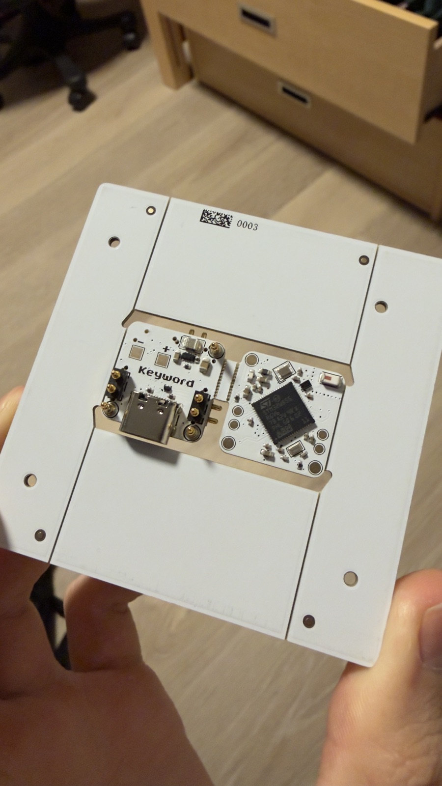
[picture p127: assets/journal/v1/boards_came.jpeg]


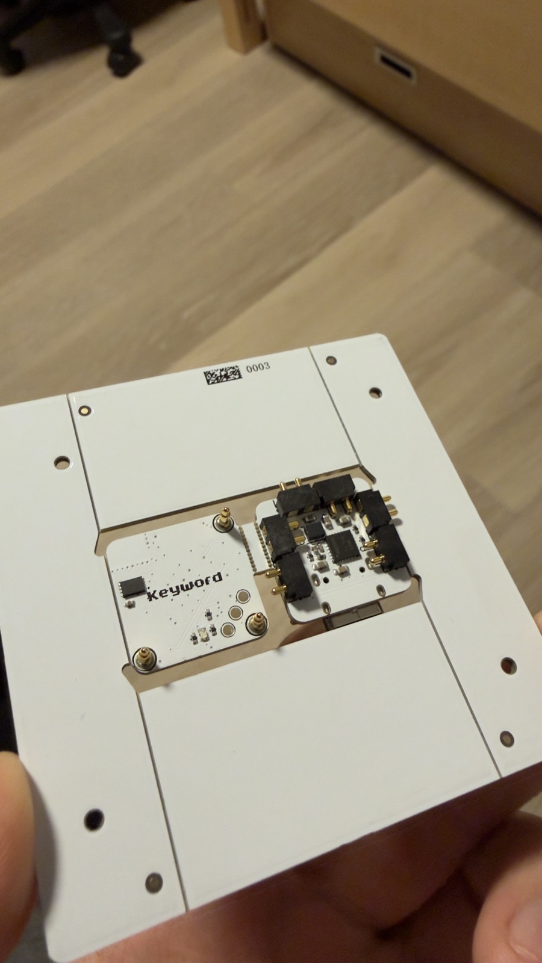
[picture p128: assets/journal/boards_came_2.jpeg]


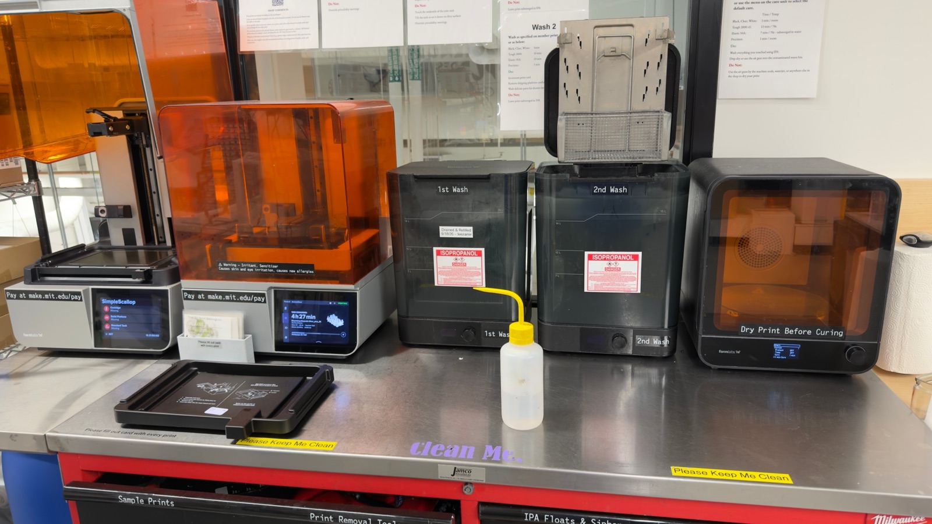
[picture p129: assets/journal/resin_station.jpeg]




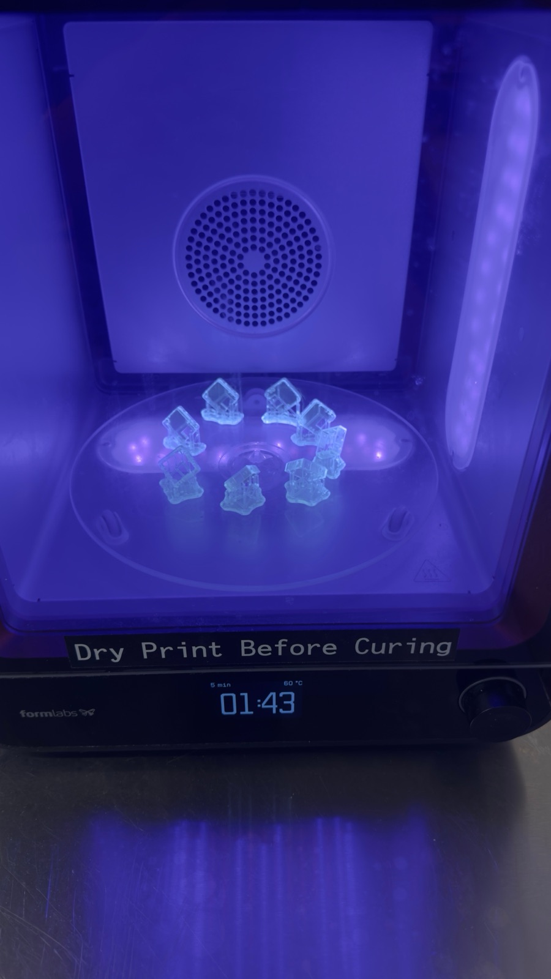
[picture p130: assets/journal/v1/resin_curing.jpeg]


and i got a bunch of clear prints out of it, v1 had some problems so i still gotta clean up the resin print stuff

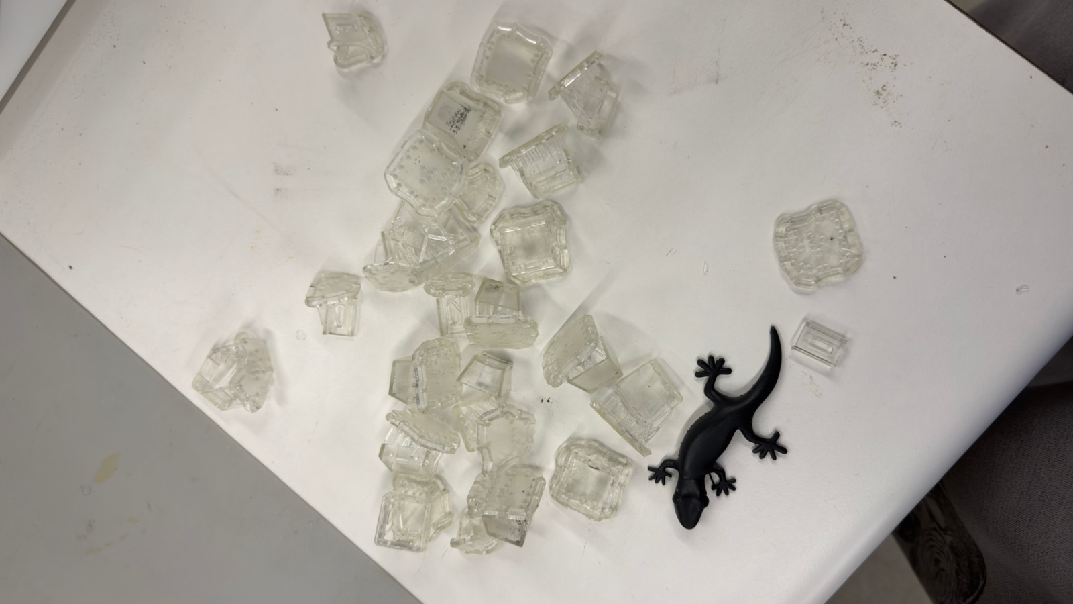
[picture p131: assets/journal/resin_prints.jpeg]


i also got it to flash! it connects to STM32CubeProgrammer over usb dfu even with the usb c going through the pogo pins and yea

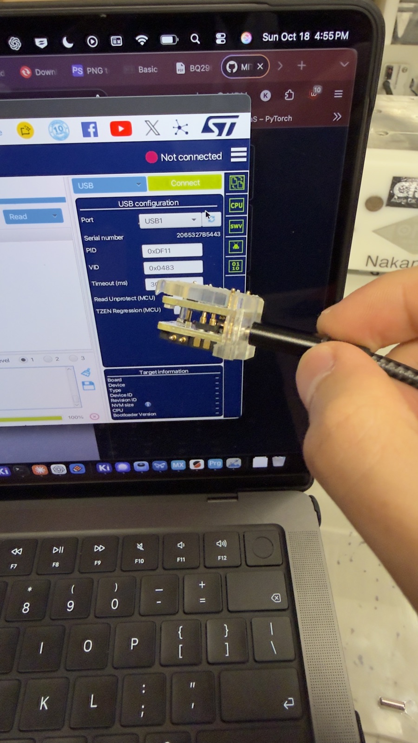
[picture p132: assets/journal/dfu_programmer.jpeg]


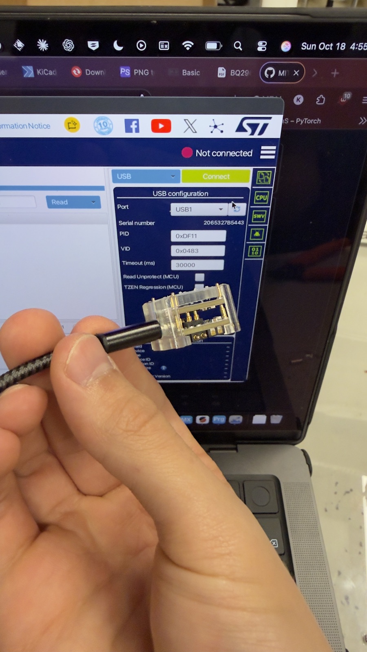
[picture p133: assets/journal/dfu_programmer_2.jpeg]


# 10/2/2026 1 pm - fixing board errors

_Time spent: 5h_

so before ordering i went through both boards again and ran drc and erc on everything and found a bunch of stuff that would have been bad

the biggest one was on the keybit, one of the pogo header gnd pads wasnt connected to anything, the via was there but the track to it never got drawn so that side would have had no ground. also the SDA3 trace was basically touching the 3.3V pad on one of the pullups (0.02mm lol) so i moved the resistor and rerouted that and yea

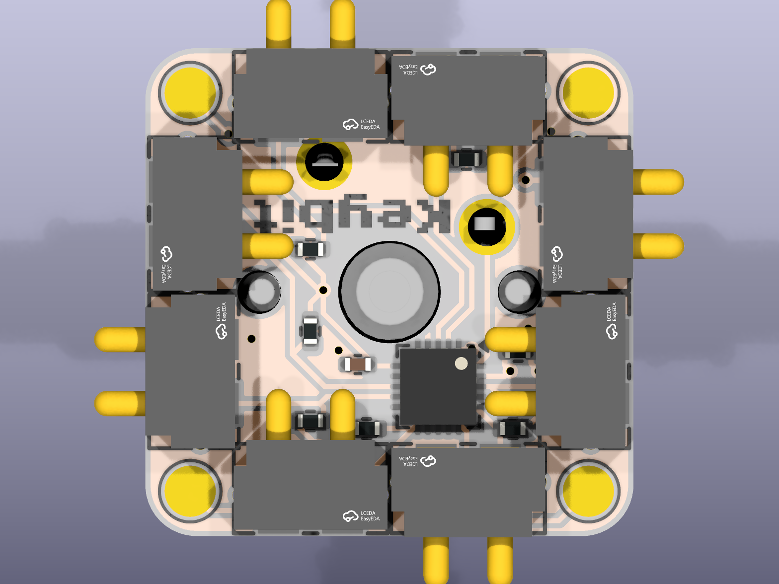
[picture p134: assets/journal/v1/keybit_fixed_bottom.png]


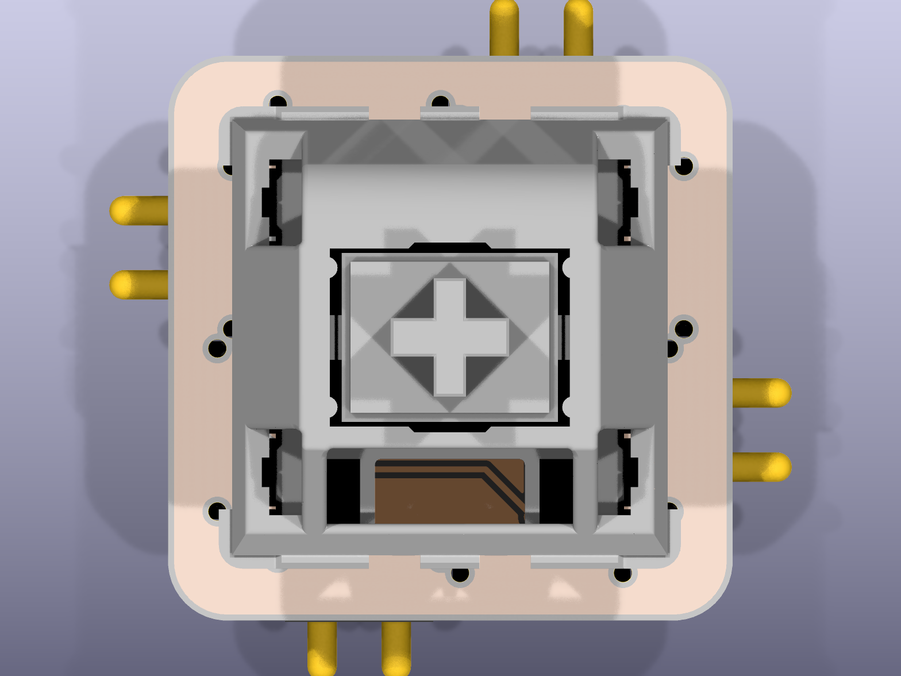
[picture p135: assets/journal/v1/keybit_fixed_top.png]


on the keyword a bunch of the resistors all had the same lcsc number which was a 150 ohm resistor with 0 stock so jlc would have put the wrong values on the charger so i cleared those, and the pads that the pogo pins land on were in the bom as pogo pins so i set them to dnp

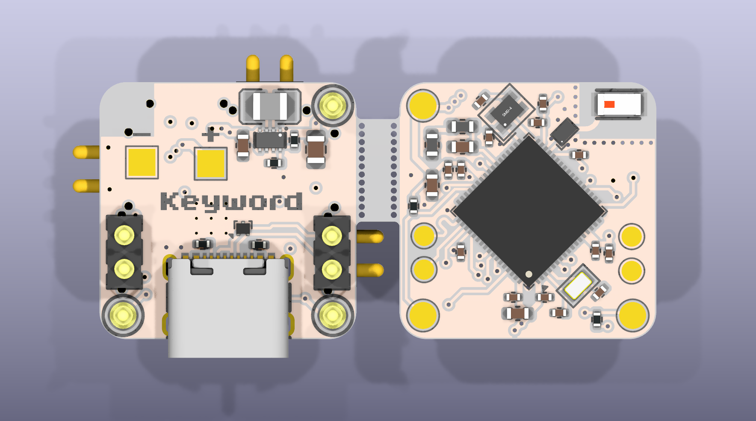
[picture p136: assets/journal/keyword_fixed_top.png]


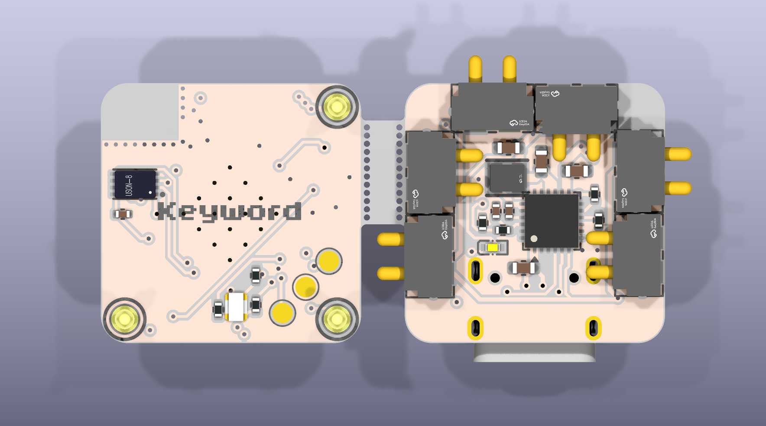
[picture p137: assets/journal/v1/keyword_fixed_bottom.png]


i also fixed all the library and 3d model paths since they were hardcoded to my windows pc and didnt work on the mac, now they are relative to the project. then i added the jlcpcb order and shipping to the bom

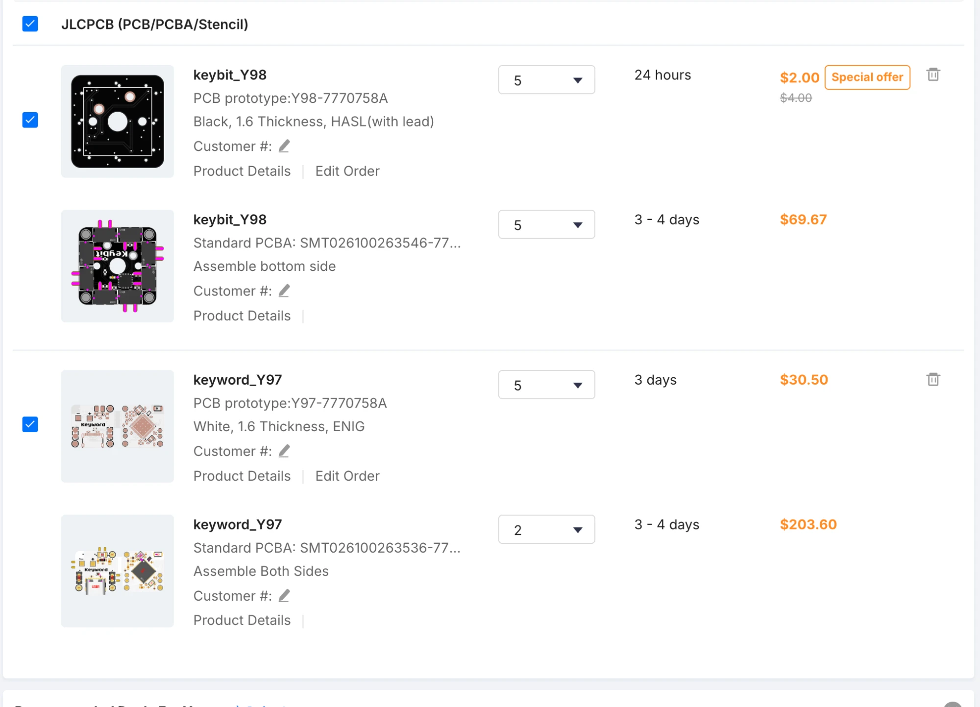
[picture p138: assets/journal/v1/jlcpcb_order.png]


# 6/18/2026 8 PM - Finish CAD

_Time spent: 8h_

So i did a thing with clay and finished the case andx yea, this took a long time as I had a few revisions and yea ts is finished, i will blender render soon as im macondoing and just wanna shoip this so it arrives druring fallout



# 4/10/2026 3 AM - More Cad and finished Keybit Case

_Time spent: 7h_

So after messing around with a few designs in onshape, I got a better Keycap design



there are internal holes for the magnets and the thing latches on to the key switches side latches as shown here

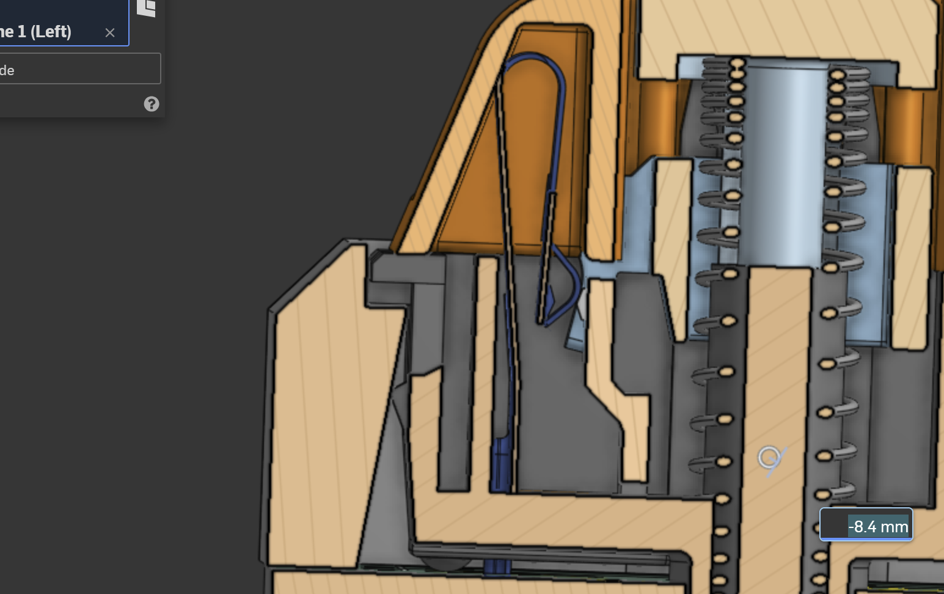
[picture p139: assets/journal/v1/keycap_latch.png]




i then printed it out and did a thing and got this



and yea thats basically it, Ill plan on continuing the cad for the main pcb and make it cleaner

# 4/8/2026 12 AM - CAD + Case

_Time spent: 7h_

Idk how to cad but I tried to do it and ended with soemthing like this:



which got printed and it kinda works but the corners are too small and yea



I printed a few out and showed them to clay and he liked them and yea, altho its thin I plan on making the walls thicker and yea, aside from that I think its pretty much done

# 4/6/2026 3 AM - Flash and LED and Touchups

_Time spent: 7h_

So I kinda want to be able to program the CH300v chips from the main board so I needed to add in some pogo pins and then I would also need flash to store the code so I added that in and updated the STM32 MX for that



Then after that I finished routing up everything and also replaced the old LED with a RGB one.





Then I updated the schematics to look better and yea



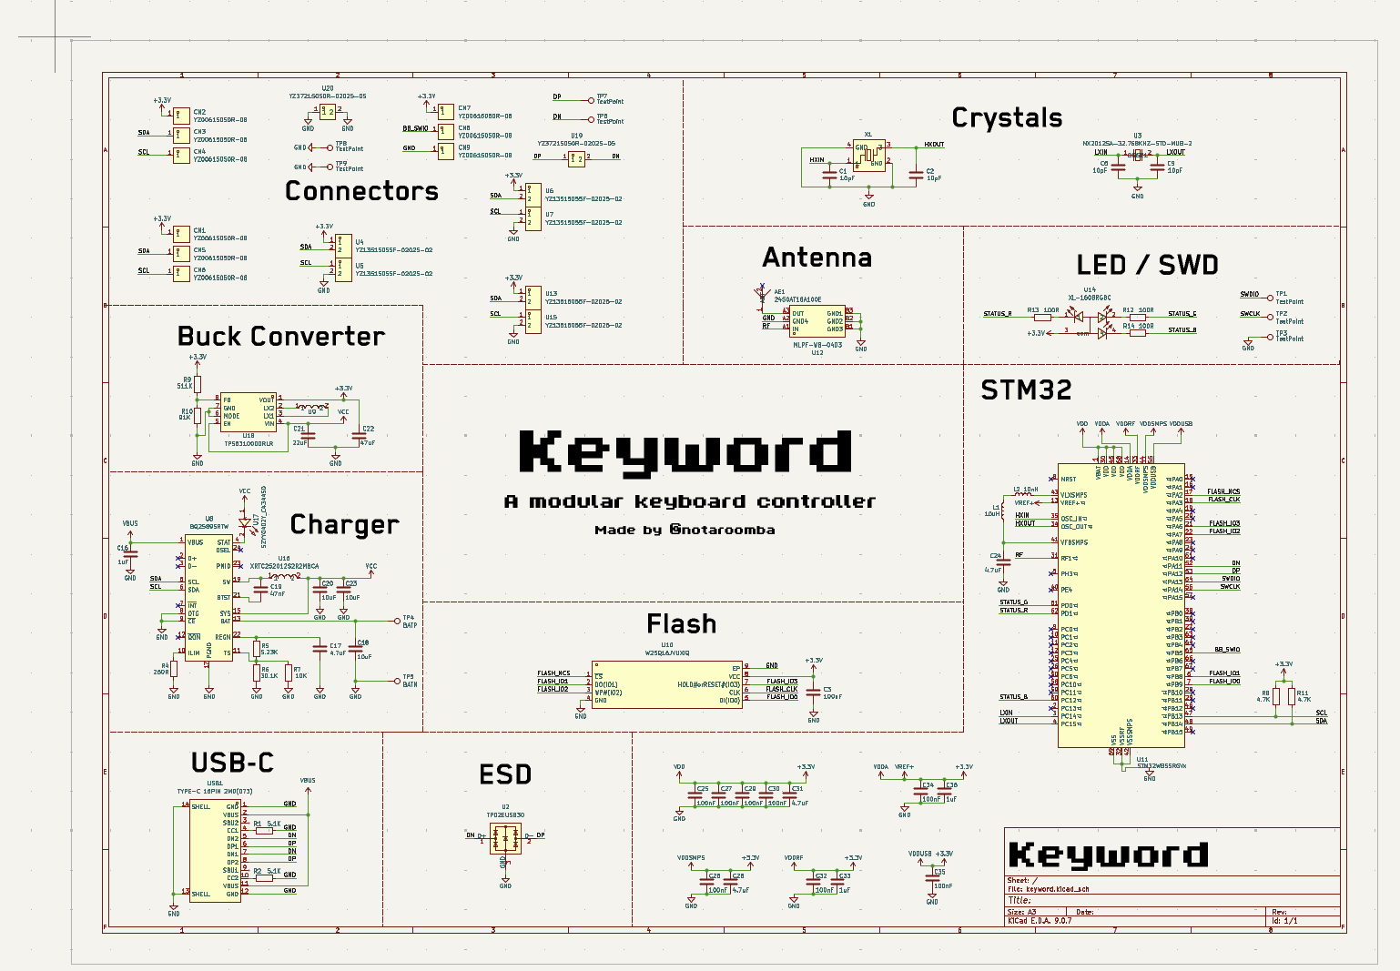
[picture p140: assets/journal/v1/keyword_schematic.png]


# 4/5/2026 7 PM - Routing

_Time spent: 7h_

So I locked in for a day and finished up the routing for both PCB's. I also had to add in some I2C pullup resistors and had fun with laying them out on both sides and yea



I also did the same for the keybit and ended up with this

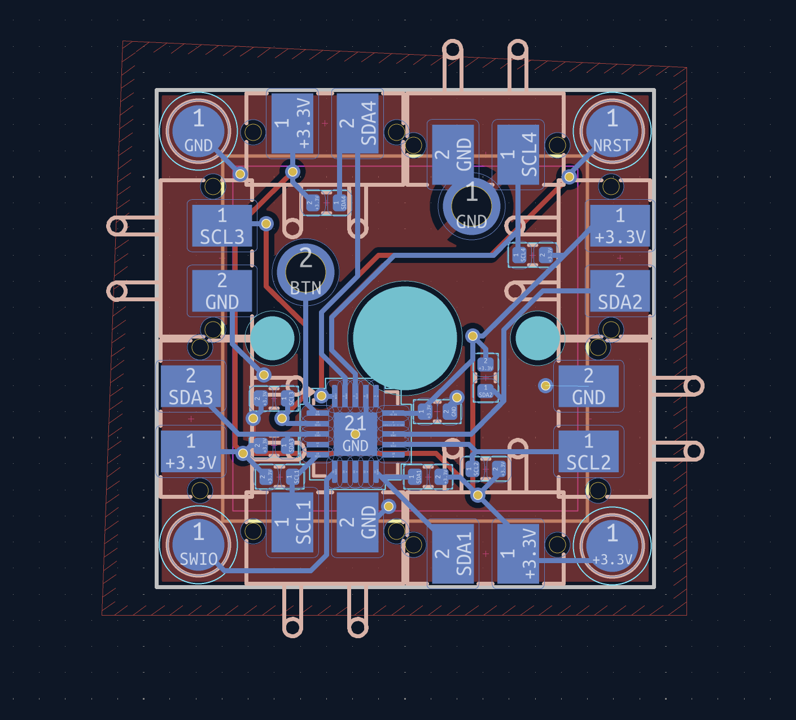
[picture p141: assets/journal/v1/keybit_routing.png]


it took me a while as I forgot that I had to add in pullup resistors and then had to move things around to add space for them

# 4/5/2026 12 AM - Keyword and Routing

_Time spent: 7h_

So I had a bunch of back and forth between the 2 different STM32 chips, I oringlaly planned on having eherythign on one boar dbut with bluetooht then that would be way complicated so I decided to go on St's website to try and find any stm32s that would support bluetooth and I found a small one bue that meant using a usb to hid converter but the smallest one I could find would take up half the board so I decided to split the boards, and in doing so I rediecided that if I was going to have more area, I might as well have a bigger stm32 chip and just add more stuff to it so I did that and ended up with this:



I was still placing the components so I decided to do that some more and got this

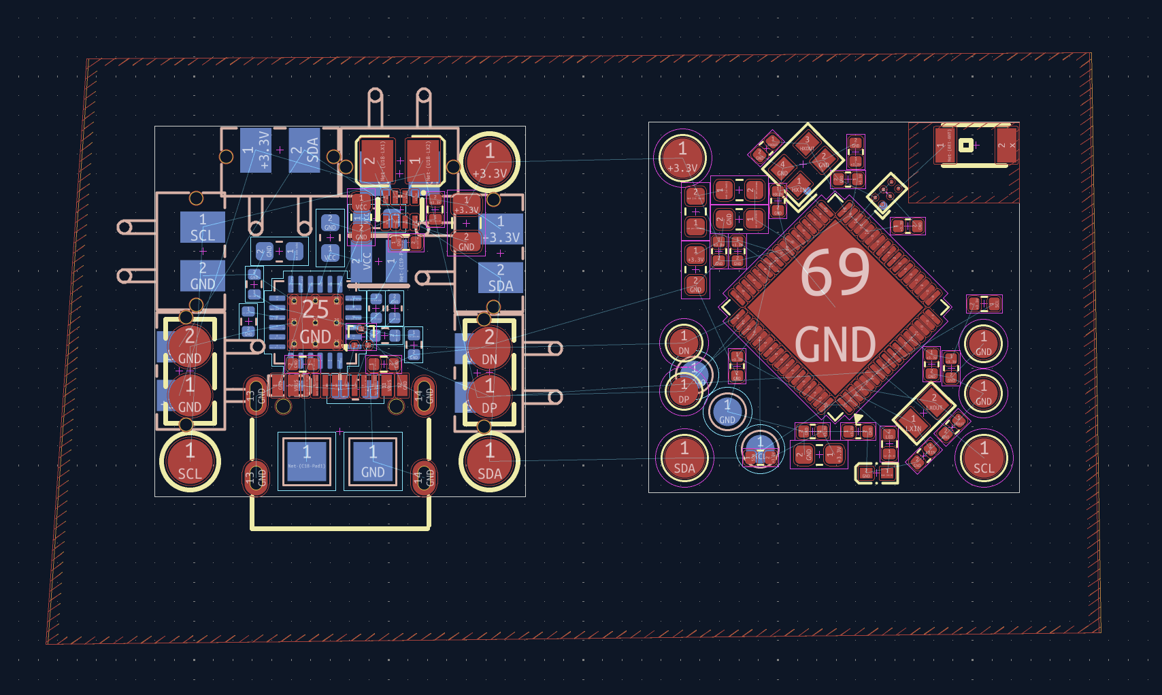
[picture p142: assets/journal/keyword_placement_2.png]


# 3/27/2026 2 AM - Ideation and Schematic

_Time spent: 9h_

So basically Ihad always wanted to make a keyboard but I didnt want to be locked into just one design so I wanna make it so that I can rearrange it at any time.

Yea...

I searched online and couldnt find it anywhere so I decided to make it myself.

I decided on using a cheap risc-v processor and i2c to communicate between the keys and then have a central MCU block that has bluetooth and battery support so yea.

I started on the keybit design (ha ha) and got this:



I then also started on the other design for the keyword

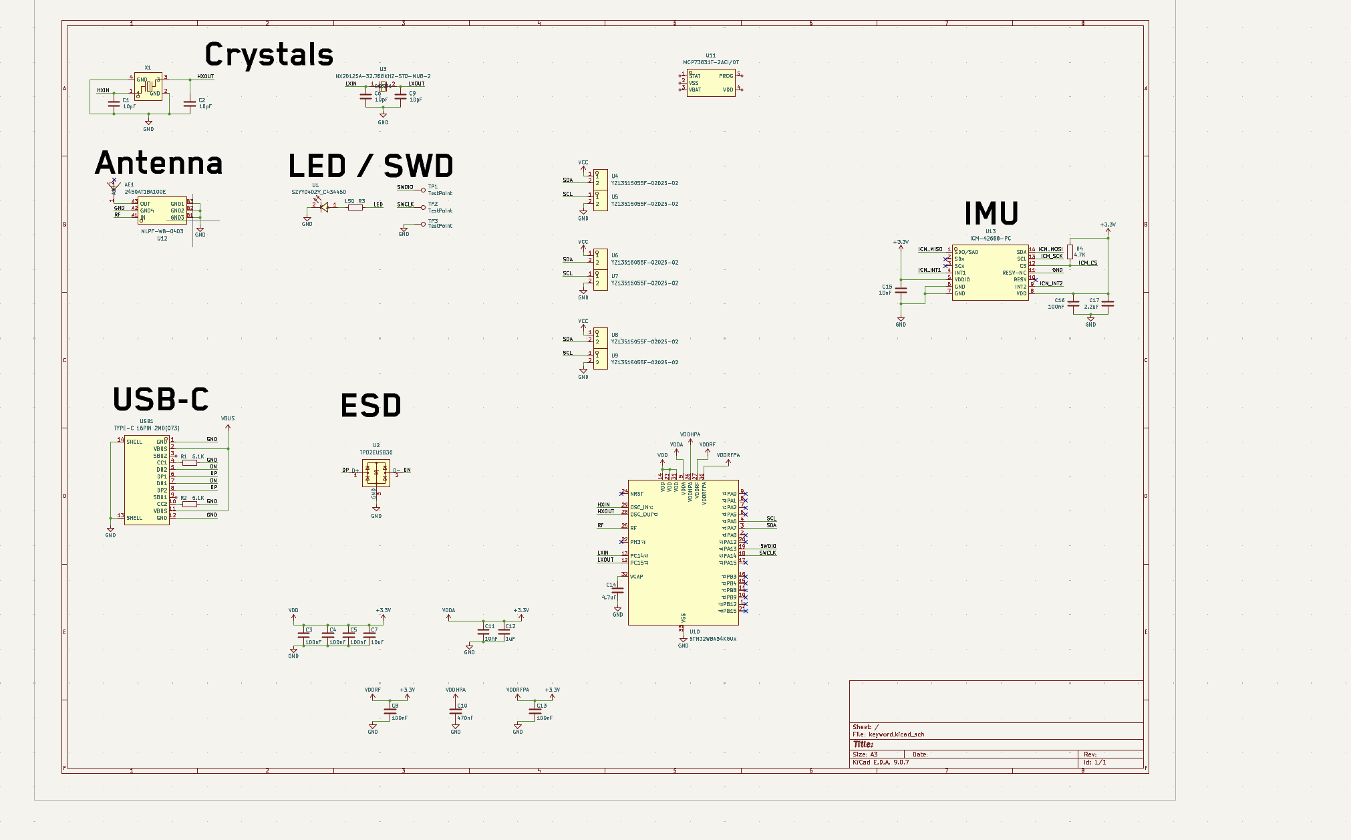
[picture p143: assets/journal/v1/keyword_schematic_v1.png]
