notaroomba/keybytes/assets/journal/1775419082878-wwvq7s.png

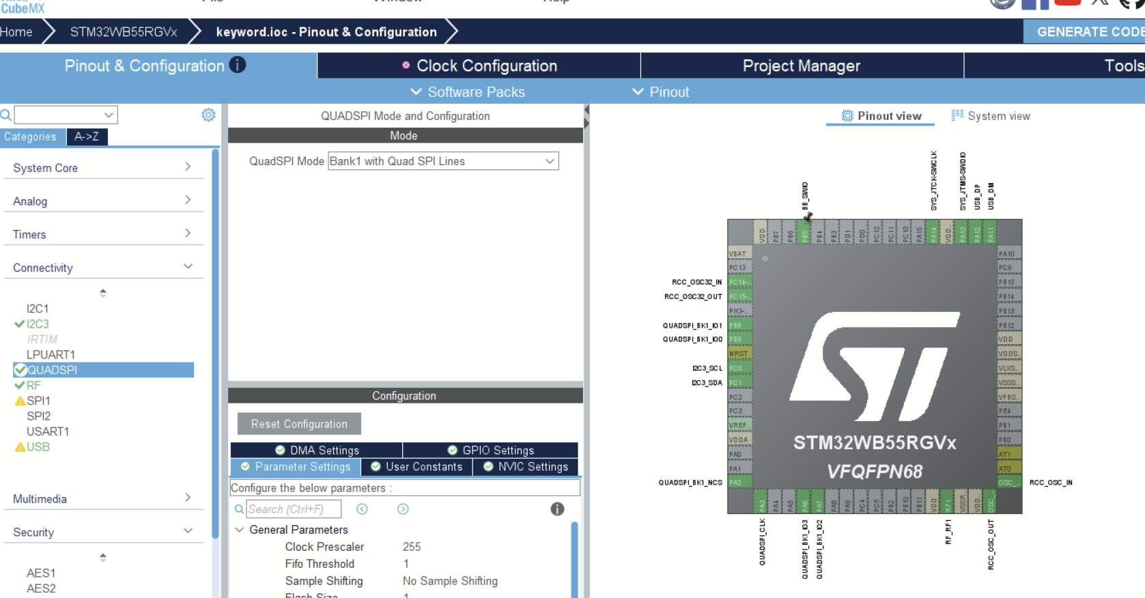
assets/journal/1775419082878-wwvq7s.png
