notaroomba/keybytes/assets/journal/1775426579651-lg5zme.png

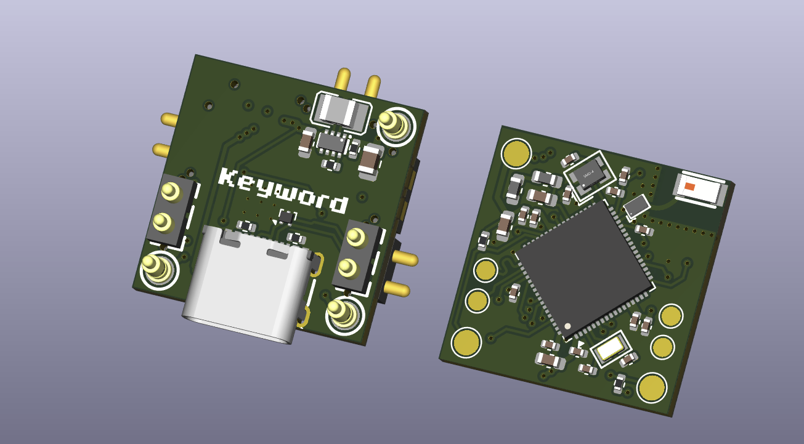
assets/journal/1775426579651-lg5zme.png
