notaroomba/keybytes/assets/journal/1775447209619-5e1ha0.png

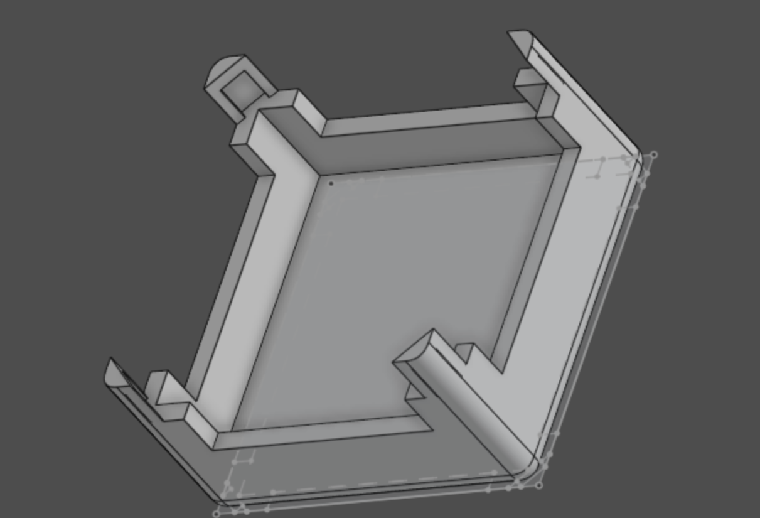
assets/journal/1775447209619-5e1ha0.png
