notaroomba/keybytes/assets/journal/1775792561658-u0t4fh.png

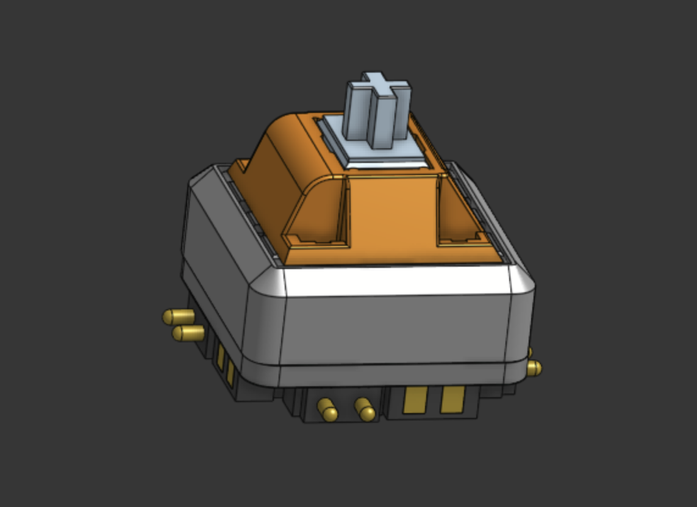
assets/journal/1775792561658-u0t4fh.png
