notaroomba/keybytes/assets/journal/1775793071456-4ktbyd.png

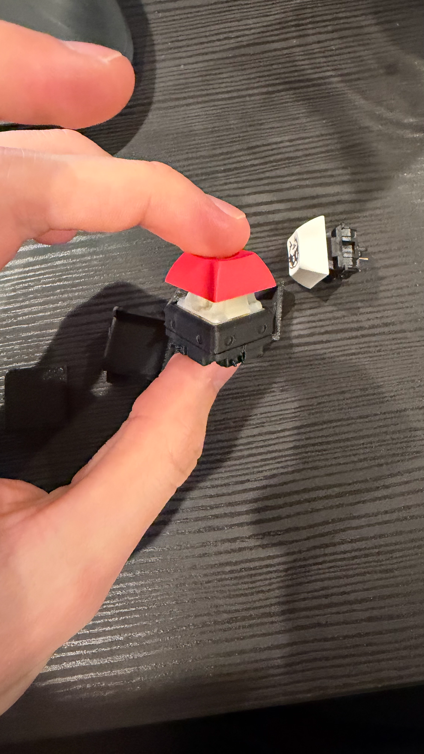
assets/journal/1775793071456-4ktbyd.png
