notaroomba/keybytes/assets/journal/1781815993601-r86dm5.png

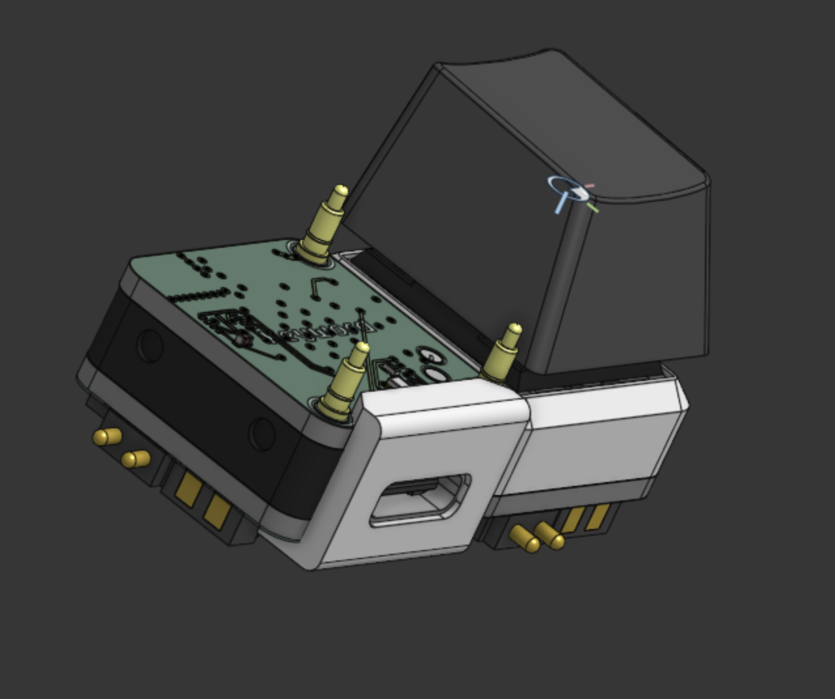
assets/journal/1781815993601-r86dm5.png
