notaroomba/keybytes/assets/journal/v2/keybit_hall_render_angle.png

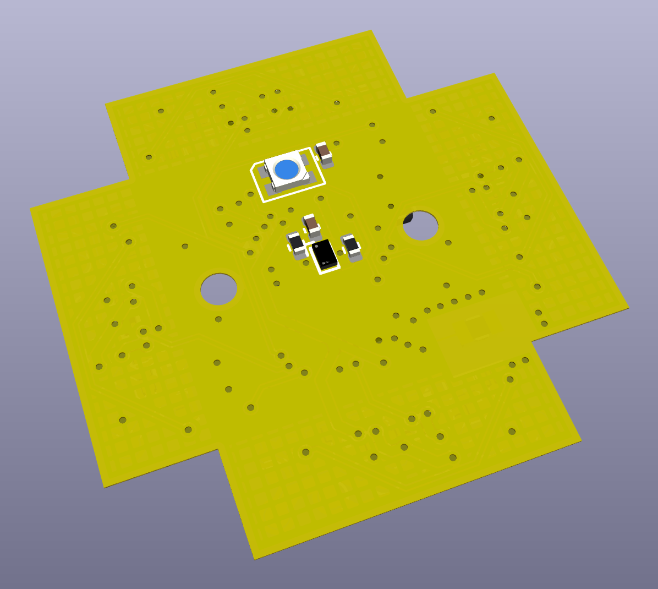
assets/journal/v2/keybit_hall_render_angle.png
