notaroomba/keybytes/hardware/keyword/keyword.kicad_pcb

## KiCad design hardware/keyword/keyword.kicad_pcb (2026-11-13)

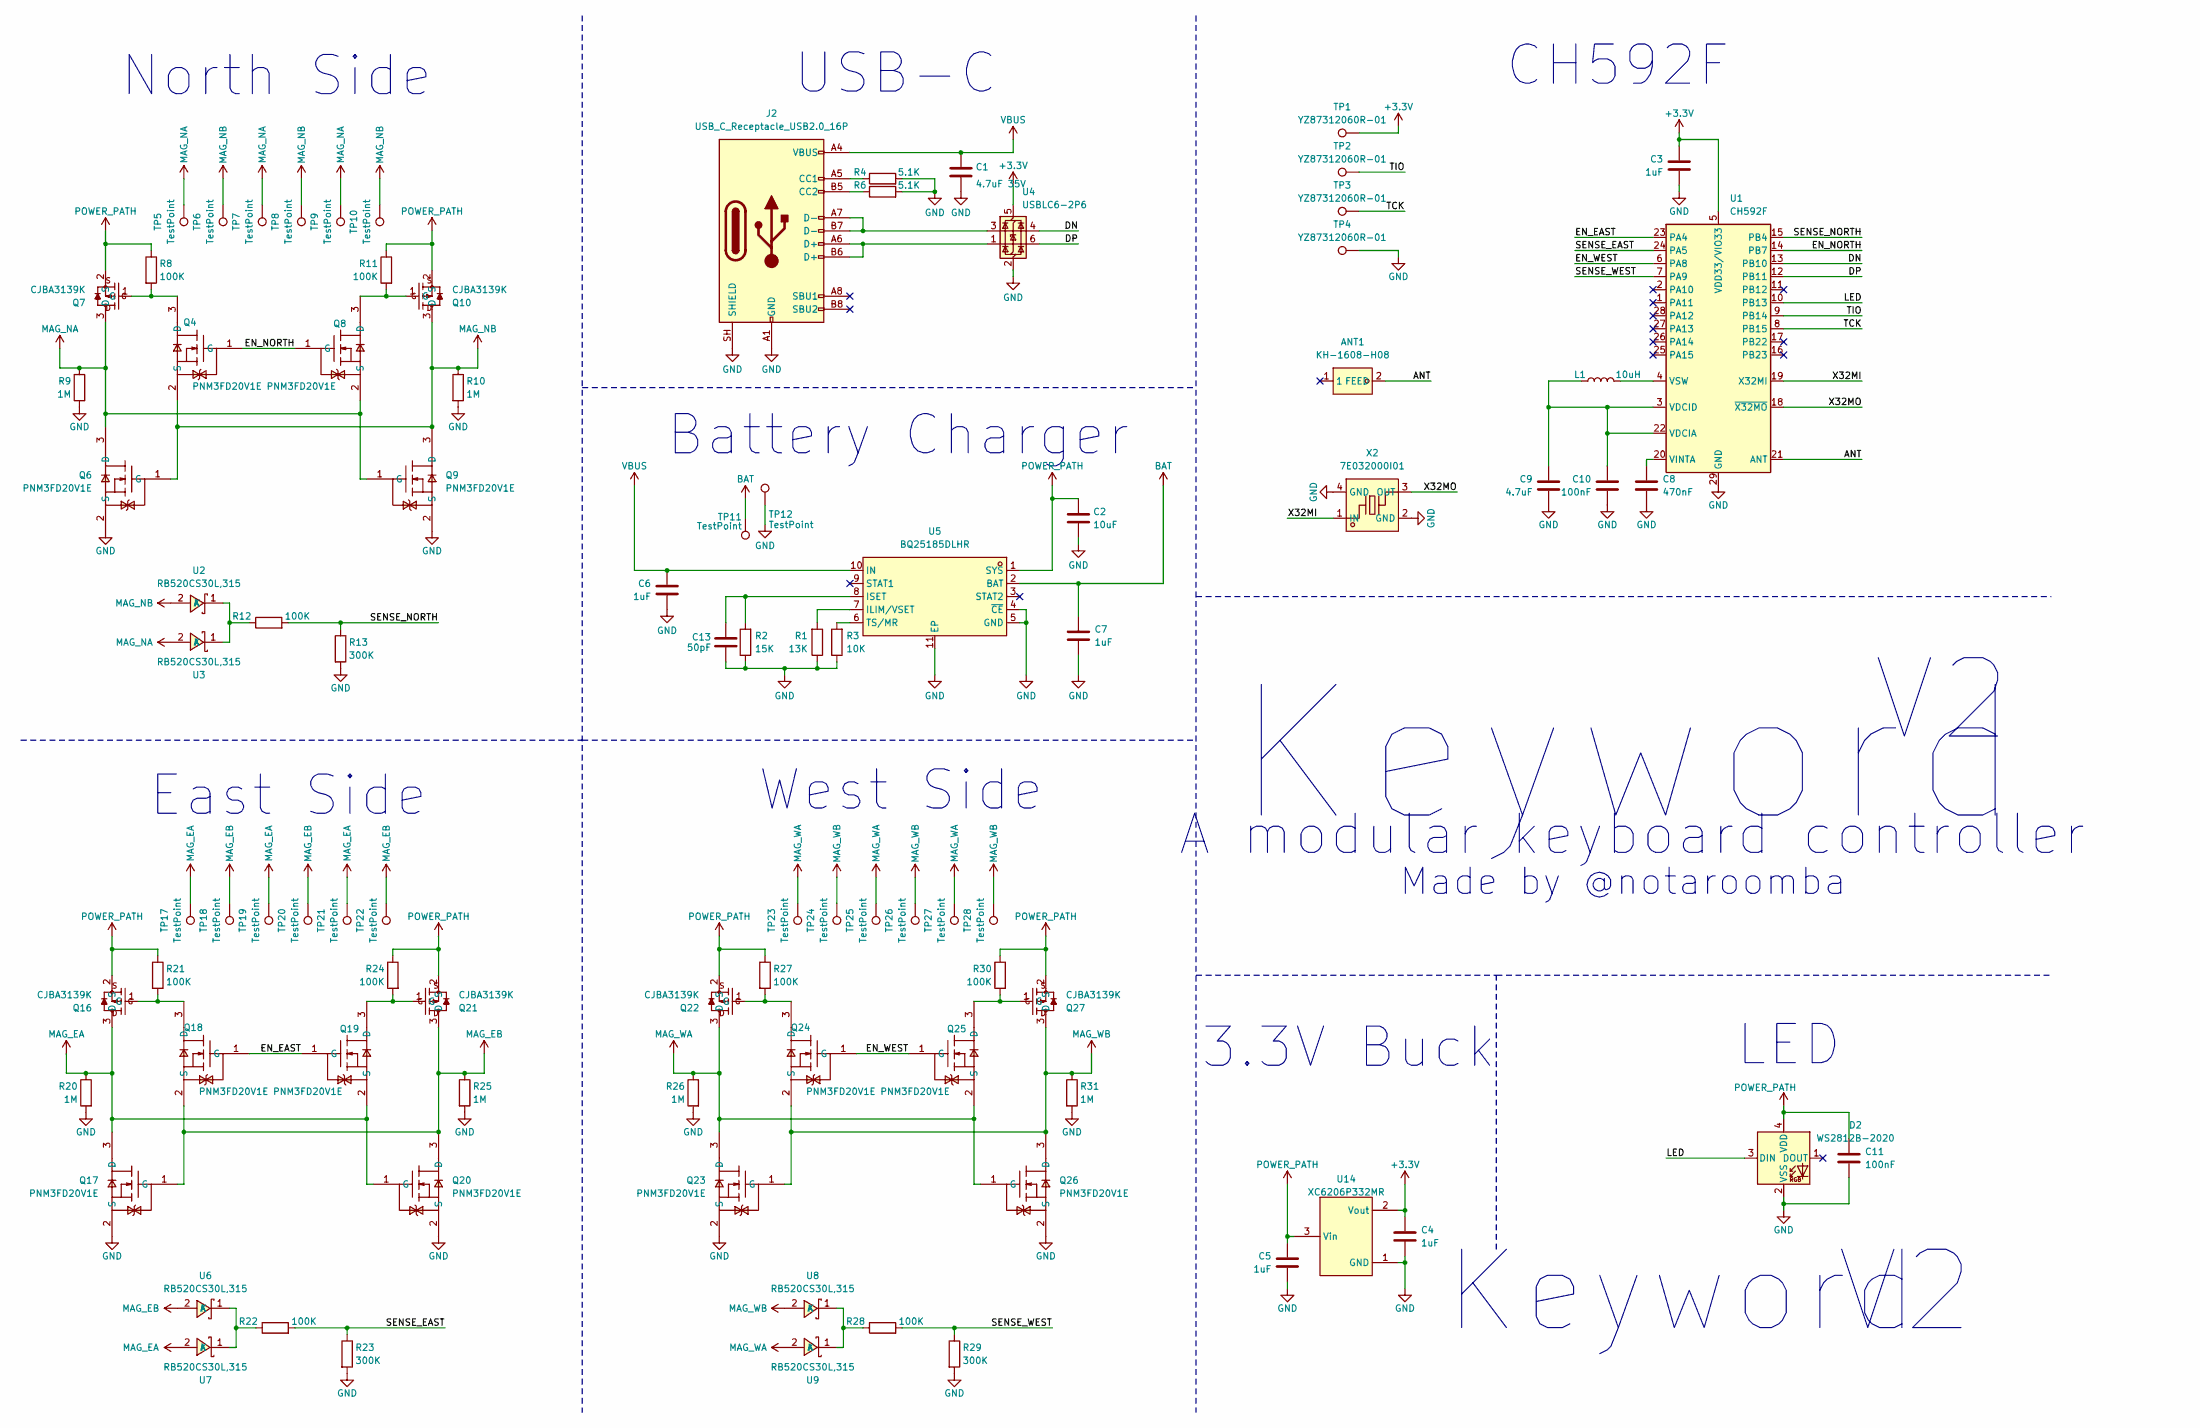
[picture p151: schematic keyword.kicad_sch]

Parts:
ANT1: KH-1608-H08; ANT-SMD_L1.7-W0.9; MPN KH-1608-H08; LCSC Part C2925416
C1: 4.7uF 35V; C_0603_1608Metric; LCSC C307467
C2: 10uF; C_0402_1005Metric; LCSC Part C6119763
C3, C4, C5, C6, C7: 1uF; C_0402_1005Metric; MPN CL05A105KA5NQNC; LCSC Part C52923
C8: 470nF; C_0402_1005Metric; MPN CL05A474KP5NNNC; LCSC Part C47339
C9: 4.7uF; C_0402_1005Metric; MPN CL05A475MP5NRNC; LCSC Part C23733
C10, C11: 100nF; C_0402_1005Metric; MPN CL05B104KO5NNNC; LCSC Part C1525
C13: 50pF; C_0402_1005Metric; LCSC Part C49210433
D2: WS2812B-2020; LED_WS2812B-2020_PLCC4_2.0x2.0mm; MPN WS2812B-2020-V6; LCSC Part C52917434
J2: USB_C_Receptacle_USB2.0_16P; USB_C_Receptacle_HCTL_HC-TYPE-C-16P-01A; LCSC C2894897
L1: 10uH; L_0402_1005Metric; MPN MWI0402IF100KST-HF; LCSC Part C48946156
Q4, Q6, Q8, Q9, Q17, Q18, Q19, Q20, Q23, Q24, Q25, Q26: PNM3FD20V1E; SOT-883-3_L1.0-W0.6-BR; MPN PNM3FD20V1E; LCSC Part C2875806
Q7, Q10, Q16, Q21, Q22, Q27: CJBA3139K; DFN1006-3L_L1.0-W0.6-LS1.0-BR; MPN CJBA3139K; LCSC Part C504099
R1: 13K; R_0402_1005Metric; LCSC Part C49653083
R2: 15K; R_0402_1005Metric; LCSC Part C25756
R3: 10K; R_0402_1005Metric; LCSC Part C25744
R4, R6: 5.1K; R_0402_1005Metric; LCSC Part C25905
R8, R11, R12, R21, R22, R24, R27, R28, R30: 100K; R_0402_1005Metric; MPN 0402WGF1003TCE; LCSC Part C25741
R9, R10, R20, R25, R26, R31: 1M; R_0402_1005Metric; MPN 0402WGF1004TCE; LCSC Part C26083
R13, R23, R29: 300K; R_0402_1005Metric; MPN 0402WGF3003TCE; LCSC Part C25774
TP1, TP2, TP3, TP4: YZ87312060R-01; POGO-SMD_YZ87312060R-01; LCSC Part C5157406
TP5, TP6, TP7, TP8, TP9, TP10, TP17, TP18, TP19, TP20, TP21, TP22, TP23, TP24, TP25, TP26, TP27, TP28: TestPoint; TestPoint_Pad_D1.0mm
TP11, TP12: TestPoint; TestPoint_Pad_1.0x1.0mm
U1: CH592F; WQFN-28-1EP_4x4mm_P0.4mm_EP2.7x2.7mm; MPN CH592F; LCSC Part C39831287
U2, U3, U6, U7, U8, U9: RB520CS30L,315; X1-DFN1006-2_L1.0-W0.6-RD; MPN RB520CS30L,315; LCSC Part C461213
U4: USBLC6-2P6; SOT-666; LCSC Part C53059594
U5: BQ25185DLHR; WSON-10_L2.2-W2.0-P0.40-BL-EP_TI_DLH0010A; MPN BQ25185DLHR; LCSC Part C19725033
U14: XC6206P332MR; SOT-23-3_L2.9-W1.6-P1.90-LS2.8-BR; MPN XC6206P332MR-G; LCSC Part C5446
X2: 7E032000I01; CRYSTAL-SMD_4P-L1.6-W1.2-BL; MPN 7E032000I01; LCSC Part C781732

Connections:
+3.3V: C3.1, C4.1, TP1.1 (1_1), U1.5 (VDD33/VIO33), U4.5 (VBUS), U14.2 (Vout)
/ANT: ANT1.2 (FEED_2), U1.21 (ANT)
/DN: U1.13 (PB10), U4.4 (I/O2)
/DP: U1.12 (PB11), U4.6 (I/O1)
/EN_EAST: Q18.1 (G), Q19.1 (G), U1.23 (PA4)
/EN_NORTH: Q4.1 (G), Q8.1 (G), U1.14 (PB7)
/EN_WEST: Q24.1 (G), Q25.1 (G), U1.6 (PA8)
/LED: D2.3 (DIN), U1.10 (PB13)
/SENSE_EAST: R22.2, R23.1, U1.24 (PA5)
/SENSE_NORTH: R12.2, R13.1, U1.15 (PB4)
/SENSE_WEST: R28.2, R29.1, U1.7 (PA9)
/TCK: TP3.1 (1_1), U1.8 (PB15)
/TIO: TP2.1 (1_1), U1.9 (PB14)
/X32MI: U1.19 (X32MI), X2.1 (IN)
/X32MO: U1.18 (~X32MO), X2.3 (OUT)
BAT: C7.1, TP11.1 (1_1), U5.2 (BAT)
GND: C1.2, C2.2, C3.2, C4.2, C5.2, C6.2, C7.2, C8.2, C9.2, C10.2, C11.2, C13.2, D2.2 (VSS), J2.A1 (GND), J2.A12 (GND), J2.B1 (GND), J2.B12 (GND), J2.SH (SHIELD), Q6.2 (S), Q9.2 (S), Q17.2 (S), Q20.2 (S), Q23.2 (S), Q26.2 (S), R1.1, R2.1, R3.1, R4.2, R6.2, R9.2, R10.2, R13.2, R20.2, R23.2, R25.2, R26.2, R29.2, R31.2, TP4.1 (1_1), TP12.1 (1_1), U1.29 (GND), U4.2 (GND), U5.4 (~CE), U5.5 (GND), U5.11 (EP), U14.1 (GND), X2.2 (GND), X2.4 (GND)
MAG_EA: Q16.3 (D), Q17.3 (D), Q19.2 (S), Q20.1 (G), R20.1, TP17.1 (1_1), TP19.1 (1_1), TP21.1 (1_1), U7.2 (A)
MAG_EB: Q17.1 (G), Q18.2 (S), Q20.3 (D), Q21.3 (D), R25.1, TP18.1 (1_1), TP20.1 (1_1), TP22.1 (1_1), U6.2 (A)
MAG_NA: Q6.3 (D), Q7.3 (D), Q8.2 (S), Q9.1 (G), R9.1, TP5.1 (1_1), TP7.1 (1_1), TP9.1 (1_1), U3.2 (A)
MAG_NB: Q4.2 (S), Q6.1 (G), Q9.3 (D), Q10.3 (D), R10.1, TP6.1 (1_1), TP8.1 (1_1), TP10.1 (1_1), U2.2 (A)
MAG_WA: Q22.3 (D), Q23.3 (D), Q25.2 (S), Q26.1 (G), R26.1, TP23.1 (1_1), TP25.1 (1_1), TP27.1 (1_1), U9.2 (A)
MAG_WB: Q23.1 (G), Q24.2 (S), Q26.3 (D), Q27.3 (D), R31.1, TP24.1 (1_1), TP26.1 (1_1), TP28.1 (1_1), U8.2 (A)
unnamed: J2.A5 (CC1), R4.1
unnamed: J2.B5 (CC2), R6.1
unnamed: J2.A6 (D+), J2.B6 (D+), U4.1 (I/O1)
unnamed: J2.A7 (D-), J2.B7 (D-), U4.3 (I/O2)
unnamed: Q4.3 (D), Q7.1 (G), R8.2
unnamed: Q8.3 (D), Q10.1 (G), R11.2
unnamed: Q16.1 (G), Q18.3 (D), R21.2
unnamed: Q19.3 (D), Q21.1 (G), R24.2
unnamed: Q22.1 (G), Q24.3 (D), R27.2
unnamed: Q25.3 (D), Q27.1 (G), R30.2
unnamed: C9.1, C10.1, L1.1, U1.3 (VDCID), U1.22 (VDCIA)
unnamed: C8.1, U1.20 (VINTA)
unnamed: L1.2, U1.4 (VSW)
unnamed: R12.1, U2.1 (K), U3.1 (K)
unnamed: R1.2, U5.7 (ILIM/VSET)
unnamed: C13.1, R2.2, U5.8 (ISET)
unnamed: R3.2, U5.6 (TS/MR)
unnamed: R22.1, U6.1 (K), U7.1 (K)
unnamed: R28.1, U8.1 (K), U9.1 (K)
POWER_PATH: C2.1, C5.1, C11.1, D2.4 (VDD), Q7.2 (S), Q10.2 (S), Q16.2 (S), Q21.2 (S), Q22.2 (S), Q27.2 (S), R8.1, R11.1, R21.1, R24.1, R27.1, R30.1, U5.1 (SYS), U14.3 (Vin)
VBUS: C1.1, C6.1, J2.A4 (VBUS), J2.A9 (VBUS), J2.B4 (VBUS), J2.B9 (VBUS), U5.10 (IN)

Notes on the sheet:
CH592F
West Side
North Side
Battery Charger
LED
Made by @notaroomba
3.3V Buck
East Side
Keyword
A modular keyboard controller
USB-C

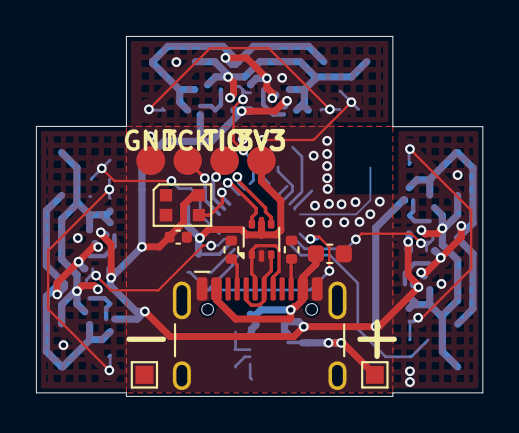
[picture p152: board keyword.kicad_pcb from above]

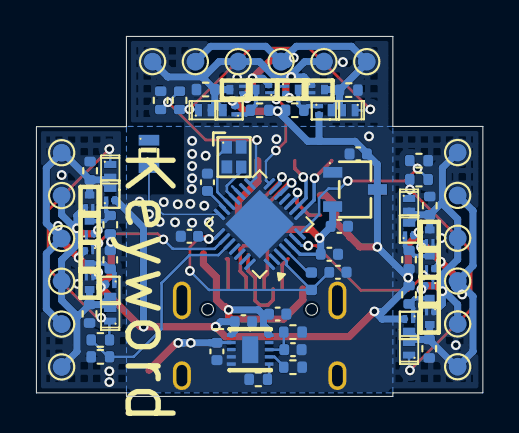
[picture p153: board keyword.kicad_pcb from below]

Board: 2 copper layers, 24.8 x 20.0 mm, 92 parts (79 on the bottom side), 44 nets.
