notaroomba/keybytes/hardware/panels/spacer-panel/src/spacer/spacer-1u.kicad_pcb

## KiCad design hardware/panels/spacer-panel/src/spacer/spacer-1u.kicad_pcb (2026-11-13)

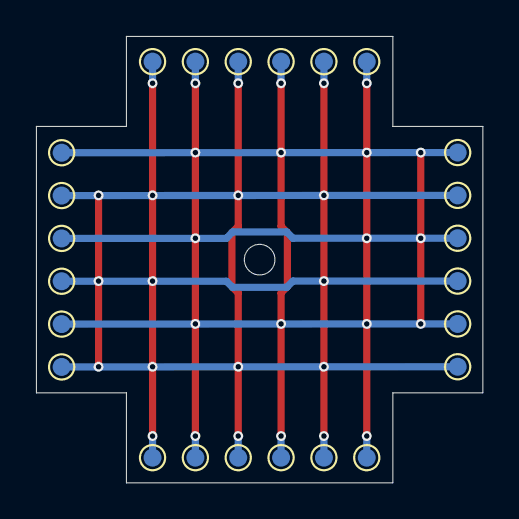
[picture p154: board spacer-1u.kicad_pcb from below]

Board: 2 copper layers, 24.8 x 24.8 mm, 24 parts (24 on the bottom side), 2 nets.

Parts:
TP5, TP6, TP7, TP8, TP9, TP10, TP11, TP12, TP13, TP14, TP15, TP16, TP17, TP18, TP19, TP20, TP21, TP22, TP23, TP24, TP25, TP26, TP27, TP28: TestPoint; TestPoint_Pad_D1.0mm

Connections:
SPX: TP5.1 (1_1), TP7.1 (1_1), TP9.1 (1_1), TP12.1 (1_1), TP14.1 (1_1), TP16.1 (1_1), TP17.1 (1_1), TP19.1 (1_1), TP21.1 (1_1), TP24.1 (1_1), TP26.1 (1_1), TP28.1 (1_1)
SPY: TP6.1 (1_1), TP8.1 (1_1), TP10.1 (1_1), TP11.1 (1_1), TP13.1 (1_1), TP15.1 (1_1), TP18.1 (1_1), TP20.1 (1_1), TP22.1 (1_1), TP23.1 (1_1), TP25.1 (1_1), TP27.1 (1_1)
