notaroomba/keybytes/hardware/spacer/spacer-0.75u.kicad_pcb

## KiCad design hardware/spacer/spacer-0.75u.kicad_pcb (2026-11-13)

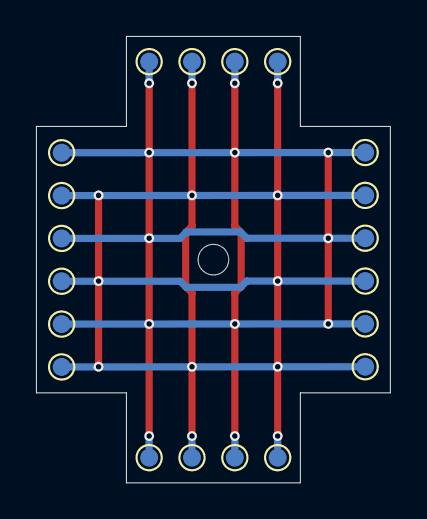
[picture p155: board spacer-0.75u.kicad_pcb from below]

Board: 2 copper layers, 19.7 x 24.8 mm, 20 parts (20 on the bottom side), 2 nets.

Parts:
TP5, TP7, TP8, TP10, TP11, TP13, TP14, TP16, TP17, TP18, TP19, TP20, TP21, TP22, TP23, TP24, TP25, TP26, TP27, TP28: TestPoint; TestPoint_Pad_D1.0mm

Connections:
SPX: TP5.1 (1_1), TP7.1 (1_1), TP14.1 (1_1), TP16.1 (1_1), TP17.1 (1_1), TP19.1 (1_1), TP21.1 (1_1), TP24.1 (1_1), TP26.1 (1_1), TP28.1 (1_1)
SPY: TP8.1 (1_1), TP10.1 (1_1), TP11.1 (1_1), TP13.1 (1_1), TP18.1 (1_1), TP20.1 (1_1), TP22.1 (1_1), TP23.1 (1_1), TP25.1 (1_1), TP27.1 (1_1)
