notaroomba/keybytes/hardware/keyword/keyword_bottom.kicad_pcb

## KiCad design hardware/keyword/keyword_bottom.kicad_pcb (2026-10-02)

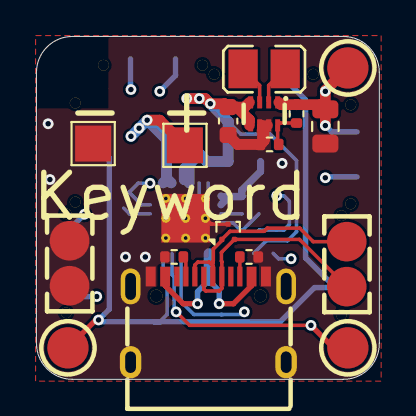
[picture p157: board keyword_bottom.kicad_pcb from above]

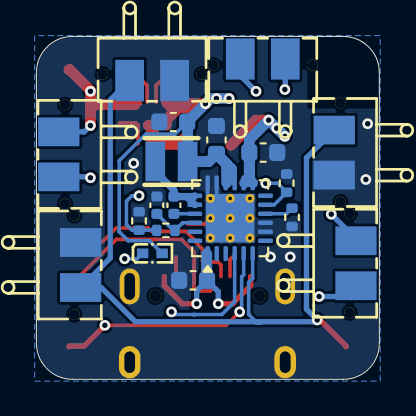
[picture p158: board keyword_bottom.kicad_pcb from below]

Board: 4 copper layers, 19.1 x 19.0 mm, 36 parts (19 on the bottom side), 20 nets.

Parts:
C16: 1uF; C_0603_1608Metric
C17: 4.7uF; C_0402_1005Metric
C18, C20, C23: 10uF; C_0603_1608Metric
C19: 47nF; C_0402_1005Metric
C21: 22uF; C_0603_1608Metric
C22: 47uF; C_0805_2012Metric
CN2, CN3, CN4: YZ00615050R-08; TESTPOINT-SMD_BD2.0-H5.0
R1, R2: 5.1K; R_0402_1005Metric
R4: 260R; R_0402_1005Metric
R5: 5.23K; R_0402_1005Metric
R6: 30.1K; R_0402_1005Metric
R7: 10K; R_0402_1005Metric
R9: 511K; R_0402_1005Metric
R10: 91K; R_0402_1005Metric
TP4: BATP; TestPoint_Pad_2.0x2.0mm
TP5: BATN; TestPoint_Pad_2.0x2.0mm
U2: TPD2EUSB30; Texas_DRT-3
U4, U5, U6, U7, U13, U15: YZ13515055F-02025-02; CONN-SMD_YZ13515055F-02025-02
U8: BQ25895RTW; Texas_RTW_WQFN-24-1EP_4x4mm_P0.5mm_EP2.7x2.7mm_ThermalVias
U9: DFE252012P-1R0M=P2; L1008
U16: XRTC252012S2R2MBCA; IND-SMD_L2.5-W2.0-B
U17: SZYY0402Y_C434450; LED0402-FD_YELLOW
U18: TPS631000DRLR; SOT-583-8_L2.1-W1.2-P0.50-LS1.6-BL
U19, U20: YZ37215050R-02025-05; SMD_2P_YZ37215050R-02025-05
USB1: TYPE-C 16PIN 2MD(073); USB-C-SMD_TYPE-C-6PIN-2MD-073

Connections:
+3.3V: C22.1, CN2.1, R9.2, U4.1, U6.1, U13.1, U18.1 (VOUT)
/DN: U2.1 (D+), U19.2, USB1.5 (DN2), USB1.7 (DN1)
/DP: U2.2 (D-), U19.1, USB1.6 (DP1), USB1.8 (DP2)
/SCL: CN4.1, U5.1, U7.1, U8.6 (SDA), U15.1
/SDA: CN3.1, U4.2, U6.2, U8.5 (SCL), U13.2
GND: C16.2, C17.2, C18.2, C20.2, C21.2, C22.2, C23.2, R1.2, R2.2, R4.2, R6.2, R7.2, R10.1, TP5.1, U2.3 (GND), U5.2, U7.2, U8.8 (OTG), U8.9 (~CE), U8.17 (PGND), U8.18 (PGND), U8.25 (PGND), U15.2, U18.6 (MODE), U18.7 (GND), U20.1, U20.2, USB1.1 (GND), USB1.12 (GND), USB1.13 (SHELL), USB1.14 (SHELL)
unnamed: C18.1, TP4.1, U8.13 (BAT), U8.14 (BAT)
unnamed: C19.1, U8.19 (SW), U8.20 (SW), U16.1
unnamed: C19.2, U8.21 (BTST)
unnamed: R4.1, U8.10 (ILIM)
unnamed: C17.1, R5.1, U8.22 (REGN)
unnamed: R5.2, R6.1, R7.1, U8.11 (TS)
unnamed: U8.4 (STAT), U17.2 (K)
unnamed: R9.1, R10.2, U18.8 (FB)
unnamed: U9.2, U18.3 (LX1)
unnamed: U9.1, U18.2 (LX2)
unnamed: R1.1, USB1.4 (CC1)
unnamed: R2.1, USB1.10 (CC2)
VBUS: C16.1, U8.1 (VBUS), USB1.2 (VBUS), USB1.11 (VBUS)
VCC: C20.1, C21.1, C23.1, U8.15 (SYS), U8.16 (SYS), U16.2, U17.1 (A), U18.4 (VIN), U18.5 (EN)
