notaroomba/keybytes/hardware/keyword/keyword_top.kicad_pcb

## KiCad design hardware/keyword/keyword_top.kicad_pcb (2026-06-03)

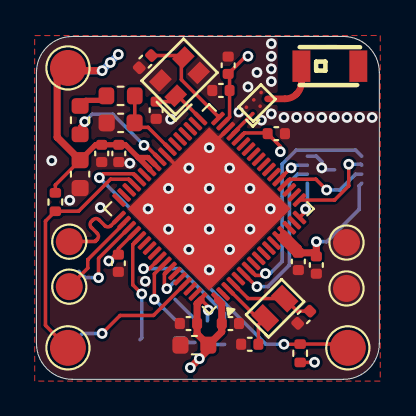
[picture p159: board keyword_top.kicad_pcb from above]

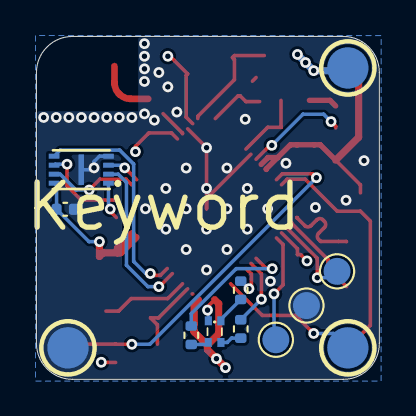
[picture p160: board keyword_top.kicad_pcb from below]

Board: 4 copper layers, 19.1 x 19.0 mm, 45 parts (12 on the bottom side), 30 nets.

Parts:
AE1: 2450AT18A100E; ANT-SMD_L3.2-W1.6
C1, C2, C6, C9: 10pF; C_0402_1005Metric
C3, C25, C26, C27, C29, C30, C32, C34, C35: 100nF; C_0402_1005Metric
C24, C28, C31: 4.7uF; C_0603_1608Metric
C33, C36: 1uF; C_0402_1005Metric
CN1, CN5, CN6: YZ00615050R-08; TestPoint_Pad_D2.0mm
CN7, CN8, CN9: YZ00615050R-08; TESTPOINT-SMD_BD2.0-H5.0
L1: 10uH; L_0603_1608Metric
L2: 10nH; L_0603_1608Metric
R8, R11: 4.7K; R_0402_1005Metric
R12, R13, R14: 100R; R_0402_1005Metric
TP1, TP2, TP3, TP6, TP7, TP8, TP9: TestPoint; TestPoint_Pad_D1.5mm
U3: NX2012SA-32.768KHZ-STD-MUB-2; CRYSTAL-SMD_L2.0-W1.2
U10: W25Q16JVUXIQ; USON-8_L3.0-W2.0-P0.50-BL-EP
U11: STM32WB55RGVx; QFN-68-1EP_8x8mm_P0.4mm_EP6.4x6.4mm
U12: MLPF-WB-04D3; CSPG-6_L1.6-W1.0-P0.50-TL_MLPF-WB-04D3
U14: XL-1608RGBC; LED-SMD_4P-L1.6-W0.8-BL
X1: NX2016SA-32MHZ-STD-CZS-5; OSC-SMD_4P-L2.0-W1.6-BL

Connections:
+3.3V: C3.1, C25.1, C26.1, C27.1, C28.1, C29.1, C30.1, C31.1, C32.1, C33.1, C34.1, C35.1, C36.1, CN1.1, CN7.1, R8.2, R11.2, U10.8 (VCC), U11.1 (VBAT), U11.13 (VREF+), U11.14 (VDDA), U11.30 (VDD), U11.33 (VDDRF), U11.44 (VDDSMPS), U11.45 (VDD), U11.55 (VDDUSB), U11.68 (VDD), U14.3 (com)
/BB_SWIO: CN8.1, U11.65 (PB5)
/DN: TP6.1, U11.52 (PA11)
/DP: TP7.1, U11.53 (PA12)
/FLASH_CLK: U10.6 (CLK), U11.18 (PA3)
/FLASH_IO0: U10.5 (DI(IO0)), U11.7 (PB9)
/FLASH_IO1: U10.2 (DO(IO1)), U11.6 (PB8)
/FLASH_IO2: U10.3 (WP#(IO2)), U11.22 (PA7)
/FLASH_IO3: U10.7 (HOLD#orRESET#(IO3)), U11.21 (PA6)
/FLASH_NCS: U10.1 (~CS), U11.17 (PA2)
/HXIN: C1.1, U11.35 (OSC_IN), X1.1
/HXOUT: C2.1, U11.34 (OSC_OUT), X1.3
/LXIN: C6.1, U3.1 (OSC1), U11.3 (PC14)
/LXOUT: C9.1, U3.2 (OSC2), U11.4 (PC15)
/RF: U11.31 (RF1), U12.A1 (IN)
/SCL: CN6.1, R8.1, U11.47 (PB13)
/SDA: CN5.1, R11.1, U11.48 (PB14)
/STATUS_B: R14.2, U11.60 (PC12)
/STATUS_G: R12.2, U11.61 (PD0)
/STATUS_R: R13.1, U11.62 (PD1)
/SWCLK: TP2.1, U11.56 (PA14)
/SWDIO: TP1.1, U11.54 (PA13)
GND: C1.2, C2.2, C3.2, C6.2, C9.2, C24.2, C25.2, C26.2, C27.2, C28.2, C29.2, C30.2, C31.2, C32.2, C33.2, C34.2, C35.2, C36.2, CN9.1, TP3.1, TP8.1, TP9.1, U10.4 (GND), U10.9 (EP), U11.32 (VSSRF), U11.42 (VSSSMPS), U11.69 (VSS), U12.A2 (GND4), U12.B1 (GND3), U12.B2 (GND2), U12.B3 (GND1), X1.2 (GND), X1.4 (GND)
unnamed: AE1.1 (ANT), U12.A3 (OUT)
unnamed: L1.1, L2.2
unnamed: R12.1, U14.2
unnamed: R13.2, U14.1
unnamed: R14.1, U14.4
unnamed: C24.1, L1.2, U11.41 (VFBSMPS)
unnamed: L2.1, U11.43 (VLXSMPS)
