notaroomba/keybytes/firmware/keyword/keyword.ioc

Mcu.UserName=STM32WB55RGVx
PA11.Signal=USB_DM
PA12.Signal=USB_DP
PA13.Signal=SYS_JTMS-SWDIO
PA14.Signal=SYS_JTCK-SWCLK
PA2.Signal=QUADSPI_BK1_NCS
PA3.Signal=QUADSPI_CLK
PA6.Signal=QUADSPI_BK1_IO3
PA7.Signal=QUADSPI_BK1_IO2
PB13.Signal=I2C3_SCL
PB14.Signal=I2C3_SDA
PB5.GPIO_Label=BB_SWIO
PB5.Signal=GPIO_Output
PB8.Signal=QUADSPI_BK1_IO1
PB9.Signal=QUADSPI_BK1_IO0
PC12.GPIO_Label=STATUS_B
PC12.Signal=GPIO_Output
PC14-OSC32_IN.Signal=RCC_OSC32_IN
PC15-OSC32_OUT.Signal=RCC_OSC32_OUT
PD0.GPIO_Label=STATUS_G
PD0.Signal=GPIO_Output
PD1.GPIO_Label=STATUS_R
PD1.Signal=GPIO_Output
