notaroomba/keybytes/firmware/keyword/Core/Src/main.c

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
/* Includes ------------------------------------------------------------------*/
#include "main.h"

/* USER CODE BEGIN Includes */
#include <stdio.h>
#include <string.h>
#include "app_entry.h"
#include "usb_device.h"
#include "ch32v003_swio.h"
#include "keybit_image.h"
#include "keybit_bus.h"
#include "keymap.h"
#include "proto.h"

/* USER CODE END Includes */

/* USER CODE BEGIN PD */
/* U14 (XL-1608RGBC) is common anode to +3.3V, so a pin driven LOW lights its colour. */
#define LED_STEP_MS 500
#define GREEN_BLINK_MS 150   /* 3 green blinks, this long on and off, once a Keybit is flashed */
#define KEYBIT_POLL_MS 250
#define HALT_TRIES_MAX 60      /* dock polls (250 ms) with a failed halt before giving up */

/* USER CODE END PD */

I2C_HandleTypeDef hi2c3;

QSPI_HandleTypeDef hqspi;

PCD_HandleTypeDef hpcd_USB_FS;

/* USER CODE BEGIN PV */
static ch32_swio_t keybit_swio;
uint32_t keybit_dock_pause_until;
uint32_t keyword_reset_csr;   /* HAL tick; the dock poll stays off the line until then */
/* Keybits touching the keyword's sides: the list is rebuilt every
 * ~500 ms and key_down refreshed every 15 ms (keybit_bus_service). keybit_changed
 * collects bits of entries whose key_down changed; whoever consumes key
 * events clears the bits it has handled. */
keybit_info_t keybits[KEYBIT_MAX];
int keybit_count;
volatile uint32_t keybit_changed;
/* Keybits further out, from events relayed by their neighbours. */
keybit_remote_t keybit_remotes[KEYBIT_REMOTE_MAX];
int keybit_remote_count;

/* USER CODE END PV */

void SystemClock_Config(void);
void PeriphCommonClock_Config(void);
static void MX_GPIO_Init(void);
static void MX_I2C3_Init(void);
static void MX_USB_PCD_Init(void);
static void MX_QUADSPI_Init(void);
static void MX_RF_Init(void);
/* USER CODE BEGIN PFP */
static void LED_Set(uint8_t r, uint8_t g, uint8_t b);

/* USER CODE END PFP */

/* USER CODE BEGIN 0 */
static void LED_Set(uint8_t r, uint8_t g, uint8_t b)
{
  HAL_GPIO_WritePin(STATUS_R_GPIO_Port, STATUS_R_Pin, r ? GPIO_PIN_RESET : GPIO_PIN_SET);
  HAL_GPIO_WritePin(STATUS_G_GPIO_Port, STATUS_G_Pin, g ? GPIO_PIN_RESET : GPIO_PIN_SET);
  HAL_GPIO_WritePin(STATUS_B_GPIO_Port, STATUS_B_Pin, b ? GPIO_PIN_RESET : GPIO_PIN_SET);
}

/* Status LED, highest priority first:
 *   red    Keybit on the dock failed to flash (until it's taken off)
 *   red    blinking: SDA held low, a Keybit is on backwards (bus paused)
 *   red    double blink: a Keybit reports a neighbour on backwards
 *   white  blinking: a Keybit just connected, on a side or chained
 *   blue   Keybit on the dock (flashing); green once it's done
 *   white  idle */
/* Dock: EMPTY until something answers, WORKING while flashing (blue), then
 * DONE (green) or FAILED (red, gave up) until that board is taken off. */
enum { DOCK_EMPTY, DOCK_WORKING, DOCK_DONE, DOCK_FAILED };
static uint8_t dock_state, bus_held;
static uint32_t white_until;
static uint32_t green_until;   /* green blink after a Keybit is flashed or found up to date */

#define WHITE_BLINK_MS 1200
#define BUS_HELD_MS 100

/* Any Keybit, touching us or further out, with a neighbour on backwards. */
static int Keybit_Any_Backwards(void)
{
  for (int i = 0; i < keybit_count; i++) if (keybits[i].backwards) return 1;
  for (int i = 0; i < keybit_remote_count; i++) if (keybit_remotes[i].present && keybit_remotes[i].backwards) return 1;
  return 0;
}

static void LED_Update(void)
{
  uint32_t now = HAL_GetTick();
  uint32_t t = now % 1000;
  if (dock_state == DOCK_FAILED) LED_Set(1, 0, 0);
  else if ((int32_t)(green_until - now) > 0) LED_Set(0, ((green_until - now) / GREEN_BLINK_MS) & 1, 0);
  else if (bus_held) LED_Set(((now / 250) & 1) == 0, 0, 0);
  else if (Keybit_Any_Backwards()) LED_Set(t < 100 || (t >= 200 && t < 300), 0, 0);  /* two 100 ms blinks a second */
  else if ((int32_t)(white_until - now) > 0) {
    uint8_t on = ((now / 100) & 1) == 0;
    LED_Set(on, on, on);
  }
  else if (dock_state == DOCK_DONE) LED_Set(0, 1, 0);
  else if (dock_state == DOCK_WORKING) LED_Set(0, 0, 1);
  else LED_Set(1, 1, 1);
}

/* Keybit programming dock: CN7/CN8/CN9 on the keyword's back are 3V3, SWIO
 * and GND, lined up with a Keybit's TP1/TP2/TP4. Poll for a Keybit there
 * and flash keybit_image onto it. Until one has been flashed (or found up
 * to date) it keeps retrying every poll, even after a failed attempt, and
 * reports every attempt that got any answer over serial as DOCK lines. */
/* Halt whatever is on the dock and read its 96-bit UID, trusting it only
 * when two reads agree. */
static ch32_status_t Keybit_Dock_Uid(uint32_t uid[3])
{
  ch32_status_t r = ch32_halt(&keybit_swio, 0);
  if (r != CH32_OK && ch32_detect(&keybit_swio) == CH32_OK) r = ch32_halt(&keybit_swio, 0);
  if (r != CH32_OK) return r;
  for (int t = 0; t < 3; t++) {
    int ok = 1;
    for (int i = 0; i < 3 && ok; i++) {
      uint32_t again = 0;
      ok = ch32_read_word(&keybit_swio, 0x1FFFF7E8u + 4u * i, &uid[i]) == CH32_OK &&
           ch32_read_word(&keybit_swio, 0x1FFFF7E8u + 4u * i, &again) == CH32_OK && uid[i] == again;
    }
    /* All 1s or all 0s is a line nobody is driving, not a UID. */
    if (ok && !(uid[0] == uid[1] && uid[1] == uid[2] && (uid[0] == 0 || uid[0] == 0xFFFFFFFFu))) return CH32_OK;
  }
  return CH32_ERR_VERIFY;
}

/* One flash attempt on the docked board: done if it verifies or programs,
 * failed once 5 attempts in a row get nowhere. */
static int32_t best_blk;   /* furthest block the current board's attempts got to */
static uint32_t next_blk;  /* where flashing the current board carries on */
static uint8_t checked;    /* the current board's whole image has been checked once */
static uint8_t stalls;     /* attempts in a row that got no further than where they started */

/* Boards flashed or found up to date since boot; the image is fixed per
 * build, so one of these coming back doesn't need checking again. */
static uint32_t done_uids[8][3];
static uint8_t done_count, done_next;

static void Keybit_Dock_Done(const uint32_t uid[3])
{
  dock_state = DOCK_DONE;
  stalls = 0;
  green_until = HAL_GetTick() + 6 * GREEN_BLINK_MS;
  for (int i = 0; i < done_count; i++)
    if (memcmp(done_uids[i], uid, 12) == 0) return;
  memcpy(done_uids[done_next], uid, 12);
  done_next = (done_next + 1) % 8;
  if (done_count < 8) done_count++;
}

static void Keybit_Dock_Start(const uint32_t uid[3])
{
  for (int i = 0; i < done_count; i++)
    if (memcmp(done_uids[i], uid, 12) == 0) {
      ch32_reboot(&keybit_swio);  /* it was halted for the UID read */
      Keybit_Dock_Done(uid);
      PROTO_Send("DOCK up to date (seen)");
      return;
    }
  dock_state = DOCK_WORKING;
  best_blk = -1;
  next_blk = 0;
  checked = 0;
  stalls = 0;
  LED_Update();    /* blue while flashing */
}

static void Keybit_Dock_Attempt(const uint32_t uid[3])
{
  static uint8_t blank_polls;
  if (dock_state != DOCK_WORKING) return;

  /* No reset: with the Keybit firmware running, a reset-halt loses the line.
   * If the halt fails anyway, detect again and give it one more go. */
  ch32_status_t h = ch32_halt(&keybit_swio, 0);
  if (h != CH32_OK && ch32_detect(&keybit_swio) == CH32_OK) h = ch32_halt(&keybit_swio, 0);
  /* The halt fails in runs and then goes through, so a failed one isn't a
   * stuck attempt: just try again next poll, and only give up after
   * HALT_TRIES_MAX of them in a row (~15 s). */
  static uint8_t halt_fails;
  if (h != CH32_OK) {
    if (++halt_fails >= HALT_TRIES_MAX) {
      halt_fails = 0;
      dock_state = DOCK_FAILED;
      PROTO_Send("DOCK failed: halt=%d", h);
    }
    return;
  }
  halt_fails = 0;
  /* The first words all reading blank is more likely a board that isn't
   * seated yet than an erased one, so give it about a second before
   * believing it (an attempt that died after erasing block 0 does leave it blank). */
  if (h == CH32_OK) {
    uint32_t w = 0;
    int blank = 1;
    for (int i = 0; i < 4 && blank; i++)
      blank = ch32_read_word(&keybit_swio, CH32_FLASH_BASE + 4u * i, &w) == CH32_OK && w == 0xFFFFFFFFu;
    if (blank && ++blank_polls < 4) return;
  }
  blank_polls = 0;
  /* Check the whole image once per docking; after that, carry straight on. */
  int resuming = h == CH32_OK && checked;
  ch32_status_t v = resuming ? CH32_ERR_VERIFY
                  : h == CH32_OK ? ch32_verify(&keybit_swio, CH32_FLASH_BASE, keybit_image, keybit_image_len) : h;
  /* Only a real mismatch means it needs flashing; a garbled read just gets checked again. */
  for (int i = 0; i < 3 && h == CH32_OK && v != CH32_OK && v != CH32_ERR_VERIFY; i++)
    v = ch32_verify(&keybit_swio, CH32_FLASH_BASE, keybit_image, keybit_image_len);
  /* A mismatch has to show up twice before it's worth a reflash. */
  if (v == CH32_ERR_VERIFY && !resuming) {
    PROTO_Send("DOCK mismatch at %08lx want %08lx got %08lx", (unsigned long)ch32_bad_addr,
               (unsigned long)ch32_bad_want, (unsigned long)ch32_bad_got);
    v = ch32_verify(&keybit_swio, CH32_FLASH_BASE, keybit_image, keybit_image_len);
  }
  if (v == CH32_OK) {
    ch32_reboot(&keybit_swio);
    Keybit_Dock_Done(uid);
    PROTO_Send("DOCK up to date");
    return;
  }
  if (h == CH32_OK && !checked && v == CH32_ERR_VERIFY) {
    /* Everything before the first mismatch already matches. */
    checked = 1;
    next_blk = (ch32_bad_addr - CH32_FLASH_BASE) / CH32_FLASH_BLOCK;
  }
  ch32_status_t p = ch32_program(&keybit_swio, keybit_image, keybit_image_len, &next_blk);
  if (p == CH32_MORE) {   /* a couple of blocks done; the rest next poll */
    stalls = 0;
    return;
  }
  PROTO_Send("DOCK flash halt=%d verify=%d program=%d acs=%08lx retries=%lu blk=%ld from=%lu", h, v, p,
             (unsigned long)ch32_last_acs, (unsigned long)ch32_retries, (long)ch32_fail_blk,
             (unsigned long)ch32_resume_from);
  if (p == CH32_OK) {
    Keybit_Dock_Done(uid);
    return;
  }
  /* Progress means this attempt got past the block it resumed from. */
  if (ch32_fail_blk > (int32_t)ch32_resume_from) {
    if (ch32_fail_blk > best_blk) best_blk = ch32_fail_blk;
    stalls = 0;
  } else if (++stalls >= 5) {
    dock_state = DOCK_FAILED;
    stalls = 0;
    PROTO_Send("DOCK failed at block %ld", (long)best_blk);
  }
}

static void Keybit_Dock_Poll(void)
{
  static uint32_t last_poll, uid[3];
  static uint8_t misses, settle;

  if (HAL_GetTick() - last_poll < KEYBIT_POLL_MS) return;
  if ((int32_t)(keybit_dock_pause_until - HAL_GetTick()) > 0) return;
  last_poll = HAL_GetTick();

  if (ch32_detect(&keybit_swio) != CH32_OK) {
    settle = 0;
    /* Only call it gone after about a second of misses: detect still drops one now and then. */
    if (dock_state != DOCK_EMPTY && ++misses >= 4) {
      dock_state = DOCK_EMPTY;
      misses = 0;
      PROTO_Send("DOCK gone");
    }
    return;
  }

  if (dock_state == DOCK_EMPTY) {
    /* Wait for three answers in a row (~500 ms) so a board still being seated isn't read half-on. */
    if (++settle < 3) return;
    if (Keybit_Dock_Uid(uid) != CH32_OK) return;
    misses = 0;
    Keybit_Dock_Start(uid);
  } else if (misses) {
    /* It answered again after a gap: the same board carries on where it was,
     * a different one starts over. */
    uint32_t now_uid[3];
    misses = 0;
    if (Keybit_Dock_Uid(now_uid) != CH32_OK) return;
    if (memcmp(now_uid, uid, sizeof(uid)) != 0) {
      memcpy(uid, now_uid, sizeof(uid));
      Keybit_Dock_Start(uid);
    } else if (dock_state != DOCK_WORKING) {
      ch32_reboot(&keybit_swio);  /* back to running its firmware */
    }
  }
  Keybit_Dock_Attempt(uid);
}

/* DOCK? over serial: the raw answers from whatever is on the dock, to debug detection. */
int Keybit_Dock_Probe(uint32_t *cfg, uint32_t *status)
{
  *cfg = *status = 0;
  int r = ch32_detect(&keybit_swio);
  ch32_read_reg(&keybit_swio, CH32_DMCFGR, cfg);
  ch32_read_reg(&keybit_swio, CH32_DMSTATUS, status);
  return r;
}

/* DOCKSCAN: after a successful probe, read DMCFGR n more times and count
 * how many come back exactly as the first good read, to rank timings by
 * how reliably they read rather than by one lucky answer. */
/* n reads alternating DMCFGR and DMHARTINFO against the values a V003
 * gives; returns how many came back right. */
int Keybit_Dock_Reads(int n)
{
  int good = 0;
  for (int i = 0; i < n; i++) {
    uint32_t v = 0;
    uint8_t reg = (i & 1) ? CH32_DMHARTINFO : CH32_DMCFGR;
    uint32_t want = (i & 1) ? 0x002120F4u : 0x5AA50401u;
    if (ch32_read_reg(&keybit_swio, reg, &v) == CH32_OK && v == want) good++;
  }
  return good;
}

/* Halts the core, then n write/read-back round trips through DMDATA0 (four
 * fixed patterns, then an LCG), then lets it run again. Returns how many DATA0 ones matched, or -1 if the halt
 * failed (its result in *hr). The first DATA0 mismatch goes in *bw / *br,
 * and *bad says whether there was one. */
int Keybit_Dock_Score(int n, uint32_t *bw, uint32_t *br, int *bad, int *hr)
{
  static const uint32_t fixed[4] = { 0x00000000u, 0xFFFFFFFFu, 0xAAAAAAAAu, 0x55555555u };
  uint32_t x = 0x12345678u;
  int good = 0;
  *bad = 0;
  *hr = ch32_halt(&keybit_swio, 0);
  if (*hr != CH32_OK) return -1;
  ch32_write_reg(&keybit_swio, CH32_DMABSTRACTAUTO, 0);
  for (int i = 0; i < n; i++) {
    uint32_t w = i < 4 ? fixed[i] : (x = x * 1664525u + 1013904223u), r = 0;
    ch32_write_reg(&keybit_swio, CH32_DMDATA0, w);
    if (ch32_read_reg(&keybit_swio, CH32_DMDATA0, &r) == CH32_OK && r == w) good++;
    else if (!*bad) { *bad = 1; *bw = w; *br = r; }
  }
  ch32_reboot(&keybit_swio);
  return good;
}

/* Detect whatever is on the dock, optionally request a halt (DMCONTROL
 * written twice) and wait delay_ms, then dump the debug module registers
 * (HARTINFO four times) into v[0..7]; 0xEEEEEEEE for a failed read.
 * x=1 or 2 runs ch32_halt (2 with reset) instead of the halt writes and
 * puts its result in *hr. */
int Keybit_Dock_Regs(uint32_t *v, uint32_t delay_ms, int halt, int x, int *hr)
{
  static const uint8_t regs[8] = { CH32_DMSTATUS, CH32_DMHARTINFO, CH32_DMHARTINFO, CH32_DMHARTINFO,
                                   CH32_DMHARTINFO, CH32_DMABSTRACTCS, CH32_DMCFGR, CH32_DMCONTROL };
  int r = ch32_detect(&keybit_swio);
  *hr = 0;
  if (r == CH32_OK && x) *hr = ch32_halt(&keybit_swio, x == 2);
  else if (r == CH32_OK && halt) {
    ch32_write_reg(&keybit_swio, CH32_DMCONTROL, 0x80000001u);
    ch32_write_reg(&keybit_swio, CH32_DMCONTROL, 0x80000001u);
  }
  if (delay_ms) HAL_Delay(delay_ms);
  for (int i = 0; i < 8; i++)
    if (ch32_read_reg(&keybit_swio, regs[i], &v[i]) != CH32_OK) v[i] = 0xEEEEEEEEu;
  return r;
}

/* DOCKRD: halt whatever is on the dock without resetting it, read n words
 * of its memory from addr, then let it run on (resumereq, no reset), so a
 * running Keybit's RAM can be inspected. Returns the halt or read status. */
int Keybit_Dock_Read(uint32_t addr, uint32_t *out, int n)
{
  int r = ch32_halt(&keybit_swio, 0);
  if (r != CH32_OK && ch32_detect(&keybit_swio) == CH32_OK) r = ch32_halt(&keybit_swio, 0);
  for (int i = 0; r == CH32_OK && i < n; i++) r = ch32_read_word(&keybit_swio, addr + 4u * i, &out[i]);
  ch32_write_reg(&keybit_swio, CH32_DMCONTROL, 0x40000001);  /* resumereq */
  ch32_write_reg(&keybit_swio, CH32_DMCONTROL, 0x40000001);
  return r;
}

/* DOCKID: walk detect, halt, chip ID, a few flash and FLASH register reads
 * and the unlock, printing each step's result into out. Stops at the first
 * failure, adding the last DMABSTRACTCS. */
void Keybit_Dock_Id(char *out, size_t len, int reset)
{
  static const struct { const char *name; uint32_t addr; } words[] = {
    { "w0", 0x08000000u }, { "w4", 0x08000004u }, { "ctlr", 0x40022010u }, { "statr", 0x4002200Cu },
  };
  size_t n = 0;
  uint32_t v = 0;
#define STEP(fmt, ...) n += (size_t)snprintf(out + n, n < len ? len - n : 0, fmt, __VA_ARGS__)
#define FAIL(r) do { if (r != CH32_OK) { STEP(" acs=%08lx", (unsigned long)ch32_last_acs); return; } } while (0)
  out[0] = 0;
  int r = ch32_detect(&keybit_swio);
  STEP("detect=%d", r);
  FAIL(r);
  r = ch32_halt(&keybit_swio, reset);
  STEP(" halt=%d", r);
  FAIL(r);
  r = ch32_read_chip_id(&keybit_swio, &v);
  STEP(" id=%d:%08lx", r, (unsigned long)v);
  FAIL(r);
  for (unsigned i = 0; i < sizeof(words) / sizeof(words[0]); i++) {
    v = 0;
    r = ch32_read_word(&keybit_swio, words[i].addr, &v);
    STEP(" %s=%d:%08lx", words[i].name, r, (unsigned long)v);
    FAIL(r);
  }
  r = ch32_unlock_flash(&keybit_swio);
  STEP(" unlock=%d", r);
  FAIL(r);
  v = 0;
  r = ch32_read_word(&keybit_swio, 0x40022010u, &v);
  STEP(" ctlr2=%d:%08lx", r, (unsigned long)v);
  FAIL(r);
#undef STEP
#undef FAIL
}

/* Hand addresses to new Keybits, then refresh the list of who is there. */
static void Keybit_Bus_Poll(void)
{
  static uint32_t held_since;

  /* A backwards Keybit holds SDA low; tell the host once it has lasted
   * BUS_HELD_MS and once it clears, and leave the bus alone meanwhile. */
  uint32_t now = HAL_GetTick();
  if (!keybit_bus_held()) {
    held_since = now;
    if (bus_held) {
      bus_held = 0;
      PROTO_Send("OK BUS clear");
    }
  } else if (!bus_held && now - held_since >= BUS_HELD_MS) {
    bus_held = 1;
    PROTO_Send("ERR bus SDA held low, a Keybit on the Keyword may be turned the wrong way");
  }
  if (keybit_bus_unstick(&hi2c3)) PROTO_Send("OK BUS recovered");
  if (keybit_bus_jammed()) return;
  int f = keybit_bus_service(&hi2c3, keybits, &keybit_count, keybit_remotes, &keybit_remote_count);
  if (f & KEYBIT_CHANGED) {
    keybit_changed = 1;
    KEYMAP_Kick();   /* report it now, not at the next 5 ms tick */
  }
  if (f & KEYBIT_JOINED) white_until = HAL_GetTick() + WHITE_BLINK_MS;
}

/* USER CODE END 0 */

/**
  * @brief  The application entry point.
  * @retval int
  */
int main(void)
{

  /* USER CODE BEGIN 1 */
  keyword_reset_csr = RCC->CSR;   /* why we last reset, for HELLO */
  /* USER CODE END 1 */

  /* MCU Configuration--------------------------------------------------------*/

  /* Reset of all peripherals, Initializes the Flash interface and the Systick. */
  HAL_Init();

  /* USER CODE BEGIN Init */
  MX_APPE_Config();   /* STM32_WPAN: IPCC/backup reset and HSE trim, before the clocks start */
  /* USER CODE END Init */

  /* Configure the system clock */
  SystemClock_Config();

  /* Configure the peripherals common clocks */
  PeriphCommonClock_Config();

  /* USER CODE BEGIN SysInit */
  RCC->CSR |= RCC_CSR_RMVF;   /* after MX_APPE_Config has read them, so the next reset reports only its own cause */

  /* USER CODE END SysInit */

  /* Initialize all configured peripherals */
  MX_GPIO_Init();
  MX_I2C3_Init();
  MX_USB_PCD_Init();
  MX_QUADSPI_Init();
  MX_RF_Init();
  /* USER CODE BEGIN 2 */

  ch32_init(&keybit_swio, BB_SWIO_GPIO_Port, BB_SWIO_Pin);
  LED_Set(1, 1, 1); // white

  /* USER CODE END 2 */

  /* Infinite loop */
  /* USER CODE BEGIN WHILE */
  while (1)
  {
    MX_APPE_Process();  /* STM32_WPAN sequencer: BLE events, keymap, NUS */
    /* USER CODE END WHILE */

    /* USER CODE BEGIN 3 */
    Keybit_Dock_Poll();
    Keybit_Bus_Poll();
    LED_Update();

  }
  /* USER CODE END 3 */
}

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
