notaroomba/keybytes/firmware/keyword/Core/Inc/main.h

#define STATUS_B_Pin GPIO_PIN_12
#define STATUS_B_GPIO_Port GPIOC
#define STATUS_G_Pin GPIO_PIN_0
#define STATUS_G_GPIO_Port GPIOD
#define STATUS_R_Pin GPIO_PIN_1
#define STATUS_R_GPIO_Port GPIOD
#define BB_SWIO_Pin GPIO_PIN_5
#define BB_SWIO_GPIO_Port GPIOB
