notaroomba/keybytes/firmware/keyword/STM32_WPAN/App/ble_conf.h

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

/* Define to prevent recursive inclusion -------------------------------------*/
#ifndef BLE_CONF_H
#define BLE_CONF_H

#include "app_conf.h"

/******************************************************************************
 *
 * BLE SERVICES CONFIGURATION
 * blesvc
 *
 ******************************************************************************/

/**
 * This setting shall be set to '1' if the device needs to support the Peripheral Role
 * In the MS configuration, both BLE_CFG_PERIPHERAL and BLE_CFG_CENTRAL shall be set to '1'
 */
#define BLE_CFG_PERIPHERAL                                                     1

/**
 * This setting shall be set to '1' if the device needs to support the Central Role
 * In the MS configuration, both BLE_CFG_PERIPHERAL and BLE_CFG_CENTRAL shall be set to '1'
 */
#define BLE_CFG_CENTRAL                                                        0

/**
 * There is one handler per service enabled
 * Note: There is no handler for the Device Information Service
 *
 * This shall take into account all registered handlers
 * (from either the provided services or the custom services)
 */
#define BLE_CFG_SVC_MAX_NBR_CB                                                 7

#define BLE_CFG_CLT_MAX_NBR_CB                                                 0

/******************************************************************************
 * Device Information Service (DIS)
 ******************************************************************************/
/**< Options: Supported(1) or Not Supported(0) */
#define BLE_CFG_DIS_MANUFACTURER_NAME_STRING                                   1
#define BLE_CFG_DIS_MODEL_NUMBER_STRING                                        1
#define BLE_CFG_DIS_SERIAL_NUMBER_STRING                                       0
#define BLE_CFG_DIS_HARDWARE_REVISION_STRING                                   0
#define BLE_CFG_DIS_FIRMWARE_REVISION_STRING                                   1
#define BLE_CFG_DIS_SOFTWARE_REVISION_STRING                                   0
#define BLE_CFG_DIS_SYSTEM_ID                                                  0
#define BLE_CFG_DIS_IEEE_CERTIFICATION                                         0
#define BLE_CFG_DIS_PNP_ID                                                     0

/**
 * device information service characteristic lengths
 */
#define BLE_CFG_DIS_SYSTEM_ID_LEN_MAX                                        (8)
#define BLE_CFG_DIS_MODEL_NUMBER_STRING_LEN_MAX                              (32)
#define BLE_CFG_DIS_SERIAL_NUMBER_STRING_LEN_MAX                             (32)
#define BLE_CFG_DIS_FIRMWARE_REVISION_STRING_LEN_MAX                         (32)
#define BLE_CFG_DIS_HARDWARE_REVISION_STRING_LEN_MAX                         (32)
#define BLE_CFG_DIS_SOFTWARE_REVISION_STRING_LEN_MAX                         (32)
#define BLE_CFG_DIS_MANUFACTURER_NAME_STRING_LEN_MAX                         (32)
#define BLE_CFG_DIS_IEEE_CERTIFICATION_LEN_MAX                               (32)
#define BLE_CFG_DIS_PNP_ID_LEN_MAX                                           (7)

/******************************************************************************
 * Battery Service (BAS)
 ******************************************************************************/
#define BLE_CFG_BAS_NUMBER                                                     1
#define BLE_CFG_BAS_LEVEL_NOT_PROP                                             1   /**< Battery Level characteristic Notification property*/


/******************************************************************************
 * Human Interface Device Service (HIDS)
 ******************************************************************************/
#define BLE_CFG_HIDS_NUMBER                                                    1
#define BLE_CFG_HIDS_REPORT_MAP_MAX_LEN                                       128
#define BLE_CFG_HIDS_REPORT_REFERENCE_LEN                                      2
#define BLE_CFG_HIDS_REPORT_MAX_LEN                                           8
#define BLE_CFG_HIDS_EXTERNAL_REPORT_REFERENCE_LEN                             2
#define BLE_CFG_HIDS_BOOT_KEYBOARD_INPUT_REPORT_MAX_LEN                       80
#define BLE_CFG_HIDS_BOOT_KEYBOARD_OUTPUT_REPORT_MAX_LEN                      80
#define BLE_CFG_HIDS_BOOT_MOUSE_INPUT_REPORT_MAX_LEN                          80
#define BLE_CFG_HIDS_INFORMATION_LEN                                           4
#define BLE_CFG_HIDS_CONTROL_POINT_LEN                                         1
#define BLE_CFG_HIDS_PROTOCOL_MODE_LEN                                         1

#define BLE_CFG_HIDS_PROTOCOL_MODE_CHAR                                        0 /**< Support of Protocol Mode Characteristic */
#define BLE_CFG_HIDS_INPUT_REPORT_NB                                           2 /**< Number of Input Report */
#define BLE_CFG_HIDS_INPUT_WRITE                                               0 /**< Support of Input Write property */
#define BLE_CFG_HIDS_OUTPUT_REPORT_NB                                          0 /**< Number of Output Report */
#define BLE_CFG_HIDS_FEATURE_REPORT_NB                                         0 /**< Number of Feature Report */
#define BLE_CFG_HIDS_EXTERNAL_REPORT_REFERENCE                                 0 /**< Support of EXTERNAL REPORT Reference Descriptor */
#define BLE_CFG_HIDS_KEYBOARD_DEVICE                                           0 /**< Support of BOOT KEYBOARD Report Characteristic */
#define BLE_CFG_HIDS_KEYBOARD_INPUT_WRITE                                      0 /**< Support of Keyboard Input Write property */
#define BLE_CFG_HIDS_MOUSE_DEVICE                                              0 /**< Support of BOOT MOUSE Report Characteristic */
#define BLE_CFG_HIDS_MOUSE_INPUT_WRITE                                         0 /**< Support of Mouse Input Write property */
#define BLE_CFG_HIDS_REPORT_CHAR               BLE_CFG_HIDS_INPUT_REPORT_NB   +\
  BLE_CFG_HIDS_OUTPUT_REPORT_NB  +\
  BLE_CFG_HIDS_FEATURE_REPORT_NB
#define BLE_CFG_HIDS_PROTOCOL_MODE                                             1 /**< Report Protocol Mode */

/******************************************************************************
 * GAP Service - Appearance
 ******************************************************************************/

#define BLE_CFG_UNKNOWN_APPEARANCE                                           (0)
#define BLE_CFG_HID_MOUSE_APPEARANCE                                       (962)
#define BLE_CFG_HID_KEYBOARD_APPEARANCE                                    (961)
#define BLE_CFG_GAP_APPEARANCE                 (BLE_CFG_HID_KEYBOARD_APPEARANCE)

#endif /* BLE_CONF_H */
