notaroomba/keybytes/(commit log)

2025-12-19 keybites test
    [BOM.csv, keybyte.kicad_pcb, keybyte.kicad_sch]
2026-03-29 before flip
    [BOM.csv, keybit.kicad_pcb, keybit.kicad_sch, keybyte.kicad_pcb, keybyte.kicad_sch, keyword.kicad_pcb, keyword.kicad_sch]
2026-04-04 add in stuff
    [keybit.kicad_pcb, keybit.kicad_sch, keyword.kicad_pcb, keyword.kicad_sch]
2026-04-08 finish case and stuff
2026-10-16 updated cad
2026-10-21 journal: boards came, resin printing, flashing and case iterations, rename journal images
2026-10-25 final magnet cases: J7 keybit, J7.1b keyword, joint tests in cad/tests
2026-10-25 switch test and production cases to STEP only, drop STLs
2026-10-25 journal: add J7 keybits frame to oct 23
2026-10-25 journal: magnets falling out photo on oct 21
2026-10-26 app: Keyword Monitor desktop app
    Electron app that connects to the Keyword over USB serial or Bluetooth
    (Nordic UART), shows which sides have a Keybit live, assigns any key or
    shortcut to each Keybit by UID, and keeps keymap profiles with
    import/export. Includes a demo mode and PROTOCOL.md for the firmware.
2026-10-26 firmware: vendor STM32_WPAN BLE middleware from STM32CubeWB 1.24.0
    Copied from STM32CubeWB 1.24.0 (stm32-mw-wpan at 1a66948): the BLE core
    and ACI wrappers, the BAS/DIS/HIDS services and svc_ctl, the shci and
    transport layer, the sequencer and tiny_lpm. Only what the keyword's
    BLE app uses.
    hids.c is patched so input report IDs start at 1 instead of 0, so a
    report map can carry both a keyboard and a consumer report.
2026-10-26 firmware: BLE HID keyboard and NUS config channel
    The keyword now advertises as "Keyword" (HID keyboard appearance) and
    pairs Just Works with bonding. GATT has HID over GATT (8 byte keyboard
    report + 16-bit consumer report), Battery, Device Information and the
    Nordic UART Service.
    - app_entry.c boots CPU2 and runs the sequencer. main.c only gets three
    calls in USER CODE sections: MX_APPE_Config, MX_APPE_Init and
    MX_APPE_Process in the main loop, next to the Keybit polling.
    - keymap.c watches keybits[] from main.c every 5 ms by UID, sends a 6KRO
    report from the mapped mods/keys of every held Keybit, and emits the
    KEY+/KEY-/PRESS/SIDES events. The table (32 entries, keyed by the
    96-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
2026-10-26 firmware: USB CDC serial with the same config protocol as NUS
    The keyword is now also a USB CDC serial port (0483:5740, "Keyword")
    on PA11/PA12, which the schematic routes to the USB-C connector. It
    speaks the same line protocol as NUS.
    - Adds ST's USB device library (core + CDC) from STM32CubeWB 1.24.0.
    usbd_conf.c reuses the hpcd_USB_FS that main.c's CubeMX code already
    initialises. USB runs off HSI48 trimmed by CRS (USER CODE in the USB
    MSP init), holding the CLK48 semaphore so CPU2 leaves it alone.
    - CDC RX is queued from the ISR into a ring and parsed by a sequencer
    task. The OUT endpoint is only re-armed when there's room for a full
    packet, so nothing is dropped. TX is a rin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
2026-10-26 app: protocol extensions, macros, profile library and undo history
    Parse caps/kb, battery, hold, macro, flash progress and relayed Keybits
    (at=X via= depth=). Text-to-macro and key search in the HID tables.
    Profiles gain macro/hold/computer actions, per-app rules, settings,
    press stats, library export and an undo history. Ready-made templates.
2026-10-26 app: tray, menus, per-app watcher and computer actions
    Menu bar/tray with profile switching and battery, a full app menu with
    shortcuts, frontmost-app detection for per-app profiles, open URL/app or
    run a command on key press, single instance and remembered window size.
2026-10-26 app: redesigned UI with macros, hold actions, settings and undo
    Assign dialog with shortcut, macro and computer-action tabs, key search
    and hold actions. Auto-reconnect, battery and firmware pills, Keybit
    reflash, Move to for swapped Keybits, drag-and-drop import with a check
    for imported commands, light/dark theme, toasts with undo.
2026-10-26 app: packaging, icon and docs
    npm run dist builds a dmg/installer/AppImage with the macOS Bluetooth
    usage strings. README covers the new features; PROTOCOL.md documents
    the optional caps, CDC details and relayed Keybits.
2026-10-26 firmware: HELLO lists optional caps
    HELLO now replies KEYWORD v=<fw> proto=1 caps=hold,macro. caps only
    names what this firmware does, so the desktop app can hide the rest.
    batt joins once the battery reading lands. kb= (the embedded Keybit
    image version) is left out until keybit_image.h exports one.
2026-10-26 firmware: battery level from the BQ25895 (BATT?)
    Reads the charger on I2C3 at 0x6A once a second from the key task,
    through the Keybit thread's keybit_bus_read/keybit_bus_write.
    - The only write turns on the ADC (REG02 CONV_RATE, 1 s continuous)
    and leaves every other REG02 bit as it was, except the self-clearing
    CONV_START and FORCE_DPDM triggers, which are never written back as 1.
    CONV_RATE is cleared by the charger's watchdog, so it's checked every
    poll and turned back on. The first reading after that is skipped,
    since it's still the stale default.
    - VBAT from REG0E (2.304 V + 20 mV/LSB) goes through a piecewise
    linear LiPo curve to pct. chg is CHRG_STAT pre-charge or fast ch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
2026-10-26 firmware: HELLO reports the embedded Keybit image version (kb=)
    HELLO now ends in kb=<n>, keybit_image_version from the Keybit thread's
    keybit_image.h: the firmware this keyword flashes onto docked Keybits.
    The desktop app can compare it with each Keybit's v= to spot outdated
    ones.
2026-10-26 firmware: remote Keybits relayed through other Keybits
    Keybits further out come in through keybit_remotes[] from the Keybit
    thread's relay code and now work like touching ones: they type, and
    they show up in the protocol.
    - KEY+ uid=.. at=X via=<touching Keybit's uid> depth=<n> when one turns
    up (and in KEYS?), KEY- when it goes quiet, PRESS on each press. The
    uid is the full 24 hex digits when the keymap or an earlier direct
    sighting knows them, otherwise the 8 the remote reports. dirty is
    cleared once handled.
    - The table moves into a HAL-free keytable.c, keyed by keyid_t (a full
    96-bit UID, or just the low 32 bits). uid= takes 24 or 8 hex digits,
    and replies echo the form giv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
2026-10-26 firmware: flash Keybits over SWIO, Keybit firmware with soft I2C and relaying
    Drivers/CH32V003 drives WCH's one-wire debug on BB_SWIO to detect, halt and
    flash a Keybit on the dock. keybit/ is the CH32V003 firmware: four
    bit-banged I2C sides, keyword-assigned addresses saved by UID, and a relay
    tree so Keybits not touching the keyword forward key state inward.
    keybit_bus.c assigns addresses, scans I2C3 and drains relayed events into
    keybit_remotes[].
2026-10-26 keybit: custom link protocol between Keybits
    Keybit-to-Keybit links drop I2C for a doorbell-and-burst protocol on the
    same two pins (link.c). Handshake stays open-drain; the frame itself is
    push-pull at about 1 Mbit/s with a CRC-8. A child with events rings its
    parent by holding DT low, so a press moves a hop in well under 1 ms
    instead of waiting for the 5 ms poll. Keybit firmware version 4.
2026-10-26 firmware: OTA bootloader in ota_bootloader/, adapted from ST's BLE_Ota
    A separate project in pages 0-6 (0x08000000-0x08006FFF, 13.7 KB of
    28 KB) based on ST's BLE_Ota from STM32CubeWB 1.24.0. On every reset
    it jumps straight to the app at 0x08007000 if the app is valid (ST's
    0x94448A29 tag check). It only stays and advertises "Keyword OTA"
    when there's no valid app or the app asked for an update.
    Changes from ST's, mostly for safety:
    - The erase before a download stops at the keymap page (SFSA - 1)
    instead of SFSA, and refuses to start below page 7 (ST's check let
    page 6, part of the loader, through). It retries until every page is
    erased.
    - otas_app.c is rewritten with the same GATT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
2026-10-26 firmware: app at 0x08007000 behind the OTA bootloader, OTA/DFU/STACK? commands
    - The linker script moves the app to 0x08007000 and stops it before the
    keymap page (0x080CF000). ota.c holds ST's validity tag: the address
    at app + 0x140, and 0x94448A29 placed after everything that loads
    from flash, so a cut-off OTA never looks valid.
    USER_VECT_TAB_ADDRESS + VECT_TAB_OFFSET=0x7000 make SystemInit set
    VTOR.
    - OTA (NUS and CDC) replies OK OTA, then 500 ms later leaves ST's boot
    request in SRAM1 (reboot on OTA loader, erase from page 7) and
    resets. It refuses with an error when CPU2 has no BLE stack, since the
    loader needs it.
    - DFU replies OK DFU and resets into ST's ROM USB DFU b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
2026-10-26 firmware: release images for the one-time DFU install and OTA
    Built from 2da7ebe with xPack arm-none-eabi-gcc 15.2.1 via make -C
    ota_bootloader release. A clean checkout reproduces the same bytes.
    - keyword_full.bin/.hex: OTA bootloader at 0x08000000, 0xFF to
    0x08007000, app at 0x08007000. It ends at 0x0801664C (23 pages) and
    is checked byte by byte by tools/merge.py.
    - keyword_app.bin: the app alone, for OTA at 0x7000.
    SHA256SUMS lists all three.
2026-10-26 firmware: app installs the CPU2 stack itself, crash fallback to DFU
    The CPU2 BLE stack gets installed without -startfus or -fwupgrade over USB
    DFU (CubeProgrammer's USB -startfus rewrote nSWBOOT0 on this board).
    stm32wb5x_BLE_Stack_full_fw.bin 1.24.0 is written over DFU as plain data
    to 0x080D0000, and the app does the rest:
    - fus.c / stackimg.c: when CPU2 comes up running only FUS, the app
    checks 0x080D0000 for ST's image footer (0x12341234 0xABCDABCD
    0xFFFF5740 <info> 0xD3A12C5E, as in ST's FUS and stack binaries). 3 s
    later, once USB CDC is up, it asks FUS to install the image
    (SHCI_C2_FUS_FwUpgrade, ST's CPU1-driven path), prints STACK PROGRESS
    lines, and resets when done. If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
2026-10-26 firmware: release images with the stack installer and crash fallback
    Built from b6aa161 (xPack arm-none-eabi-gcc 15.2.1, make -C
    ota_bootloader release). A clean checkout reproduces the same bytes.
    keyword_full.bin: bootloader 13929 B + app 65292 B at 0x08007000,
    93964 B in all, ending at 0x08016F0C.
2026-10-26 firmware: make complete, one file with bootloader, app and BLE stack
    tools/complete.py writes release/keyword_complete.hex and .dfu (DfuSe,
    one element per segment): bootloader at 0x08000000, app at 0x08007000,
    stm32wb5x_BLE_Stack_full_fw.bin 1.24.0 at 0x080D0000. Gaps aren't in the
    files, so the keymap page and FUS are never written. The stack's SHA-256
    is checked and --check decodes both files back to the three images.
    ST's SLA0044 covers the stack, so the outputs are ignored, not committed.
    Release images rebuilt with BOOTLOCK.
2026-10-26 firmware: README recommends BOOT0 to GND through 10k, BOOTLOCK optional
2026-10-26 firmware: leave a backwards Keybit's lines alone
    A Keybit turned the wrong way round puts its GND on our SDA and its 3V3
    on our SCL. Every SCL low we drive then pulls its supply down through
    its SCL clamp diode (tens of mA against a 4 mA rating) or shorts the
    rail through our own pin.
    Keybit (fw v5): never probe a side that shows DT low with CK high unless
    it is already a link; link_poll also refuses to start there.
    Keyword: when I2C3 SDA sits low with SCL high, pause all bus traffic
    (one retry a second, so a Keybit stuck mid-byte still gets clocked
    free), blink the LED red and send "ERR bus SDA held low ..." and later
    "OK BUS clear" to the host.
2026-10-28 Report a Keybit turned the wrong way round next to another Keybit
    A backwards neighbour leaves a side with DT low and CK high that never
    becomes a link. Keybit fw v6 calls that side backwards after 200 ms,
    shows the sides in reg 0x09 and sets bit 2 on every event it queues
    (and queues one at once when it changes), so it relays inward.
    The Keyword reads reg 0x09 from touching Keybits on each scan and the
    event bit from relayed ones, and sends
    "BACKWARDS uid=<uid> sides=<NESW|?|->" to the host. The app shows a
    toast, an activity line and a "backwards neighbour" badge on the key.
2026-10-28 release: rebuild Keyword images from current firmware
2026-10-28 keyword: fix SWIO dock flashing (separate write timing, verified writes, resume)
    The dock could halt a CH32V003 but never flash it. Writes were the problem:
    the "1" low pulse needed its own width, and even tuned about 1 write frame
    in 10 is dropped. Split the write timing into a/b/h with working defaults,
    read back every register write, catch dropped commands via DATA1, retry per
    block and resume by chip UID. Adds DOCKSCAN/DOCKREG/DOCKID for debugging.
2026-10-28 keyword: reliable dock detect/halt/verify, blink green once, push-pull read kick
    Detect, halt and the HARTINFO check re-read once or twice instead of trusting
    a single garbled frame, and verify re-reads a word that differs before calling
    it a mismatch. Halting no longer resets the chip, which lost the line with the
    Keybit firmware running. A done board now needs 8 misses in a row before it
    counts as removed, so it blinks green once. DOCK? k= sets the push-pull read
    kick (0 = none).
2026-10-28 keyword: dock works without the 1k pull-up, LED states for the dock
    Push-pull is now the default: bits are driven, and for a read the line is
    just released onto the internal pull-up and sampled late (~500 ns), which a
    dock without the external 1k needs. The halt re-asks a few times and resume
    only trusts a UID that reads the same twice. DOCKSCAN sweeps the sample
    point too.
    The dock poll is a small state machine: blue while flashing, blink then
    solid green when done, red after 5 attempts in a row make no progress. A
    board only counts as removed after about a second of misses, and one that
    comes back with the same UID keeps its state.
2026-10-28 keyword: remember flashed boards, double-check mismatches, fix dock give-up
    A board flashed or verified since boot goes straight to green when it comes
    back. A verify mismatch has to show up twice before a reflash, and its
    address and values are printed. An attempt only counts as stuck when it gets
    no further than the block it resumed from.
2026-10-28 keyword: let a docked board settle before reading or verifying it
    Wait for three answers in a row before reading the UID, reject an all-1s or
    all-0s UID, and give a board whose first words read blank about a second
    before treating it as erased.
2026-10-28 keyword: I2CSCAN and I2CRD serial commands for the side bus
2026-10-28 keybit: never probe the keyword's side, time I2C waits on SysTick (v7)
    A side that carried the keyword's I2C stopped counting as the keyword's
    after 2 s without being addressed. The Keybit then probed it for a link by
    pulling CK low, which is SCL low on the keyword's bus, so the keyword could
    no longer address it and the bus stayed jammed. That side now stays the
    keyword's until power is lost. The I2C target's waits are timed on SysTick
    (about 2 ms) instead of loop counts, and it lets go of both lines after
    every transaction. Image regenerated for the keyword.
2026-10-28 keyword: side bus at 20 kHz, clock a stuck bus free, I2CSPEED command
    The Keybits' software I2C target misses bits at 100 kHz. If SCL sits low
    with the bus idle for over 5 ms, I2C3 is turned off, clocked 9 times and
    given a STOP by hand, then turned back on.
2026-10-28 keyword: side bus I2C timeouts for 20 kHz, keep a Keybit through a missed scan
    At 20 kHz a full relay read takes ~19 ms, so the 10 ms timeout cut every
    one short and chained Keybits never showed up. And one missed scan dropped
    a Keybit, so a busy one blinked in and out about once a second.
2026-10-29 keyword: keep the side scan inside the watchdog, RST? reports the reset cause
    Address-only probes go back to a 3 ms timeout (the 50 ms one let a bad
    bus stretch one scan past the bootloader's ~8 s IWDG) and the scan loop
    feeds the watchdog. The reset flags are saved at boot and then cleared, so
    RST? shows what caused the last reset instead of every flag since power-up.
2026-10-29 keyword: redo the SWIO handshake between block retries, sample at s=38
    A block that failed once kept failing all 8 tries, while the next attempt
    (which starts with a detect) got past it at once, so the retry now redoes
    the handshake too. Every dock mismatch was 1s read as 0s, so the push-pull
    read samples later (~640 ns) to give the internal pull-up more time.
2026-10-29 keybit: only being addressed marks the keyword's side (v8)
    Any address byte used to mark a side as the keyword's bus, and since v7
    that sticks. Contact bounce or a link frame from a neighbour being pushed
    on could clock one in, so that side never formed a link and a chained
    Keybit never showed up. Image regenerated for the keyword.
2026-10-29 keyword: dock keeps its own resume point, don't give up on halt runs
    The resume point lived in ch32_program and was tied to a UID read in every
    call, so one garbled UID read started a nearly done board over. The dock
    now keeps it per docked board and starts at the first block the full check
    finds wrong. A failed halt no longer counts as a stuck attempt (halts fail
    in runs and then go through); the dock gives up after ~15 s of them.
2026-10-29 keyword: lighter side bus polling so chained Keybits can link, place N-facing Keybits on the right
    At 20 kHz one register read takes ~2 ms and every Keybit sits through every
    transfer in its software I2C target. Polling keys every 5 ms (plus relay
    reads and a 250 ms scan) kept the bus close to 100% busy, and a Keybit
    gives up a link request to its neighbour whenever the bus is active, so a
    chained Keybit never joined once two or more were on the Keyword. Keys are
    now read every 15 ms, relayed events every 60 ms, the full scan every 500 ms.
    A Keybit turned with its N side to the keyword can only be on the right.
2026-10-29 keybit: only give up a link request when the keyword addresses us, link counters (v9)
    A parent waiting for its neighbour to answer a link request dropped it as
    soon as anything happened on the keyword's bus, and with several Keybits
    on it that's nearly always. Traffic for other Keybits no longer cuts the
    request short. Each side also counts link requests, answers, no-acks,
    aborts, bad frames and frames served as a child (regs 0x30-0x4F), and the
    keyword's LINKS? <addr> prints them. Image regenerated for the keyword.
2026-10-29 keybit: probe timing can't get stuck across a SysTick wrap (v10), DOCKRD
    relay() compared the side's next poll tick with a signed difference.
    SysTick wraps every ~12 min, so a due tick more than ~6 min old (never set,
    or a side skipped that long) looked like it was in the future and the side
    was not probed again for up to 6 minutes, so a chained Keybit often never
    linked. It now keeps the last poll time and uses the same unsigned
    time-since check as everything else. The keyword's DOCKRD <addr> <n> reads a
    docked chip's memory while it keeps running. Image regenerated.
2026-10-29 keyword: white join blink for chained Keybits too
2026-10-29 keyword: don't lose taps shorter than the key poll
    A direct Keybit's key is read as a level every 15 ms, so a quick tap could
    fall between two reads. Every Keybit also queues its own key changes, so a
    press event the poll never saw followed by its release now plays back as a
    tap. Chained Keybits had the same problem when a press and its release
    arrived in one relay batch; that also plays back as a tap now.
2026-10-29 app: draw chained Keybits on the board, fit it to the panel, animate Keybits in and out
    The board was a fixed three-slot grid, so chained Keybits only showed in the
    key list. It's now laid out from positions (lib/layout.ts): direct Keybits in
    their side slots, chained ones straight out from the Keybit they came
    through, dashed to show the position is a guess until the firmware reports
    where they are. The board scales down to fit and back up, new Keybits pop
    in, removed ones pop out, the rest slide to their places, and all of it
    stays still with reduced motion. The demo chains two Keybits off the right one.
2026-10-29 journal: oct 25-28, SWIO dock flashing, chain fixes, next keybit ideas
2026-10-29 journal: magnet pogo sketches on oct 27
2026-10-29 app: board on a grid with a square Keyword, sort out Keybits turned 90 degrees
    The Keyword is the same size as a Keybit, so the board is now a grid of
    equal cells and a Keyword in the corner of a block works. Two Keybits
    reported on the same side (a turned one on top looks like one on the left
    to the Keyword) no longer hide each other: the second goes on the other
    side it could be on, and a button on the tile swaps it, remembered per
    Keybit. Chained Keybits go on a free cell next to the one before them,
    preferring the cell that touches the most Keybits, so a square closes up.
2026-10-29 app: a button on chained Keybits to move them to the spot they're really in
    Until the firmware reports where a chained Keybit is, its spot is a guess.
    The move button steps it through the free cells next to the Keybit it's
    attached to, remembered per Keybit.
2026-10-29 Revert "app: a button on chained Keybits to move them to the spot they're really in"
    This reverts commit 9c56d27cdde631104e0f2b704f734d156ca1fba1.
2026-10-29 app: put chained Keybits exactly where they say they are, turned the right way
2026-10-29 fix case
2026-10-29 keyword: side bus a little per pass, a gap before each transfer, chained Keybits drained every 15 ms
    The address scan used to block the loop for ~60 ms every 500 ms. It now
    looks at one address per pass, never on a pass with other transfers, and
    known Keybits only need their head read. Keybits that relay chained ones
    are drained every 15 ms instead of 60. Each transfer waits 200 us of idle
    bus first: a Keybit finishes its main loop pass after a transfer before it
    looks for the next START, so back-to-back transfers were often NACKed. A
    Keybit only drops off the list when no read of any kind has worked for a
    second. Key changes run the keys task right away.
2026-10-29 keybit v12: report a press within a few reads, watch the keyword's bus between every step, status stream at 0xE0
    A key change counts after 3 reads in a row agree, then the pin is left
    alone for 5 ms of contact bounce (it took 200 main loop passes, ~6 ms).
    The keyword's bus is checked between every main loop step: its START
    only lasts one SCL high and a whole pass took longer. Reading from 0xE0
    gives key state, event count and 5-byte events in one go, and drops the
    events a finished read covered (not past one carrying a new place, which
    goes at 0x80). A ringing child acks a link request by letting go of DT
    instead of a 3 us pulse its parent could miss. Link counters wrap.
2026-10-29 keyword: v12 Keybits read with one status stream read, bus up to 100 kHz while every touching Keybit is v12, I2CSPEED takes sdadel
2026-10-29 keyword: v12 stream reads take events whole, bus steps down 100/50/20 kHz when reads fail, slots scale with the bus speed, SDADEL 8
2026-10-29 keybit v12: numbered events with a CRC in the status stream, no doorbell answers with a full queue, only a UID read can take an address away
    The stream at 0x7F gives each event a 7-bit number and a CRC-8 and checks
    the status byte; reading from 0x80 | n drops the events before n, so the
    keyword says what it has, asking twice drops nothing more, and an event
    that came through damaged is sent again (no phantom keys from noise).
    With no room for a batch a parent leaves a ringing child alone: answering
    kept it in frames that took nothing while the keyword's reads went
    unanswered, so it never drained. Losing a bit while answering only gives
    the address up on a UID read; elsewhere it's more likely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
2026-10-29 keyword: v12 stream with event numbers and CRCs, scans keep each Keybit's live entry, addresses never handed out twice
    A scan used to put back the copy of each Keybit it took when it passed its
    address, up to a scan old, which brought back keys let go since (a ghost
    press now and then) and an address the Keybit had since lost. A free
    address must also not be on the list or handed out in the last 5 s: a
    Keybit busy with a link frame can miss the probe. Reads in a scan are
    retried right away when the Keybit answered its probe.
2026-10-29 readme: which sides connect, the status LED and updating keybits
2026-10-29 keyword: drop the blocking scan and relay drain, keybit_bus_service does both
2026-10-29 sim: build and run on Linux x86_64 too
    Adds an x86_64 coroutine switch, and the Makefile picks the switch,
    shared-object flags and sed syntax for the host. Each Keybit copy is
    linked with -Bsymbolic so it keeps its own globals.
2026-10-29 sim: charge the Keybit's CRC work, which shows v12's late CRC byte
    Computation was free in the sim, so it never saw what the Keybits do on
    the bench: the status stream works out an event's CRC-8 (~120 cycles a
    byte) after the Keyword has already started clocking that byte, so the
    CRC arrives one bit late, the Keyword rejects the event, and the queue
    never drains. link.c is now built with its CRC renamed and node.c
    charges each call (CRC_CYCLES overrides it).
    With that, today's v12 Keybits (make node_v12.bundle) fail a 5-deep
    chain the same way the bench does: queues full, chained Keybits missing
    or dropping out, presses lost. settle() also fails if joining takes
    2.5 s or more.
2026-10-29 sim: fix the suite's failure count, print the bus speed really used
    A forked scenario started with the parent's failure count, so one
    failing scenario made every later one fail too. The end-of-scenario line
    now gives the fastest clock the Keyword actually ran, not just the
    fallback step, and v10 builds get a fallback CRC to link against.
2026-10-29 keyword: take v12's late CRC byte, run fast only with v13 Keybits
    A v12 Keybit works out an event's CRC after the Keyword has started
    clocking that byte. For an 11-byte position event that takes longer than
    SCL's low phase, so the CRC arrives a bit late (0xAA came back as 0xD5 on
    the bench) and the Keyword threw the event away and asked again forever.
    The queue behind it never drained, so chained Keybits' heartbeats stalled
    and they dropped out every few seconds, and their positions never came.
    For fw < 13, accept the CRC shifted by one bit, take that event, and read
    the rest next time (that Keybit took our next bit for a NACK). The fast
    clock is now only for v13, which holds SCL instead, s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
2026-10-29 app: chained Keybits named by a short UID find their parent, HELLO asked again until answered, the latest ⇄ choice wins
2026-10-29 keyword: a USB keyboard as well as the serial port, typing from the saved keymap with or without the app
    The Keyword now enumerates as a composite device: the CDC port the app
    uses, unchanged, and a HID keyboard with a consumer report for media keys.
    While a computer has it enumerated, key reports go out over USB instead of
    Bluetooth, so a computer connected both ways doesn't get every key twice.
    The keymap is the one in flash, which the app saves after every profile
    it sends.
2026-11-10 remvoe this to foxus on just hall
