notaroomba/keybytes/(notices)

Notices in the files:
firmware/keyword/STM32_WPAN/App/tl_dbg_conf.h:
Copyright (c) 2020-2021 STMicroelectronics.
All rights reserved.
firmware/keyword/Core/Inc/main.h:
Copyright (c) 2026 STMicroelectronics.
